jeroenweij/kat/Inspiratie.png

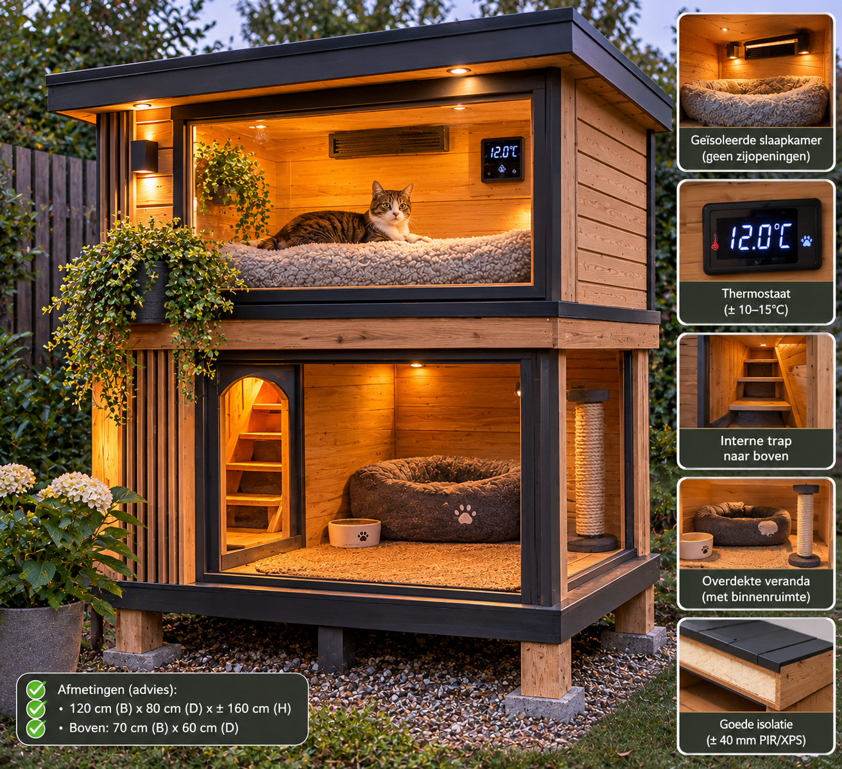
Inspiratie.png
