jeroenweij/kat/bouwplan/Kattenchalet_mal_trapboom.pdf

## Mal trapboom, ware grootte (1:1) - blad 1 van 4

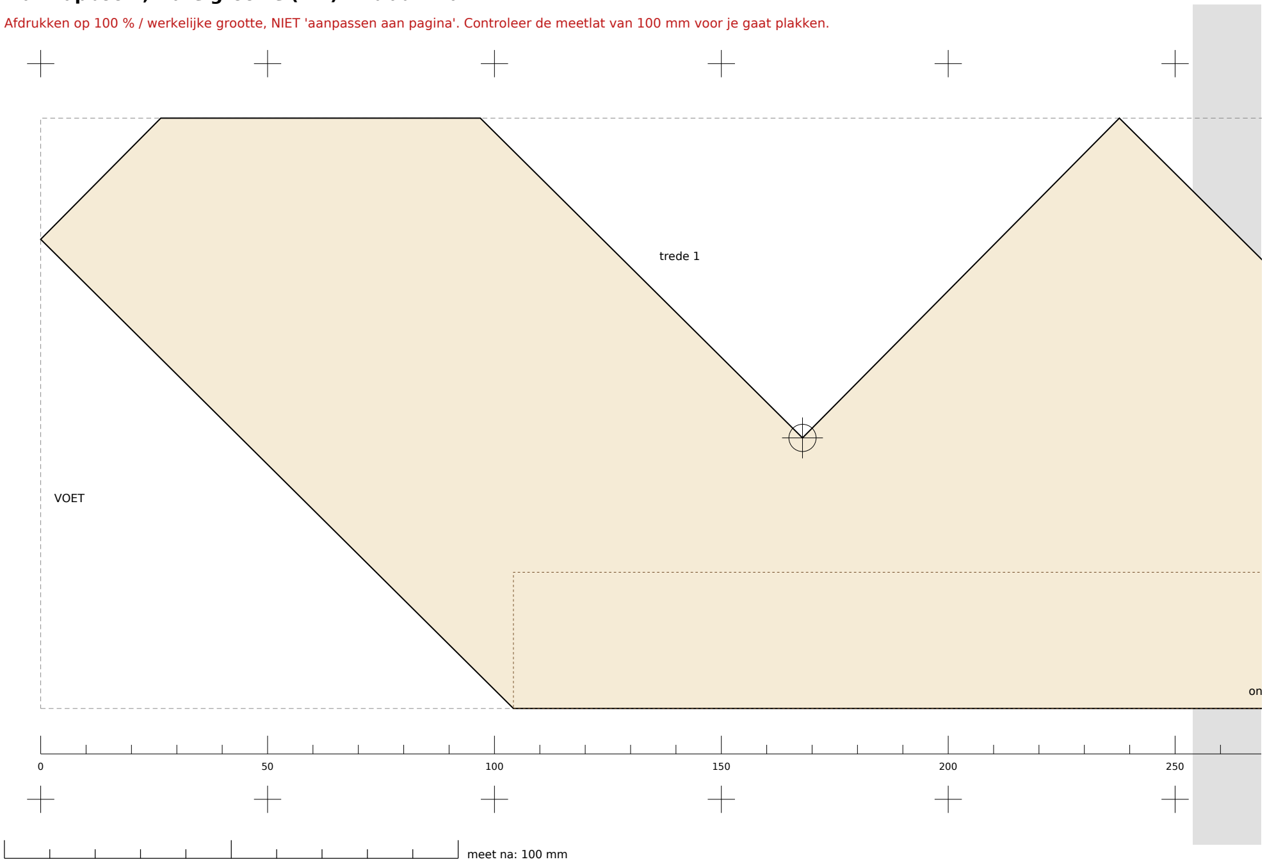
[picture p2: figure]
VOET; trede 1; trede 2; trede 3; trede 4; meet na: 100 mm

Afdrukken op 100 % / werkelijke grootte, NIET 'aanpassen aan pagina'. Controleer de meetlat van 100 mm voor je gaat plakken.

PLAKRAND: leg de knipkant van blad 2 op de lijn

onderkant = rechte kant van het plaatstuk: niet zagen

## Mal trapboom, ware grootte (1:1) - blad 2 van 4

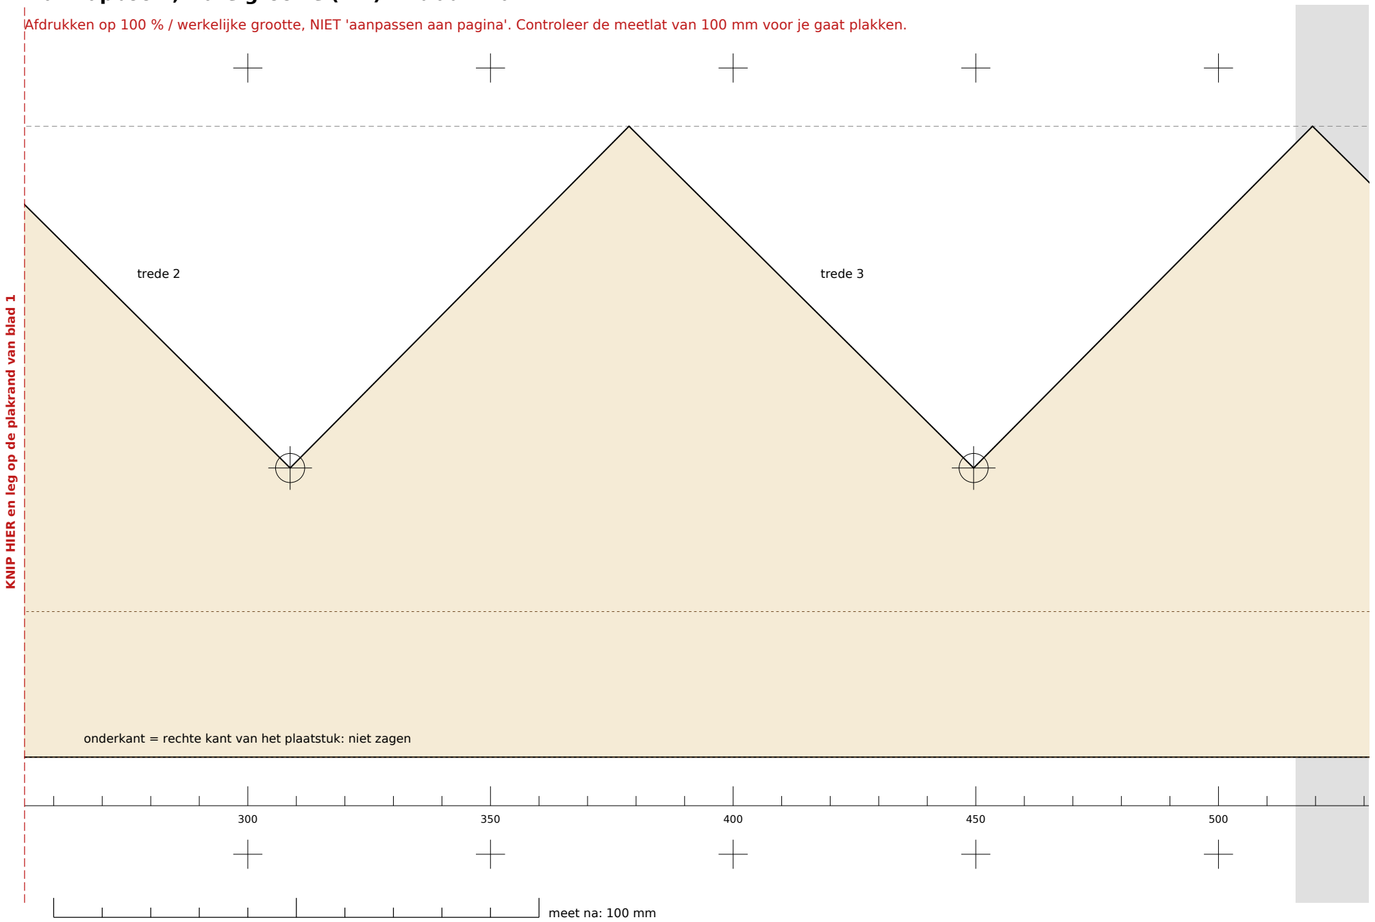
[picture p3: figure]
trede 1; trede 2; trede 3; trede 4

PLAKRAND: leg de knipkant van blad 3 op de lijn

onderkant = rechte kant van het plaatstuk: niet zagen

KNIP HIER en leg op de plakrand van blad 1

## Mal trapboom, ware grootte (1:1) - blad 3 van 4

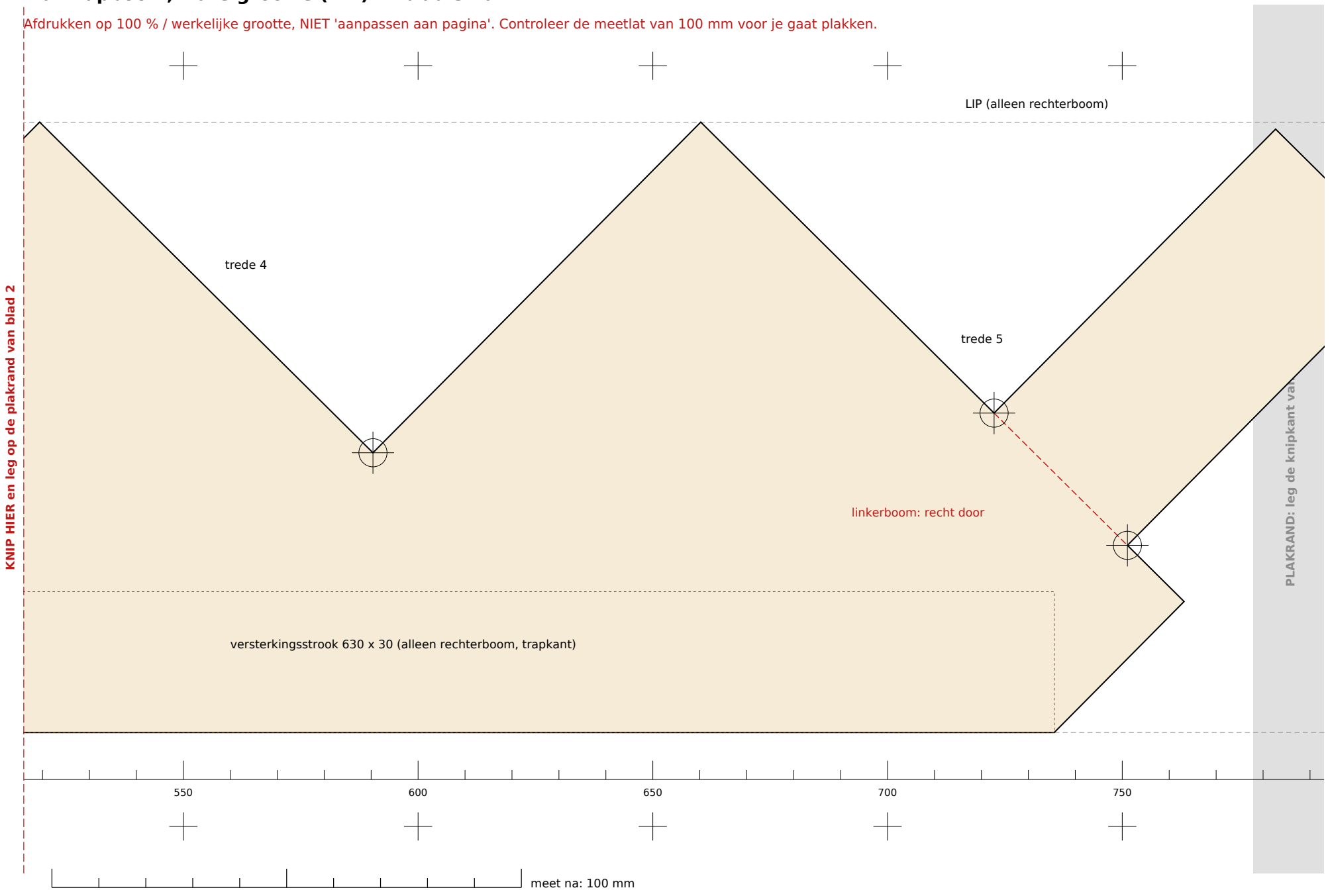
[picture p4: figure]
LIP (alleen rechterboom); linkerboom: recht door; trede 1; trede 2; trede 3; trede 4; trede 5

PLAKRAND: leg de knipkant van blad 4 op de lijn

versterkingsstrook 630 x 30 (alleen rechterboom, trapkant)

KNIP HIER en leg op de plakrand van blad 2

## Mal trapboom, ware grootte (1:1) - blad 4 van 4

800

KNIP HIER en leg op de plakrand van blad 3

Werkwijze
1. Print op 100 % en meet de meetlat na.
2. Knip blad 2, 3 en 4 links af op de rode stippellijn.
3. Leg elk blad op de grijze plakrand van het vorige: paskruisjes, meetlat en lijnen moeten gelijk lopen. Plakband.
4. Leg de grijze stippelrechthoek (plaatstuk 815 x 130)
op het plaatstuk: onderkant op de rechte lange kant, linkerkant op de kopse kant (voet).
5. Plak vast met spuitlijm of dubbelzijdige tape.
6. Boor eerst de 6 gaten Ø6 (kruisjes = hart).
7. Zaag op de dikke lijn, aan de afvalkant, naar de gaten toe, nooit erlangs (ca. 60 mm hout over).
8. Rechterboom met lip eerst; daarna als mal voor de linkerboom, die recht doorloopt (rode stippellijn). Treden: optrede 99, zitvlakken 150/100/100/100/145; trede 1 steekt 50 mm voorbij zijn tand.
Bron: model.py; papier kan iets krimpen of rekken, dus controleer de totale lengte 815 op het hout.
