jeroenweij/kat/bouwplan/Kattenchalet_zaagplannen_bouwmarkt.pdf

Zaagopdracht | Plaat 1 van 4

Betonplex 12 mm, 2500 x 1250 mm, Hornbach art. 12628592

9 zaagsneden, in de volgorde 1, 2, 3 ... Elke snede gaat door het hele stuk. Maten in mm.

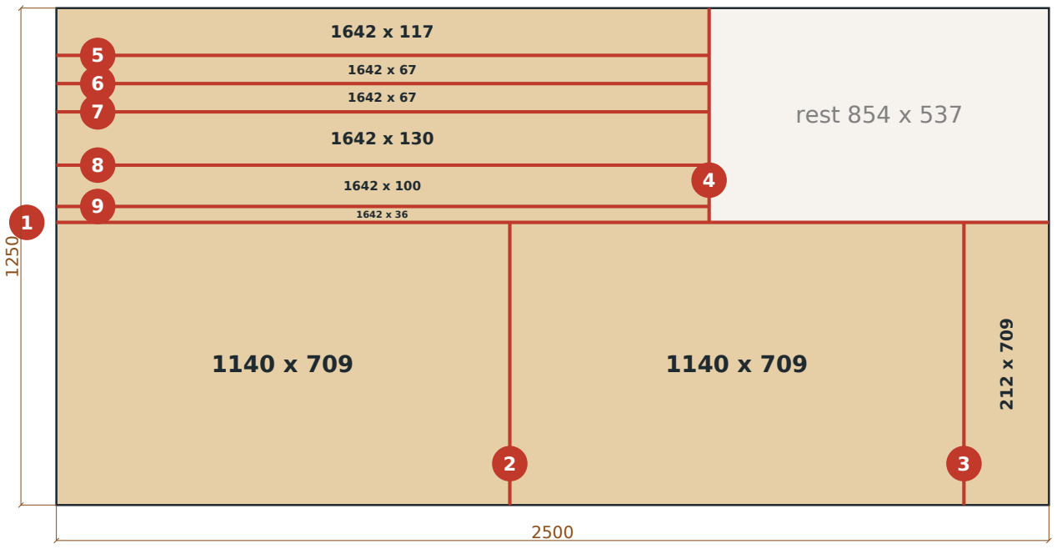
[picture p5: figure]
rest 854 x 537

Nr | Zaag uit stuk | Richting | Op maat | Geeft
1 | 2500 x 1250 | in de lengte | 709 | 2500 x 709 en 2500 x 537
2 | 2500 x 709 | dwars | 1140 | 1140 x 709 en 1356 x 709
3 | 1356 x 709 | dwars | 1140 | 1140 x 709 en 212 x 709
4 | 2500 x 537 | dwars | 1642 | 1642 x 537 en 854 x 537
5 | 1642 x 537 | in de lengte | 117 | 1642 x 117 en 1642 x 416
6 | 1642 x 416 | in de lengte | 67 | 1642 x 67 en 1642 x 345
7 | 1642 x 345 | in de lengte | 67 | 1642 x 67 en 1642 x 274
8 | 1642 x 274 | in de lengte | 130 | 1642 x 130 en 1642 x 140
9 | 1642 x 140 | in de lengte | 100 | 1642 x 100 en 1642 x 36

Zaagsnede circa 4 mm; die valt steeds in het tweede stuk. Een snede met 'smal strookje' zaagt het laatste stuk op maat. Graag alle stukken en resten meegeven.

Zaagopdracht | Plaat 2 van 4

LIGHTPLY multiplex ongegrond 9 mm, 2440 x 1220 mm, Hornbach art. 12575686 (plaat 1 van 2)

5 zaagsneden, in de volgorde 1, 2, 3 ... Elke snede gaat door het hele stuk. Maten in mm.

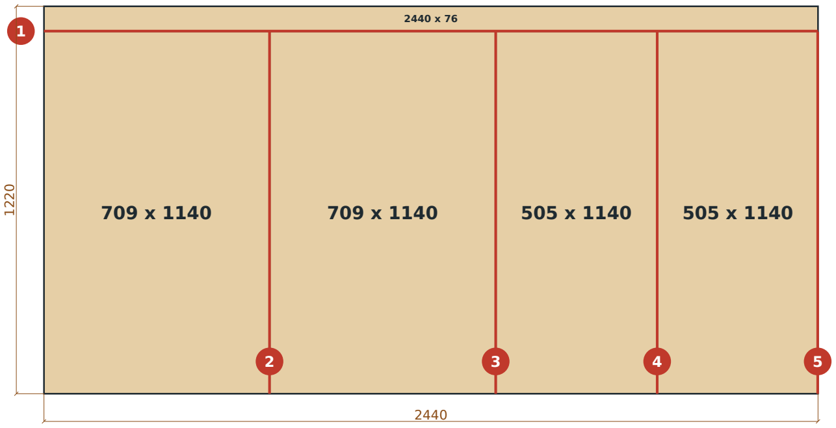
[picture p6: figure]

Nr | Zaag uit stuk | Richting | Op maat | Geeft
1 | 2440 x 1220 | in de lengte | 1140 | 2440 x 1140 en 2440 x 76
2 | 2440 x 1140 | dwars | 709 | 709 x 1140 en 1727 x 1140
3 | 1727 x 1140 | dwars | 709 | 709 x 1140 en 1014 x 1140
4 | 1014 x 1140 | in de lengte | 505 | 505 x 1140 en 505 x 1140
5 | ca. 505 x 1140 | in de lengte | 505 | 505 x 1140 en smal strookje (afval)

Zaagopdracht | Plaat 3 van 4

LIGHTPLY multiplex ongegrond 9 mm, 2440 x 1220 mm, Hornbach art. 12575686 (plaat 2 van 2)

5 zaagsneden, in de volgorde 1, 2, 3 ... Elke snede gaat door het hele stuk. Maten in mm.

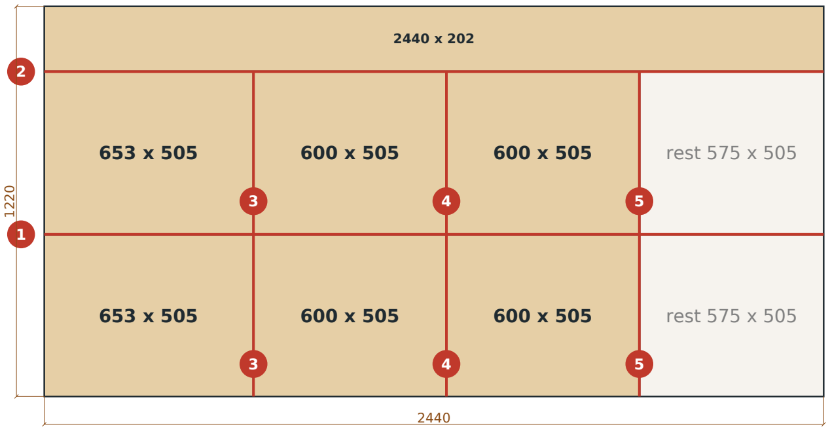
[picture p7: figure]
rest 575 x 505

Nr | Zaag uit stuk | Richting | Op maat | Geeft
1 | 2440 x 1220 | in de lengte | 505 | 2440 x 505 en 2440 x 711
2 | 2440 x 711 | in de lengte | 505 | 2440 x 505 en 2440 x 202
3 | 2 stroken 2440 x 505 op elkaar | dwars | 653 | 2 x 653 x 505 en 2 x 1783 x 505
4 | 2 stroken 1783 x 505 op elkaar | dwars | 600 | 2 x 600 x 505 en 2 x 1179 x 505
5 | 2 stroken 1179 x 505 op elkaar | dwars | 600 | 2 x 600 x 505 en 2 x 575 x 505

Gelijke stroken: leg ze op elkaar en zaag ze in één keer; hetzelfde nummer staat dan op beide stroken.

Zaagopdracht | Plaat 4 van 4

OSB-3 11 mm, 2440 x 1220 mm, Hornbach art. 10222931

4 zaagsneden, in de volgorde 1, 2, 3 ... Elke snede gaat door het hele stuk. Maten in mm.

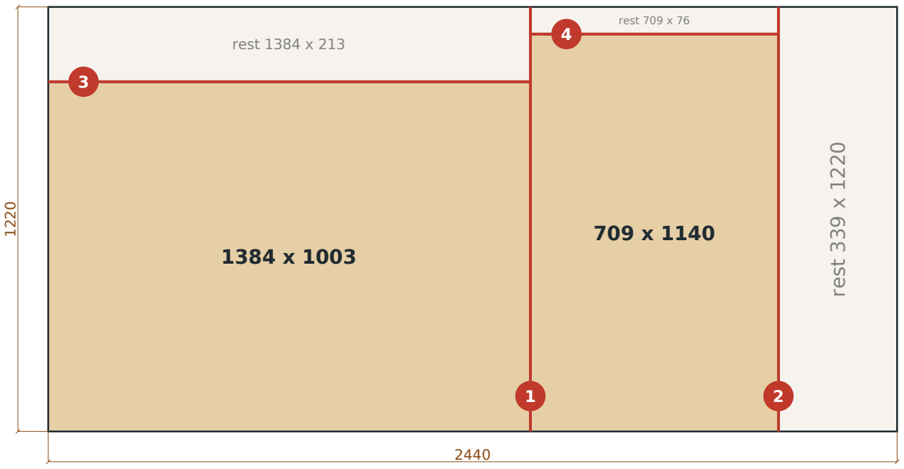
[picture p8: figure]
rest 1384 x 213; rest 709 x 76; rest 339 x 1220

Nr | Zaag uit stuk | Richting | Op maat | Geeft
1 | 2440 x 1220 | dwars | 1384 | 1384 x 1220 en 1052 x 1220
2 | 1052 x 1220 | in de lengte | 709 | 709 x 1220 en 339 x 1220
3 | 1384 x 1220 | in de lengte | 1003 | 1384 x 1003 en 1384 x 213
4 | 709 x 1220 | dwars | 1140 | 709 x 1140 en 709 x 76
