jeroenweij/kat/bouwplan/Kattenchalet_boodschappenlijst_winkel.pdf

# Kattenchalet: zelf pakken bij Hornbach Den Haag

Alleen wat je in de bestellijst op Zelf pakken / uitzoeken hebt gezet. Wat je bij Hornbach en Drive In hebt besteld, staat hier niet op. Vul de gang en het vak in vanuit de Hornbach-app of -site; die geeft de plek per vestiging.
Meenemen: de 4 zaagopdrachten (geprint), rolmaat, deze lijst, pen. In de winkel: een plaatwagen en een lattenwagen. Vervoer: latten van 3,6 m en platen tot 2,5 m (de betonplex en OSB komen gezaagd mee, de rest heel). Controleer of dat in je auto past, of huur een bus of aanhanger.

## 1. Plaatmateriaal en zaagservice: als eerste, want zagen duurt even

Geef de 4 zaagopdrachten af (Kattenchalet_zaagplannen_bouwmarkt.pdf, 1 A4 per plaat). Wijs bij elke plaat de mooiste kant aan. Haal de rest terwijl ze zagen.
Artikel | Aantal | Gang | Let op / controleren
Betonplex Acacia 2500 x 1250 x 12 mm art. 12628592 | 1 plaat | | Hoeken en randen heel, film aan beide kanten, niet krom. Zaagopdracht 1: 9 snedes. Neem alle stroken mee, ook de smalle van 36 en de rest van 854 x 537 (bewaren).
LIGHTPLY multiplex ongegrond 9 mm, 2440 x 1220 art. 12575686 | 2 platen | | Wordt blank gelakt, dus het fineer is zichtbaar: geen deuken, scheuren of open naden, plaat vlak. Zaagopdrachten 2 en 3, 5 snedes per plaat. Vraag om zo splintervrij mogelijk te zagen. Plaat 2: de twee stroken van 505 gestapeld op lengte laten zagen.
OSB-III 4-zijdig recht 2440 x 1220 x 11 mm art. 10222931 | 1 plaat | | Echt 11 mm (geen 12 of 18), OSB-3 op het etiket, randen heel. Zaagopdracht 4: 4 snedes. Neem de rest van 709 x 76 en 339 x 1220 ook mee.

## 2. Hout: latten en balken

Zoek elk stuk zelf uit: kijk vanaf het kopse eind langs de lat. Ze moeten recht zijn, niet getordeerd (scheluw), zonder losse of grote kwasten aan de rand en zonder scheuren aan de kop. De zaaglijst is krap: meet een paar latten na.
Artikel | Aantal | Gang | Let op / controleren

KONSTA vuren geschaafd 44 x 69 x ca.

3600 art. 5185891 | 4 st | | Minstens 3590 mm lang: de indeling houdt per lat maar 13-129 mm over. Ook 44 x 69 nameten.

KONSTA vuren geschaafd 44 x 69 x ca.

2400 art. 5185888 | 12 st | | Minstens 2390 mm lang. Recht is het belangrijkst: hier worden de wandframes van gemaakt.
Regel geschaafd geïmpregneerd grenen 4,5 x 6,8 x 360 cm art. 4178220 | 2 st | | Voor het vloerframe. Niet kletsnat (een zware lat is nat), recht. Op 45 x 68 rekenen (plan: 44 x 69, dat geeft niet).
Paal vierkant grenen geïmpregneerd 6,8 x 6,8 x 180 cm art. 4168915 | 1 st | | Recht en zonder scheur in de lengte. Je zaagt er 6 poten van 95 mm uit.
Lat/regel geïmpregneerd grenen 2,1 x 4,5 x 250 cm art. 2094248 | 10 st | | Spouwlatten. Recht. Vraag of lees de gebruiksklasse (3 is gewenst) en noteer die.
Douglas dakbeschot/blokhutprofiel 1,8 x 14,5 x 300 cm art. 10537457 | 16 st | | Gevel, dus zichthout: mooiste planken, tong en groef heel, weinig kwasten, niet krom of hol. Meet een plank: de breedte zonder tong en groef moet meer dan 130 mm zijn, anders klopt de stroken-indeling niet (zeg het dan tegen mij).

## 3. IJzerwaren en profielen

Artikel | Aantal | Gang | Let op / controleren
HETTICH Stelvoet M10 x 75 mm Ø 75 mm RVS art. 4297033 | 6 st | | Voor onder de poten. Controleer: aan de voet zit een draadstift M10 (geen gat met binnendraad), en de draad is lang genoeg om minstens 60 mm te verstellen. Meet de draadlengte en de dikte van de voet en noteer die. Op 12-11 had Breda er 9; kijk in de app of Den Haag er 6 heeft.
DRESSELHAUS Inslagmoer 10 x 13 mm galv. verzinkt, 4 st art. 3857241 | 2 pak | | Draai hem op de stelvoet: de draad moet passen. Vraag of er een RVS-versie is (Marinetech M10 x 12); die roest niet. Neem dan die.
RVS zeskantmoer M10 | 6 st | | Contramoer onder de poot. Los uit de bak, RVS (A2 of A4). Past op de stelvoet.

TOX kozijnschroef Window Pro SK 7,5 x

112 art. 5721305 | 1 pak | | Op de verpakking: geschikt voor hout (niet alleen beton of steen) en voor kunststof kozijnen; verzonken kop, lengte 112. Niet geschikt? Neem dan DRESSELHAUS 6541412.
Kunststof wig zwart 6 mm, zak 50 st art. 3067127 | 1 zak | | Echt 6 mm dik (zwart). Voor de kopvoeg van 5 mm boven de ramen.
GAH.ALBERTS lekdorpelprofiel 34 x 17 mm alu blank 200 cm art. 10295993 | 1 st | | Vorm controleren: een T-profiel, met een staande zijde om tegen de band te schroeven en een uitstekende druiprand. Geen deuken of buigingen. Je zaagt er 1070 + 600 uit.
KAISERTHAL ronde buis Ø 7 x 1 mm kunststof wit 100 cm art. 4249568 | 1 st | | Afstandsbusjes voor de matverwarming. Controleer dat jouw schroef of bout door de binnenmaat (ca. 5 mm) past.

## Nog niet ingedeeld: meteen meenemen?

Deze regels staan in de bestellijst nog zonder keuze. Er is nog geen artikel gekozen, dus zoek ter plekke uit wat past.

Alu-tape voor de PIR-naden, ca. 50 mm | Nodig zodra de PIR erin gaat. Geen gewone folietape.
Hoekankers met schroeven (ca. 14 st) | Die bij de poten (poot aan het frame) thermisch verzinkt of RVS.
Buitenkit, geschikt voor kunststof | Voor de zijvoegen tussen kozijn en stijl. Ook voor de rand van de inslagmoeren.
RVS consoles voor de regenluifel (5 st) | Liggend been korter dan 91 mm, staand been 40-75 mm.
Kiepbeveiliging (2 st) en afsluitbare raamgreep (2 st) | Kiepbeveiliging is een veiligheidseis voor de kat. Neem het raamtype mee om de passing te controleren.
Spanband met ratel, ca. 6 m | Pas nodig als het chalet buiten staat: tijdelijk vastzetten aan de schutting bij code oranje voor wind.

Niet nu: de bevestiging aan de schutting (afstandhouders en RVS hoekankers). Die volgt pas als het chalet af is en de palen zijn gemeten.

Bij de kassa: klopt het aantal? 4 + 12 vuren 44 x 69, 2 geïmpregneerde regels, 10 spouwlatten, 16 Douglas, 1 paal, 6 stelvoeten, alle gezaagde stukken van 4 platen.
