jeroenweij/kat/bouwplan/Kattenchalet_bouwplan.pdf

Kattenchalet bouwplan | Rev K, 6-11-2026 | Titel en inhoud, pagina 1

# Kattenchalet

Bouwplan

Een modern houten buitenverblijf voor een kat die ook 's nachts buiten blijft. Twee verdiepingen: boven een geïsoleerde bovenkamer, beneden een trapkamer en een veranda met open voorkant. Toegang voor het onderhoud via de ramen, die vanaf buiten opengaan. Het chalet staat op 6 stelvoeten los op het terras, met de rug naar de schutting, en wordt later aan de schutting vastgezet.

Hoofdmaten

Onderdeel | Maat (mm)
Buitenmaat | 1220 x 789, hoogte 1458; dak 1420 x 1039
Bovenkamer | 984 x 600 x 505, raam 1000 x 500
Trapkamer | 484 x 600 x 505, raam 500 x 500, trap langs de linkerwand
Veranda | 413 x 671 x 505, kattenluik naar de trapkamer
Gewicht | ongeveer 209 kg

Inhoud

Blad | Onderwerp
T1 | Overzicht 3D
T2 | Aanzichten voor en achter
T3 | Aanzichten zijkanten
T4, T5 | Doorsneden
T6 | Plattegronden, vloerframe en tussenvloer
T7 | Plafond, dak en spoor
T8, T9 | Wandframes beneden en boven
T10 | Details
T11, T12 | Zaagplannen platen, balken en latten
T13 | Montagevolgorde
T14 | Kattenluik in de scheidingswand
T15 | Trap en betonplex thuis zagen
Daarna | Zaaglijst, stappenplan en onderhoud

Zo lees je dit plan
- Maten in mm. Hoogtes gemeten vanaf de hoogste terrastegel. Links en rechts zijn altijd gezien vanaf de voorkant, ook als je achter het chalet staat.
- Meet niet van de tekening, maar gebruik de maatgetallen. Zaag sparingen pas als de ramen binnen zijn en ingemeten.
- Bladen met een letter (T2a, T2b) horen bij elkaar; een verwijzing naar blad T2 bedoelt ze allebei.
- Apart: het Excel-bestand Kattenchalet_zaag_en_inkooplijst.xlsx (zaaglijst, inkoop, latten op lengte, platen op maat) en Kattenchalet_zaagplannen_bouwmarkt.pdf (de zaagopdracht per plaat voor de bouwmarkt).

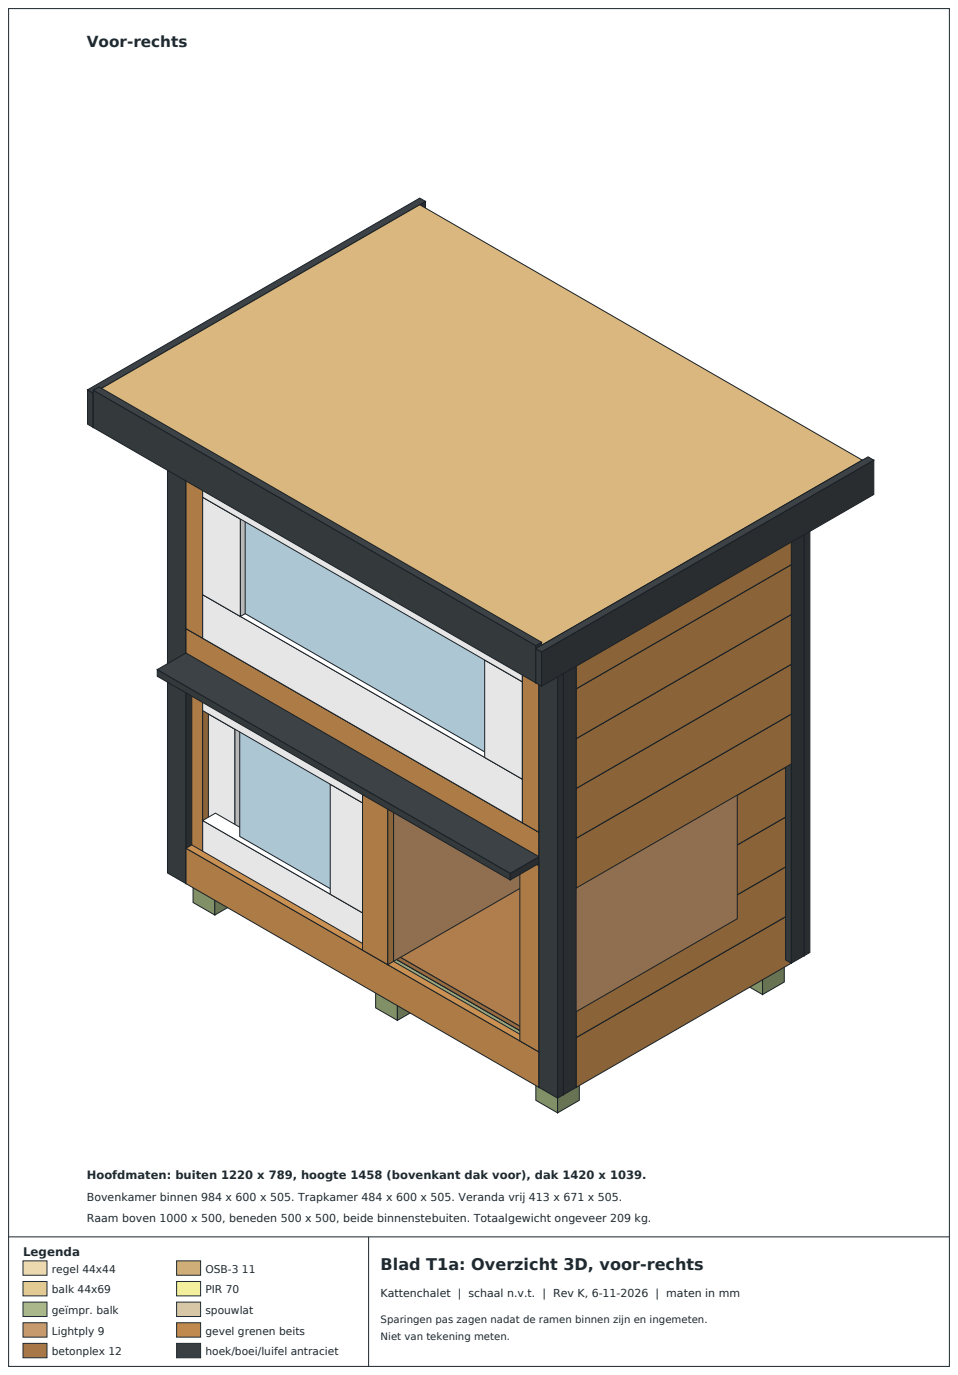
[picture p9: page 2]
Voor-rechts; regel 44x44; balk 44x69; geïmpr. balk; Lightply 9; betonplex 12

Hoofdmaten: buiten 1220 x 789, hoogte 1458 (bovenkant dak voor), dak 1420 x 1039.

Bovenkamer binnen 984 x 600 x 505. Trapkamer 484 x 600 x 505. Veranda vrij 413 x 671 x 505.

Raam boven 1000 x 500, beneden 500 x 500, beide binnenstebuiten. Totaalgewicht ongeveer 209 kg. Legenda

OSB-3 11
PIR 70
spouwlat
gevel grenen beits
hoek/boei/luifel antraciet

Blad T1a: Overzicht 3D, voor-rechts

Kattenchalet | schaal n.v.t. | Rev K, 6-11-2026 | maten in mm

Sparingen pas zagen nadat de ramen binnen zijn en ingemeten.
Niet van tekening meten.

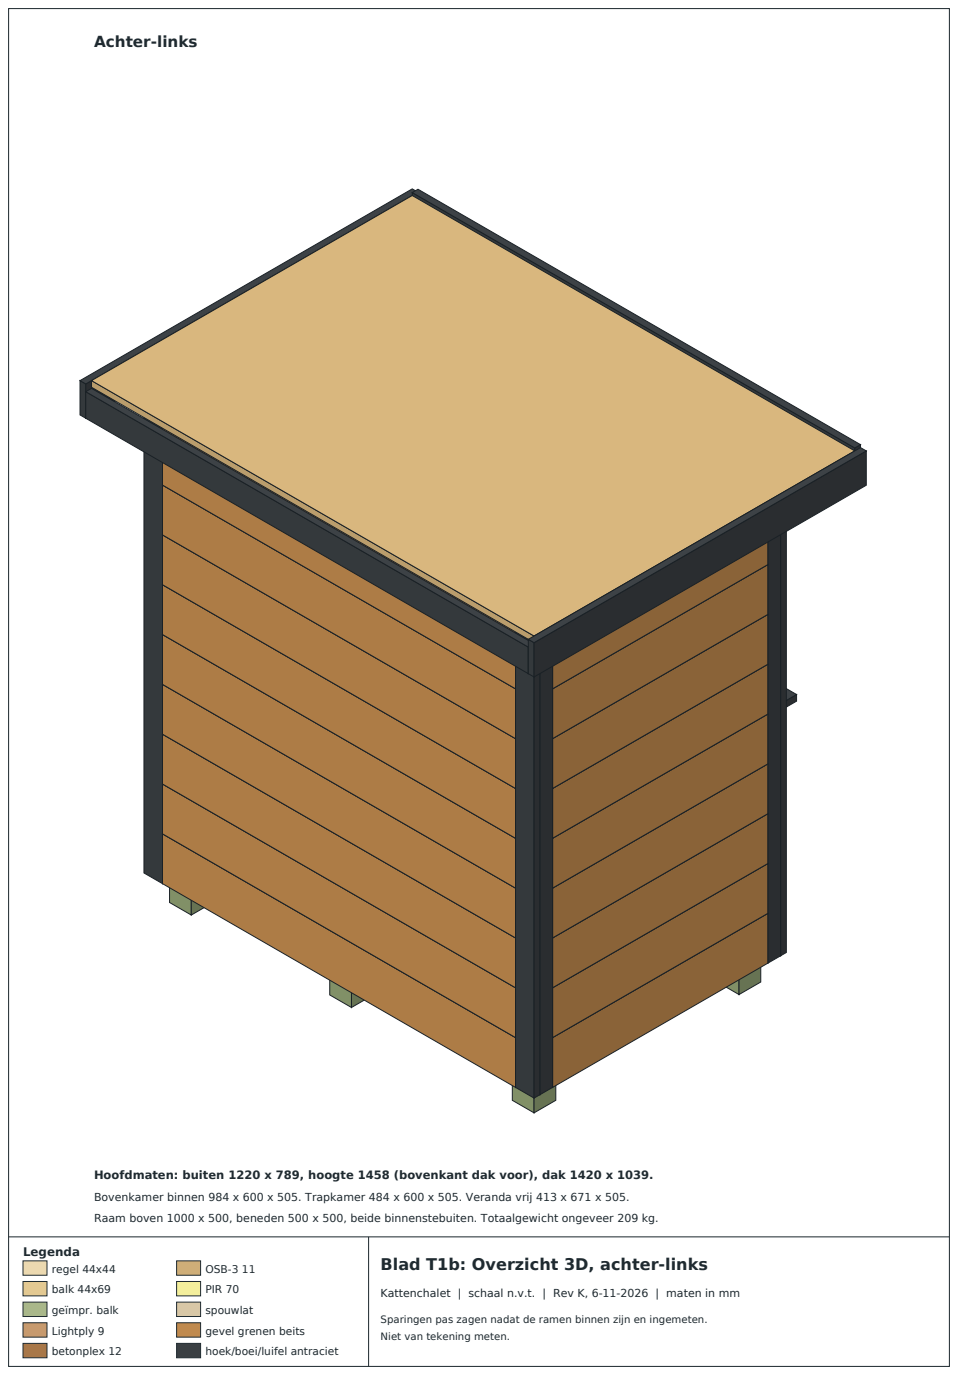
[picture p10: page 3]
Achter-links; regel 44x44; balk 44x69; geïmpr. balk; Lightply 9; betonplex 12

Hoofdmaten: buiten 1220 x 789, hoogte 1458 (bovenkant dak voor), dak 1420 x 1039.

Bovenkamer binnen 984 x 600 x 505. Trapkamer 484 x 600 x 505. Veranda vrij 413 x 671 x 505.

Raam boven 1000 x 500, beneden 500 x 500, beide binnenstebuiten. Totaalgewicht ongeveer 209 kg. Legenda

OSB-3 11
PIR 70
spouwlat
gevel grenen beits
hoek/boei/luifel antraciet

Blad T1b: Overzicht 3D, achter-links

Kattenchalet | schaal n.v.t. | Rev K, 6-11-2026 | maten in mm

Vooraanzicht

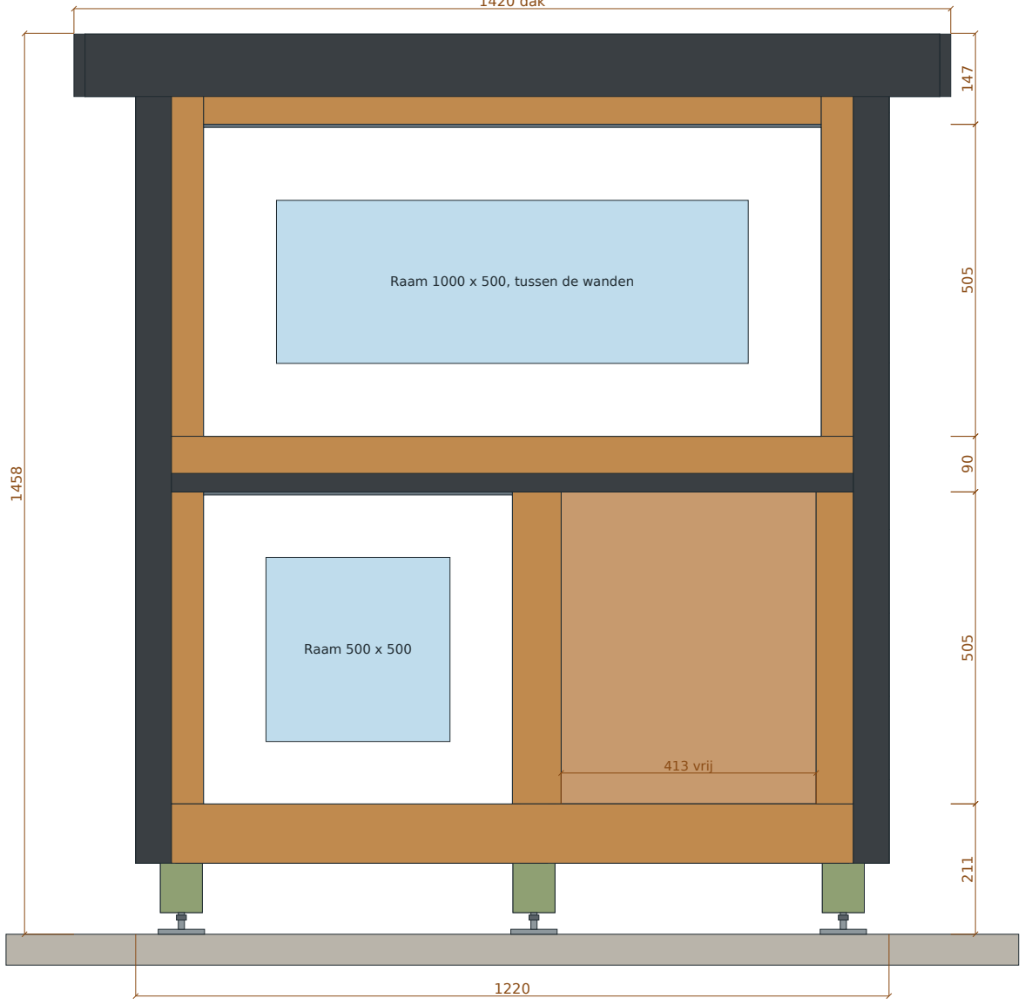
[picture p11: figure]
Raam 1000 x 500, tussen de wanden; Raam 500 x 500; 413 vrij

1420 dak

Hoeklatten, boeiboorden en regenluifel in antraciet beits, de rest van de gevel met kader en band in grenen beits. Tekenkleur indicatief; nerf blijft zichtbaar. Plankmaten: zie zaaglijst. Luifel tussen de hoeklatten.

Legenda
regel 44x44

balk 44x69

geïmpr. balk

Lightply 9

betonplex 12

OSB-3 11

PIR 70

spouwlat

gevel grenen beits

hoek/boei/luifel antraciet

Blad T2a: Vooraanzicht

Kattenchalet | schaal 1:10 | Rev K, 6-11-2026 | maten in mm

Achteraanzicht (van achteren gezien)

1220

1436

Hoeklatten, boeiboorden en regenluifel in antraciet beits, de rest van de gevel met kader en band in grenen beits. Tekenkleur indicatief; nerf blijft zichtbaar. Plankmaten: zie zaaglijst. Luifel tussen de hoeklatten.

Legenda
regel 44x44

balk 44x69

geïmpr. balk

Lightply 9

betonplex 12

OSB-3 11

PIR 70

spouwlat

gevel grenen beits

hoek/boei/luifel antraciet

Blad T2b: Achteraanzicht

Kattenchalet | schaal 1:10 | Rev K, 6-11-2026 | maten in mm

Linkeraanzicht (voorzijde rechts), geen openingen

Legenda
regel 44x44

balk 44x69

geïmpr. balk

Lightply 9

betonplex 12

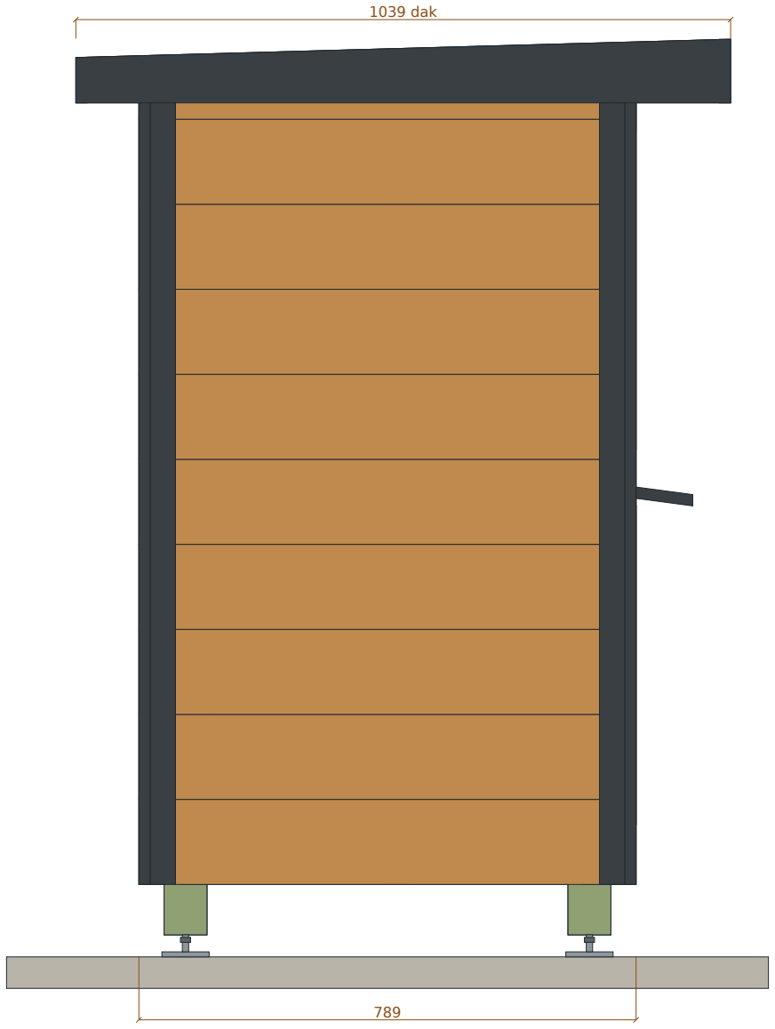
[picture p12: figure]
1039 dak

OSB-3 11

PIR 70

spouwlat

gevel grenen beits

hoek/boei/luifel antraciet

Blad T3a: Linkeraanzicht

Kattenchalet | schaal 1:10 | Rev K, 6-11-2026 | maten in mm

Rechteraanzicht (voorzijde links), geheel dicht

Legenda
regel 44x44

balk 44x69

geïmpr. balk

Lightply 9

betonplex 12

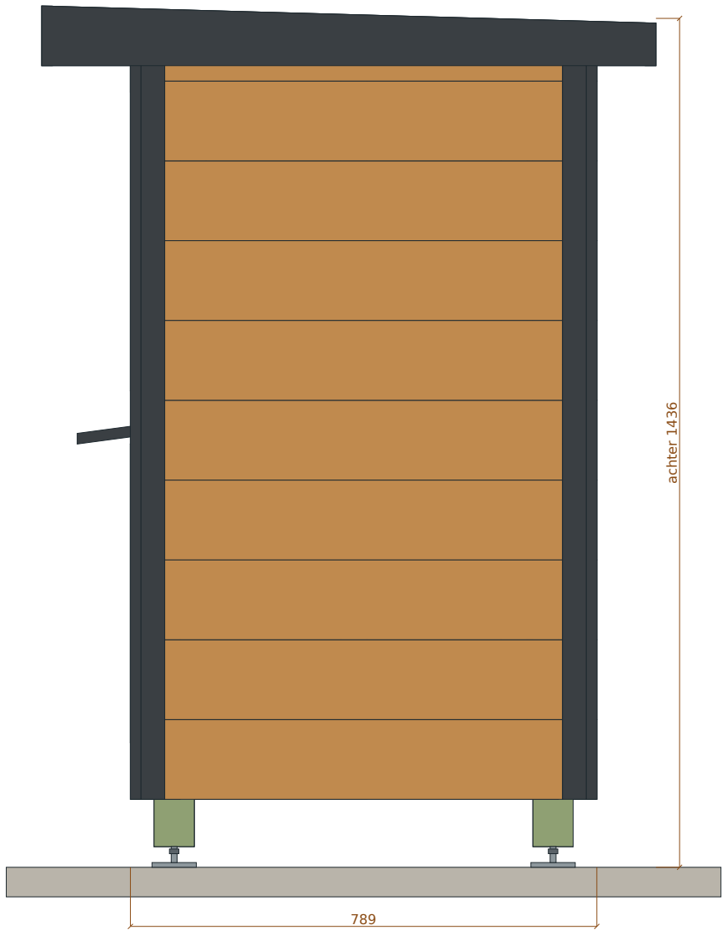
[picture p13: figure]
achter 1436

OSB-3 11

PIR 70

spouwlat

gevel grenen beits

hoek/boei/luifel antraciet

Blad T3b: Rechteraanzicht

Kattenchalet | schaal 1:10 | Rev K, 6-11-2026 | maten in mm

A-A: door trap, trapgat en bovenkamer (x = 215)

Legenda
regel 44x44

balk 44x69

geïmpr. balk

Lightply 9

betonplex 12

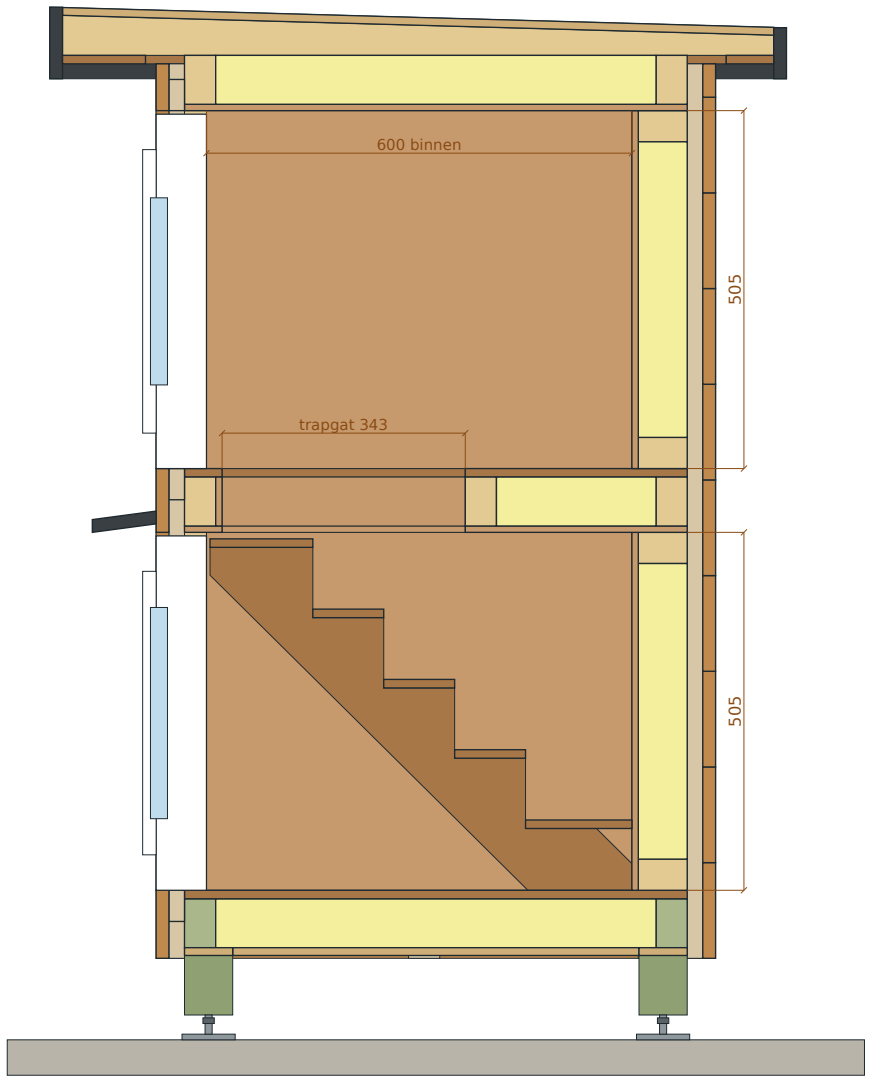
[picture p14: figure]
600 binnen; trapgat 343

OSB-3 11

PIR 70

spouwlat

gevel grenen beits

hoek/boei/luifel antraciet

Blad T4a: Doorsnede A-A

Kattenchalet | schaal 1:10 | Rev K, 6-11-2026 | maten in mm

B-B: door veranda en bovenkamer (x = 908)

Legenda
regel 44x44

balk 44x69

geïmpr. balk

Lightply 9

betonplex 12

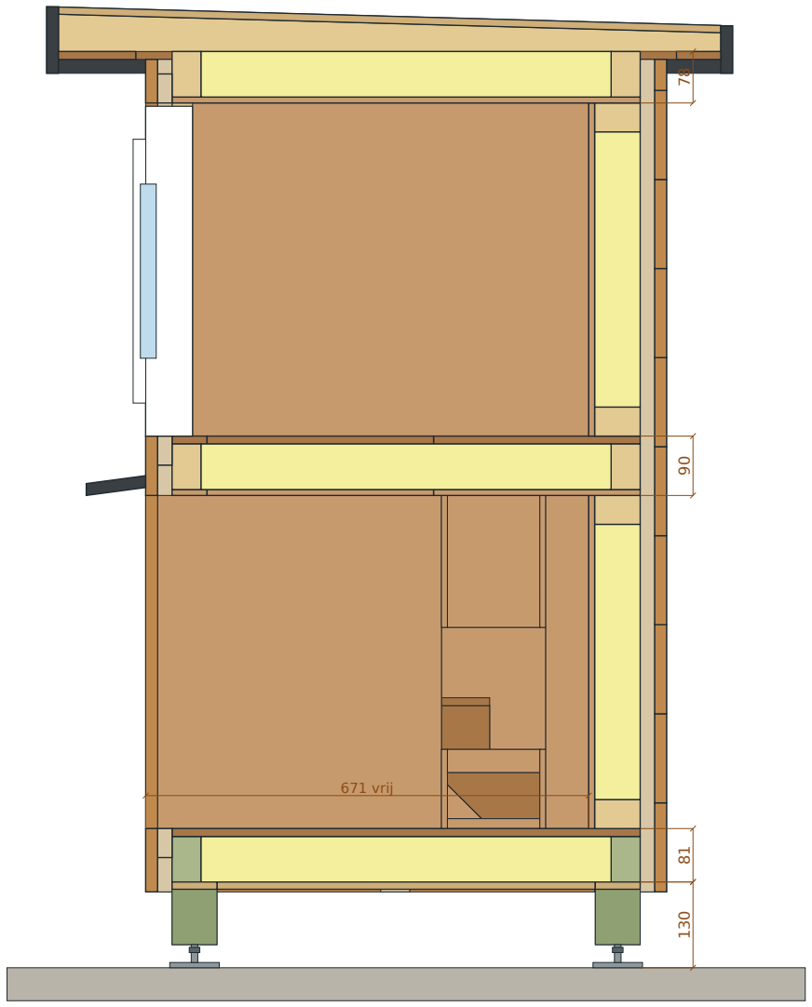
[picture p15: figure]
671 vrij

OSB-3 11

PIR 70

spouwlat

gevel grenen beits

hoek/boei/luifel antraciet

Blad T4b: Doorsnede B-B

Kattenchalet | schaal 1:10 | Rev K, 6-11-2026 | maten in mm

C-C: door de ramen, kijkrichting achter (y = 30)

raam | 1000
raam | 500

Legenda
regel 44x44

balk 44x69

geïmpr. balk

Lightply 9

betonplex 12

OSB-3 11

PIR 70

spouwlat

gevel grenen beits

hoek/boei/luifel antraciet

Blad T5a: Doorsnede C-C

Kattenchalet | schaal 1:10 | Rev K, 6-11-2026 | maten in mm

D-D: door doorgang en trap, kijkrichting achter (y = 527)

984 binnen

484 binnen | 413

Legenda
regel 44x44

balk 44x69

geïmpr. balk

Lightply 9

betonplex 12

OSB-3 11

PIR 70

spouwlat

gevel grenen beits

hoek/boei/luifel antraciet

Blad T5b: Doorsnede D-D

Kattenchalet | schaal 1:10 | Rev K, 6-11-2026 | maten in mm

Beneden, snede z = 500

1220

789

484 | 413 200

Trap langs de linkerwand, kattenluik achterin (doorgang 200 x 310 aan de trapzijde), voorkant veranda open, rechterwand dicht.

Vloerframe, gezien van boven (vloerplaat weg)

Stippellijn: poten 68 x 68 onder het frame.

Legenda
regel 44x44

balk 44x69

geïmpr. balk

Lightply 9

betonplex 12

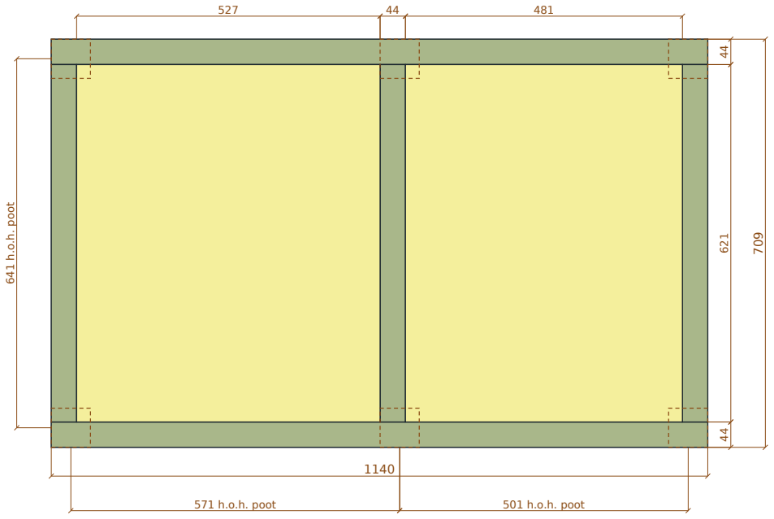
[picture p16: figure]
571 h.o.h. poot; 501 h.o.h. poot; 641 h.o.h. poot

OSB-3 11

PIR 70

spouwlat

gevel grenen beits

hoek/boei/luifel antraciet

Blad T6a: Plattegrond beneden en vloerframe

Kattenchalet | schaal 1:10 | Rev K, 6-11-2026 | maten in mm

Boven, snede z = 1200

1220

984

600

789

gat 247

Raam voor, trapgat linksvoor, afvoer rechtsachter, mand bij het raam rechts van het trapgat.

Tussenvloer: balken en PIR (bovenplaat weg)

Trapgat 247 x 343 in onderplaat en vloerplaat: 78 uit de linkerrand, 53 uit de voorrand.

Legenda
regel 44x44

balk 44x69

geïmpr. balk

Lightply 9

betonplex 12

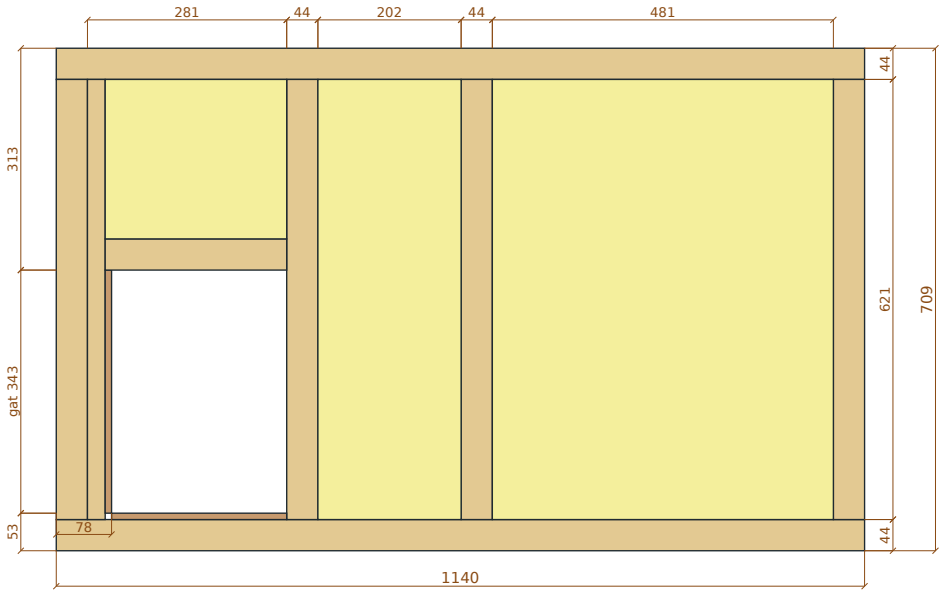
[picture p17: figure]
53 gat 343 313

OSB-3 11

PIR 70

spouwlat

gevel grenen beits

hoek/boei/luifel antraciet

Blad T6b: Plattegrond boven en tussenvloer

Kattenchalet | schaal 1:10 | Rev K, 6-11-2026 | maten in mm

Plafond: balken en PIR (van boven)

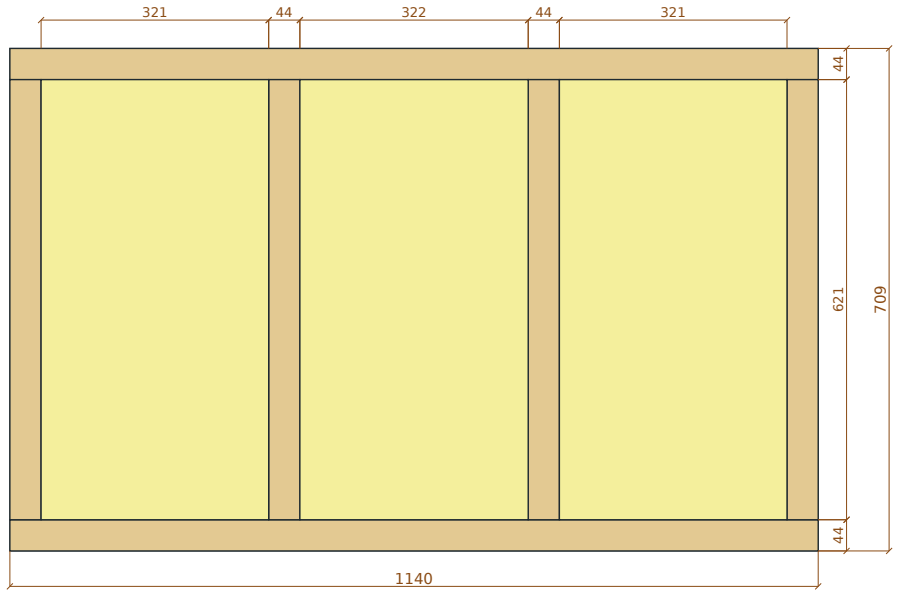
[picture p18: figure]

Spoor, zijaanzicht (4 sporen + 2 zijsporen)

1003

56
29

Uit balk 44x69: schuine zaagsnede. Afschot 1:36 naar de achterkant. Dakgoot achter, afvoer weg van de schutting. Legenda

regel 44x44

balk 44x69

geïmpr. balk

Lightply 9

betonplex 12

OSB-3 11

PIR 70

spouwlat

gevel grenen beits

hoek/boei/luifel antraciet

Blad T7a: Plafond en spoor

Kattenchalet | schaal 1:10 | Rev K, 6-11-2026 | maten in mm

Dak: sporen en overstek (dakplaat weg)

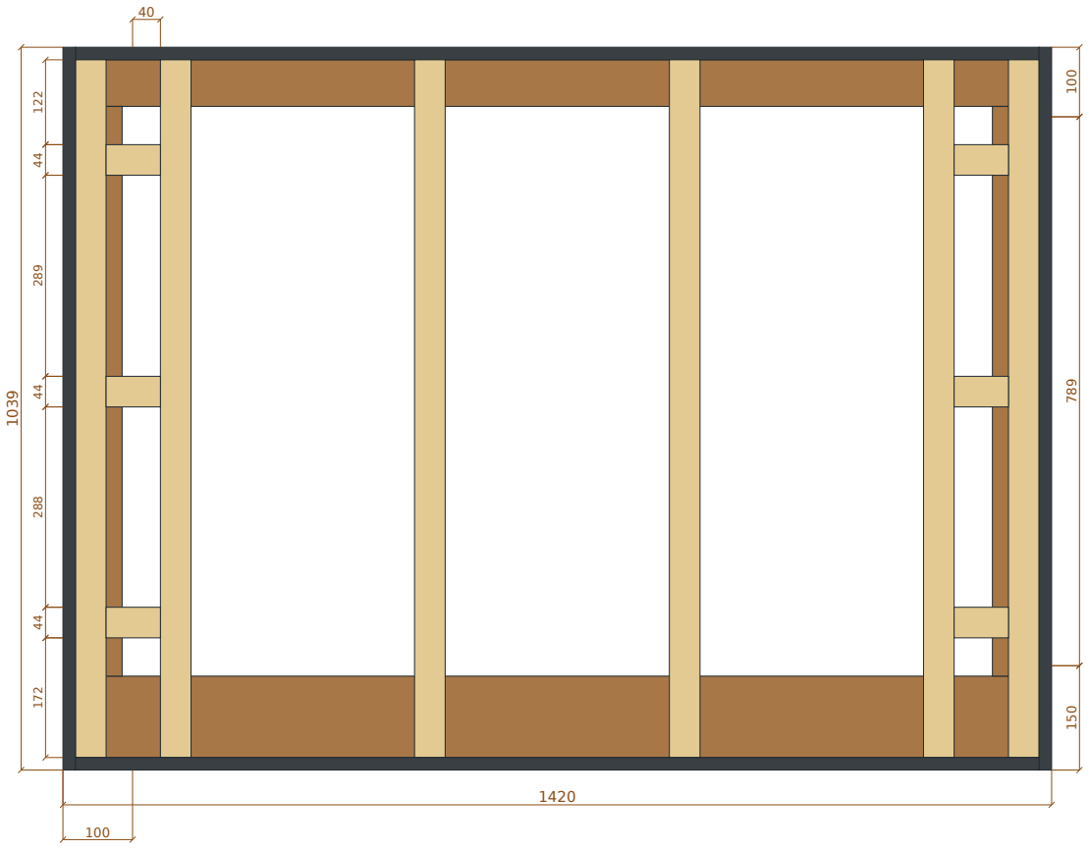
[picture p19: figure]

Links: maten van de rijklossen (78 lang) langs het zijspoor, vanaf de voorkant van de sporen. Rechts: overstek, gevel en dak.

Legenda
regel 44x44

balk 44x69

geïmpr. balk

Lightply 9

betonplex 12

OSB-3 11

PIR 70

spouwlat

gevel grenen beits

hoek/boei/luifel antraciet

Blad T7b: Dak: sporen en overstek

Kattenchalet | schaal 1:10 | Rev K, 6-11-2026 | maten in mm

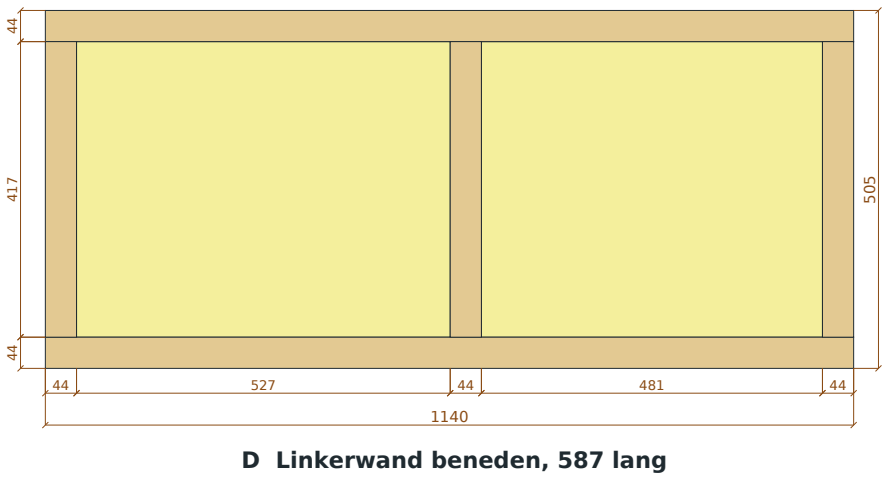
[picture p20: figure]
D Linkerwand beneden, 587 lang

Regelwerk gezien vanaf de BUITENZIJDE. Plaat en spouwlatten zijn weggelaten. Geel = PIR. Maten van wandbegin tot stijl-randen.

B Voorwand beneden, 640 breed

Opening 502 = raam 500 + 2 x 1 speling. Stijlen pas definitief vast als het raam staat.

69 | 502 | 69
| 640

505

C Achterwand beneden, 1140 lang

44 | 499 | 44
| 587

505

44 417 44

Blad T8a: Wandframes beneden B, C en D

Kattenchalet | schaal 1:10 | Rev K, 6-11-2026 | maten in mm

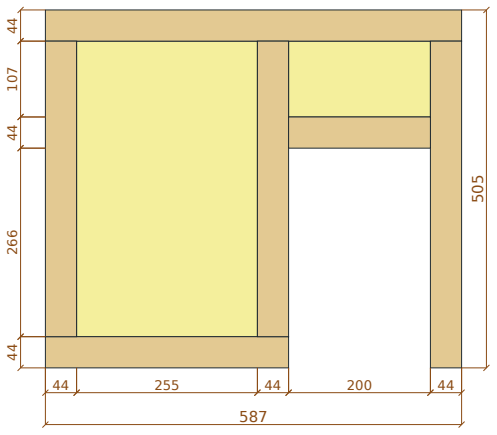
[picture p21: figure]

Regelwerk gezien vanaf de BUITENZIJDE. Plaat en spouwlatten zijn weggelaten. Geel = PIR. Maten van wandbegin tot stijl-randen.

E Scheidingswand, 587 lang

Doorgang 200 x 310; kattenluik 158 x 185 in de verandaplaat, op 120 boven de vloer. Luchtinlaat laag onder het luik.

F Rechterwand beneden, 631 lang, geheel dicht

44 | 543 | 44
| 631

505

44 417 44

Blad T8b: Wandframes beneden E en F

Kattenchalet | schaal 1:10 | Rev K, 6-11-2026 | maten in mm

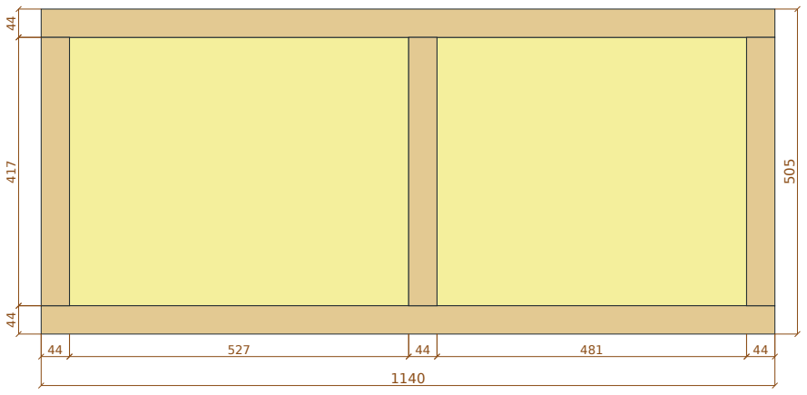
[picture p22: figure]

Regelwerk gezien vanaf de BUITENZIJDE. Plaat en spouwlatten zijn weggelaten. Geel = PIR. Maten van wandbegin tot stijl-randen.

H Voorwand boven, 1140 breed

Opening 1002 = raam 1000 + 2 x 1 speling. Stijlen pas definitief vast als het raam staat.

69 | 1002 | 69
| 1140

505

I Achterwand boven, 1140 lang

Blad T9a: Wandframes boven H en I

Kattenchalet | schaal 1:10 | Rev K, 6-11-2026 | maten in mm

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

J Linkerwand boven, 587 lang

44 | 499 | 44
| 587

505

44 417 44

K Rechterwand boven, 587 lang

44 | 499 | 44
| 587

505

44 417 44

Blad T9b: Wandframes boven J en K

Kattenchalet | schaal 1:10 | Rev K, 6-11-2026 | maten in mm

### 2 Raam binnenstebuiten, onderkant op de vloer, verticaal (1:3)

Vleugel 19 naar buiten; draait en kiept naar buiten

Kozijn 71 diep, gelijk met gevel. Greep zit nu buiten

EPDM 30 omhoog achter kozijn, verlijmd: enige waterkering

EPDM onder het kozijn, over de band, tot op de dorpel

Alu lekdorpelprofiel 34x17 tegen de band, loopt af naar buiten

Lat band: bovenkant gelijk met vloer, kozijn steunt erop

Tussen stijlen 1002 x 505, beneden 502 x 505: 1 mm speling per kant.

Geen dorpellat, geen houten opstand: kozijn direct op vloer.

Schroef 7,5x112 zijkant en boven: max. 150 uit hoek,

max. 600 h.o.h.; onder niet schroeven. Stijlen strak ertegen;

kozijn raakt stijl over 31 mm: voorboren, stijl recht, niet krom.

Controleer de afwateringssleuven op het kozijn: na

omkeren wateren die naar de binnenzijde af, in de goot.

### 5 Raam binnenstebuiten, bovenkant beneden, verticaal (1:3)

Regenluifel 18x90 antraciet, loopt 12 af; EPDM met druiprand

Band tussenvloer; spouwlat bovenin steunt het raam erboven

Kop 5 mm: afkitten, folie omzetten; plafond rust niet op kozijn

Kozijn: naad en glaslatten aan buitenzijde afkitten

Boven beschermt het dakoverstek van 150 het raam. Beneden

staat het raam verder van het dak: daarom de luifel.

Zorg voor ruimte: de vleugel moet onder luifel en

overstek volledig vrij kunnen kiepen en draaien.

Controleer de eerste maanden na regen de goot en de

binnenzijde van het kozijn. Blijft het nat, kit de

buitennaden bij of maak een extra kap boven het raam.

### 7 Ventilatie (natuurlijke trek)

Afvoer: PVC Ø100 door de achterwand, hart z = 1207 (104 onder het plafond), x = 1021.
Binnen: afsluitbaar rooster Ø100. Buiten: rooster Ø100, buis licht aflopend naar buiten; RVS-gaas ca. 1 mm erachter, jaarlijks nakijken. Aanvoer: open voorkant -> veranda -> lage inlaat 140 x 70 onder het kattenluik -> trapkamer -> trapgat 247 x 343.
Trapgat linksvoor, afvoer rechtsachter: boven loopt de lucht schuin door de kamer, dus de mand rechts van het trapgat, uit die lijn.

Stand rooster: vorst bijna dicht (circa 2 m³/h volstaat), 0-5 °C half open, boven 5 °C helemaal open.
Hygrometer in de bovenkamer. Blijft de luchtvochtigheid langdurig boven 75-80 %: rooster verder open.

Blad T10a: Details 2, 5 en 7: ramen en ventilatie

Kattenchalet | schaal 1:2 t/m 1:10 | Rev K, 6-11-2026 | maten in mm

### 1 Wandopbouw bovenkamer, horizontaal (1:2)

Gevelplank 18 (Douglas, werkende breedte 135)

Spouwlat 22x44; spouw onder en boven open met RVS gaas

Dampopen waterkerende folie op de regels, overlap 100

PIR 70 alu; naden met alu-tape, luchtdicht aan regels

Regel 44x69; PIR vult het vak, geen extra dampfolie

Lightply 9: gelijmd, geschroefd, blank gelakt

18 | 22 | 69 | 9

118

Dampdicht binnen, dampopen buiten: droogt naar buiten.

Plaat draagt niets, maar schoort wel: schroef om de 100.

### 3 Dakrand voor, verticaal (1:5)

EPDM 1,14 op OSB-3 11; afschot 1:36 naar achter

Ventilatieruimte 28-57 tussen sporen, voor en achter open

Spleet 15 mm met RVS gaas: spouw en dak ventileren hier

PIR 70 op plafondplaat; plafond Lightply 9

Boeiboord en alu daktrim met druiprand

150

Blad T10b: Details 1 en 3: wand en dakrand

Kattenchalet | schaal 1:2 t/m 1:10 | Rev K, 6-11-2026 | maten in mm

### 4 Stelvoet onder de poot (1:4)

terras | EPDM-rest onder de voet: grip, spaart de tegel Hettich stelvoet M10x75, Ø75, RVS (art. 4297033)

RVS contramoer M10

Inslagmoer M10 (art. 3857241), vet + kit

Gat Ø11, 60 diep: ruimte voor de draad

Poot 68x68, 95; kopse kant verzegeld

Vloerframe 44x69 geïmpr.

35

130

Los op de tegels; later vast aan de schutting (stap 15).

### 6 Trap langs linkerwand, zijaanzicht (1:10)

Lip rechterboom: 2 x RVS 4 x 40 in de balk

150

100

100

100

145

595

595

6 optreden van 99, treden 150, 3 x 100 en 145 diep, 247 breed, helling 45°. Sisal
of rubbermat. Donker: versterking rechterboom, licht: lip. Trap vóór de tussenvloer plaatsen.

Blad T10c: Details 4 en 6: fundering en trap

Kattenchalet | schaal 1:2 t/m 1:10 | Rev K, 6-11-2026 | maten in mm

Betonplex 12 mm, 2500x1250 plaat 1/1 (zaagvolgorde: zaagplannen bouwmarkt)

A 1140x709
Vloerplaat beneden

G 1140x709
Vloerplaat bovenkamer

N 150x247 N 145x247

M 1384x117

M 1384x67

M 819x67 | M 819x67
N 815x130 Trapboom | N 815x130 Trapboom
N 247x100 | N 247x100 | N 247x100

N 630x30

OSB-3 11 mm, 2440x1220 plaat 1/1

M 1384x1003
Dakplaat

A 709x1140
Onderplaat vloer

Lightply multiplex 9 mm, 2440x1220 plaat 1/2

G 343x69 | G 247x69
G 709x1140 Onderplaat tussenvloer | L 709x1140 Plafondplaat | C 505x1140 Binnenplaat | I 505x1140 Binnenplaat

Zaagsnede 4 mm meegerekend. Letter = bouwdeel (zie zaaglijst).
Positie van elk stuk: Excel, tabblad Platen op maat. Zaagopdracht voor de bouwmarkt: Kattenchalet_zaagplannen_bouwmarkt.pdf. PIR snijd je zelf.

Kattenchalet_zaagplannen_bouwmarkt.pdf. PIR snijd je zelf. Blad T11a: Zaagplan platen: Betonplex, OSB-3, Lightply

Kattenchalet | schaal 1:20 | Rev K, 6-11-2026 | maten in mm

Lightply multiplex 9 mm, 2440x1220 plaat 2/2

E 310x200

F 653x505 Binnenplaat | K 600x505 Binnenplaat | J 600x505 Binnenplaat
E 653x505 Plaat verandazijde | D 600x505 Binnenplaat | E 600x505 Plaat trapzijde

Versterking kattenluik

PIR 70 mm, 1200x600 plaat 1/7

L 621x322
PIR plafond
E 200x107 | F 543x417 PIR wand

E 417x255
PIR wand

PIR 70 mm, 1200x600 plaat 2/7

A 621x527
PIR vloer | I 527x417
| PIR wand

PIR 70 mm, 1200x600 plaat 3/7

G 621x481
PIR tussenvloer | C 481x417
| PIR wand

PIR 70 mm, 1200x600 plaat 4/7

L 621x321
PIR plafond

D 499x417
PIR wand

G 621x202
PIR tussenvloer

PIR 70 mm, 1200x600 plaat 5/7

L 621x321
PIR plafond

K 499x417
PIR wand

G 225x256

PIR 70 mm, 1200x600 plaat 6/7

I 417x481
PIR wand

A 621x481
PIR vloer

PIR 70 mm, 1200x600 plaat 7/7

C 417x527
PIR wand

J 417x499
PIR wand

Zaagsnede 4 mm meegerekend. Letter = bouwdeel (zie zaaglijst).
Positie van elk stuk: Excel, tabblad Platen op maat. Zaagopdracht voor de bouwmarkt:
Kattenchalet_zaagplannen_bouwmarkt.pdf. PIR snijd je zelf. | Blad T11b: Zaagplan platen: Lightply, PIR
Kattenchalet | schaal 1:20 | Rev K, 6-11-2026 | maten in mm

Vuren geschaafd 44x69: 14 stuks (3 x 3600 + 11 x 2400)

1 | 3600 | 1140 C Bovenregel

1140

C Onderregel

1140

G Rand achter

M 78

86

2 | 3600 | 1140 G Rand voor

1140

I Bovenregel

1140

I Onderregel

M 78

86

3 | 3600 | 1140 L Rand achter

1140

L Rand voor

1003

M Spoor afschot

256

G Raveelba.

4 | 2400 | 1003 M Spoor afschot

1003

M Spoor afschot

343

E Onderregel vo.

5 | 2400 | 1003 M Spoor afschot

587

D Bovenregel

587

D Onderregel

200

E Latei k.

6 | 2400 | 1003 M Zijspoor

505

B Raamstijl

417

C Stijl

417

C Stijl

7 | 2400 | 1003 M Zijspoor

505

B Raamstijl

417

C Stijl

417

D Stijl

8 | 2400 | 631 F Bovenregel

621

G Balk

621

G Balk

505

H Hoekstijl

9 | 2400 | 631 F Onderregel

621

G Balk

621

G Balk

505

H Hoekstijl

10 2400 | 621
| | G Opvulstrook trapgat

621

L Balk

587

E Bovenregel

461

E Stijl achter doorgang

M 78

11 2400 | 621 L Balk

417

D Stijl

417

E Stijl

417

E Stijl

417

F Stijl

M 78

12 2400 | 621 L Balk

417

F Stijl

417

I Stijl

417

I Stijl

417

I Stijl

M 78

13 2400 | 621 L Balk

417

J Stijl

417

J Stijl

417

K Stijl

417

K Stijl

M 78

14 2400 | 587 J Bovenregel

587

J Onderregel

587

K Bovenregel

587

K Onderregel

Geimpregneerd 44x69: 2 stuks (2 x 3600)

1 | 3600 | 1140 A Langsbalk achter

1140

A Langsbalk voor

621

A Dwarsbalk

621

A Dwarsbalk

2 | 3600 | 621 A Dwarsbalk
rest 2975

Geimpregneerde paal 68x68: 1 stuk (1 x 1800)

1 | 1800 | 95 A P.

95

A P.

95

A P.

95

A P.

95

A P.

95

A P.

rest 1206

Blad T12a: Zaagplan balken en palen

Kattenchalet | schaal 1:25 | Rev K, 6-11-2026 | maten in mm

M 78

86

M 78

86

G Raveelba.

Spouwlat 22x44: 11 stuks (11 x 2500)

1 | 2500 | 1262 P Lat achter

1002

P Lat band tussenvloer

rest 228

2 | 2500 | 1262 P Lat achter

1002

P Lat kop raam boven

rest 228

3 | 2500 | 1262 P Lat achter

647

P Lat voor beneden

502

P Lat voorrand vloer

77

4 | 2500 | 1262 P Lat links

431

P Lat voorrand vloer

rest 799

5 | 2500 | 1262 P Lat links
rest 1234
6 | 2500 | 1262 P Lat links
rest 1234
7 | 2500 | 1262 P Lat rechts
rest 1234
8 | 2500 | 1262 P Lat rechts
rest 1234
9 | 2500 | 1262 P Lat rechts
rest 1234
10 2500 | 1262 P Lat voor hoek
rest 1234
11 2500 | 1262 P Lat voor hoek
rest 1234

Toelichting

Zo lezen: elke balk is één handelslengte, links begonnen.

Zaag de stukken in deze volgorde af; na elke snede gaat 4 mm verloren.

Hornbach mag tot 1 cm korter leveren: meet de lat eerst en houd

die marge aan het eind (de rest) over.

Letter = bouwdeel, zoals in de zaaglijst en op de wandframes T8 en T9.

Vink het hokje af als de balk gezaagd is.

Schrijf bouwdeel en naam met potlood op elk stuk.

Gelijke stukken (stijlen 417, balken 596) mogen onderling wisselen.

Sporen en zijsporen M: eerst op lengte 1003 zagen, daarna de schuine snede volgens T7.

Poten A: alle 6 op 95 mm; de stelvoeten vangen het afschot

van het terras op.

Spouwlatten: hier als hele stukken getekend. Met een las op een regel of rand

volstaan 9 latten (Excel, Inkoop); zaag dan de korte stukken uit de resten

van de latten links, rechts en achter.

Gevelplanken, hoeklatten, boeiboorden en kader uit Douglas 18 x 145:

Excel, tabblad Latten op lengte.

Blad T12b: Zaagplan spouwlatten en toelichting

Kattenchalet | schaal 1:25 | Rev K, 6-11-2026 | maten in mm

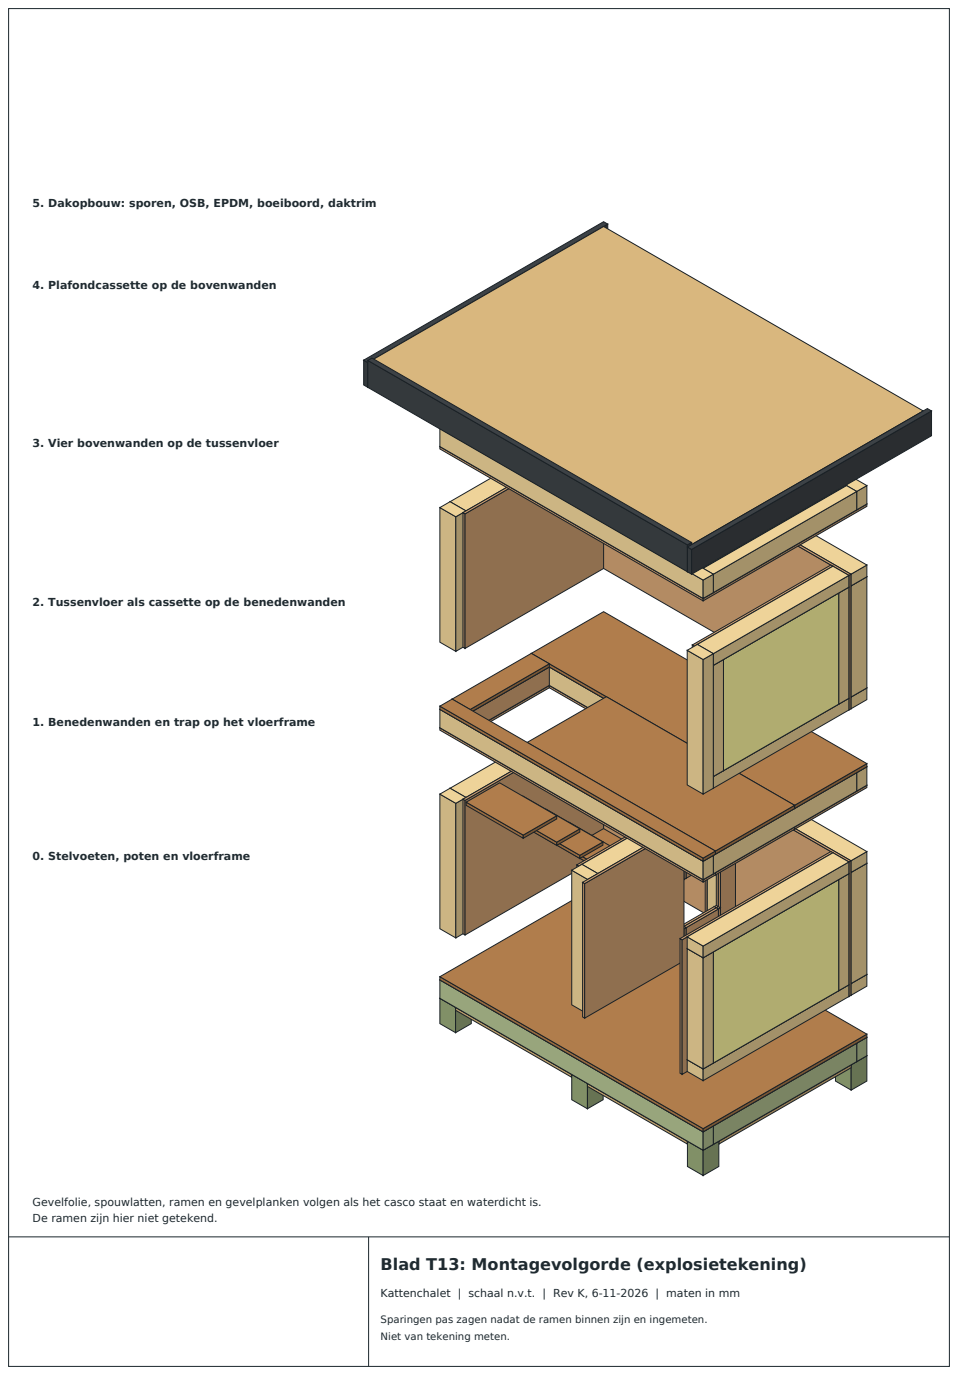
[picture p23: page 27]
De ramen zijn hier niet getekend.; Blad T13: Montagevolgorde (explosietekening)

5. Dakopbouw: sporen, OSB, EPDM, boeiboord, daktrim

4. Plafondcassette op de bovenwanden

3. Vier bovenwanden op de tussenvloer

2. Tussenvloer als cassette op de benedenwanden

1. Benedenwanden en trap op het vloerframe

0. Stelvoeten, poten en vloerframe

Gevelfolie, spouwlatten, ramen en gevelplanken volgen als het casco staat en waterdicht is.

Kattenchalet | schaal n.v.t. | Rev K, 6-11-2026 | maten in mm

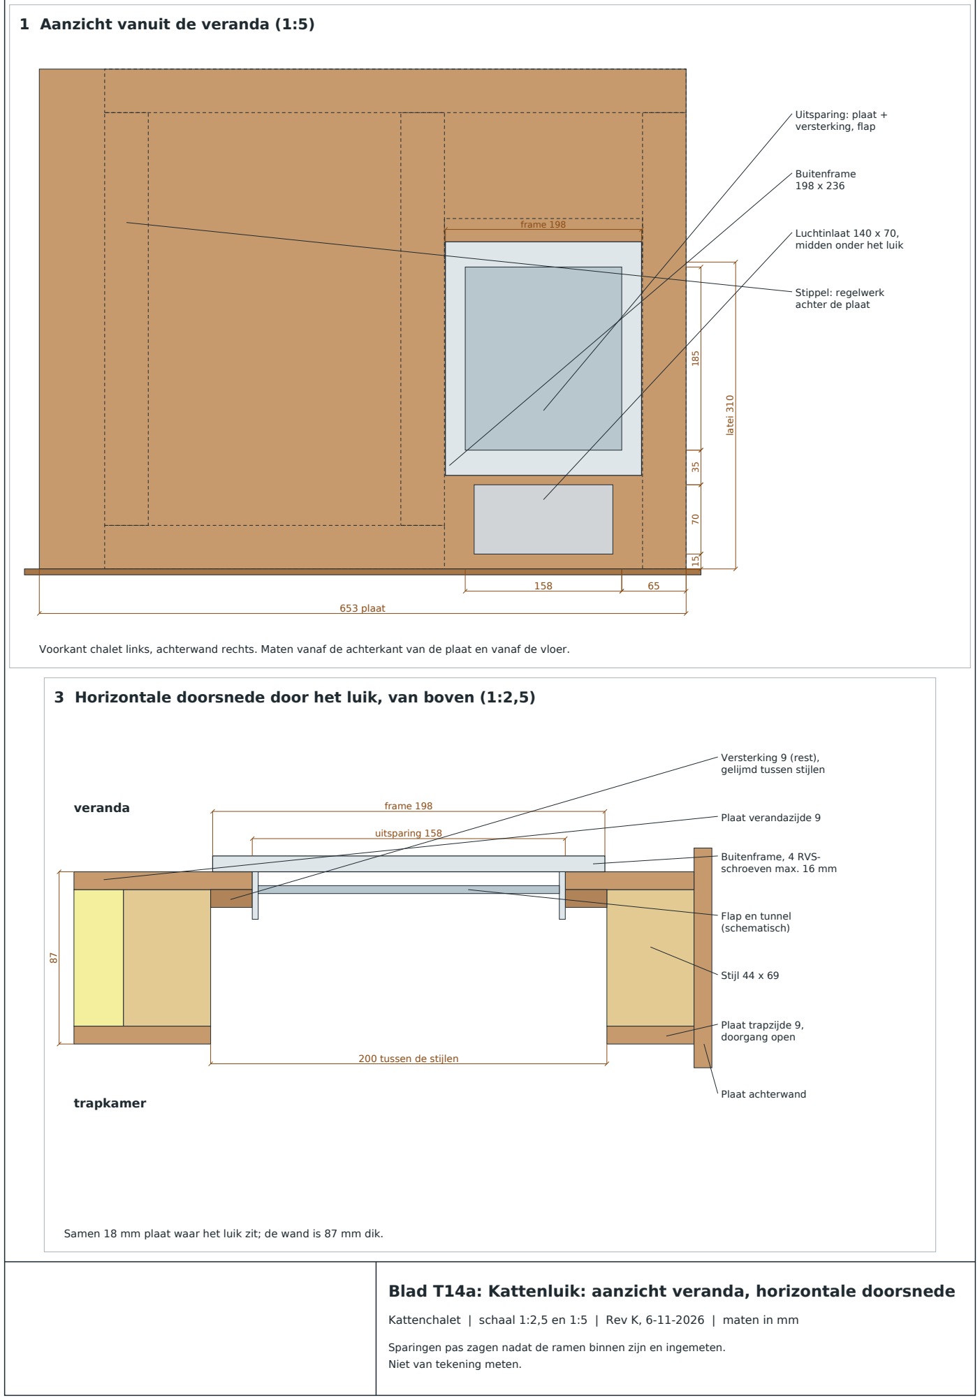
[picture p24: figure]
1 Aanzicht vanuit de veranda (1:5); 653 plaat; frame 198; latei 310; Uitsparing: plaat + versterking, flap; Buitenframe 198 x 236; Luchtinlaat 140 x 70, midden onder het luik; Stippel: regelwerk achter de plaat; 200 tussen de stijlen; uitsparing 158; veranda; trapkamer; Versterking 9 (rest), gelijmd tussen stijlen; Plaat verandazijde 9; Buitenframe, 4 RVS- schroeven max. 16 mm; Flap en tunnel (schematisch); Stijl 44 x 69; Plaat trapzijde 9, doorgang open; Plaat achterwand

Voorkant chalet links, achterwand rechts. Maten vanaf de achterkant van de plaat en vanaf de vloer.

### 3 Horizontale doorsnede door het luik, van boven (1:2,5)

Samen 18 mm plaat waar het luik zit; de wand is 87 mm dik.

Blad T14a: Kattenluik: aanzicht veranda, horizontale doorsnede

Kattenchalet | schaal 1:2,5 en 1:5 | Rev K, 6-11-2026 | maten in mm

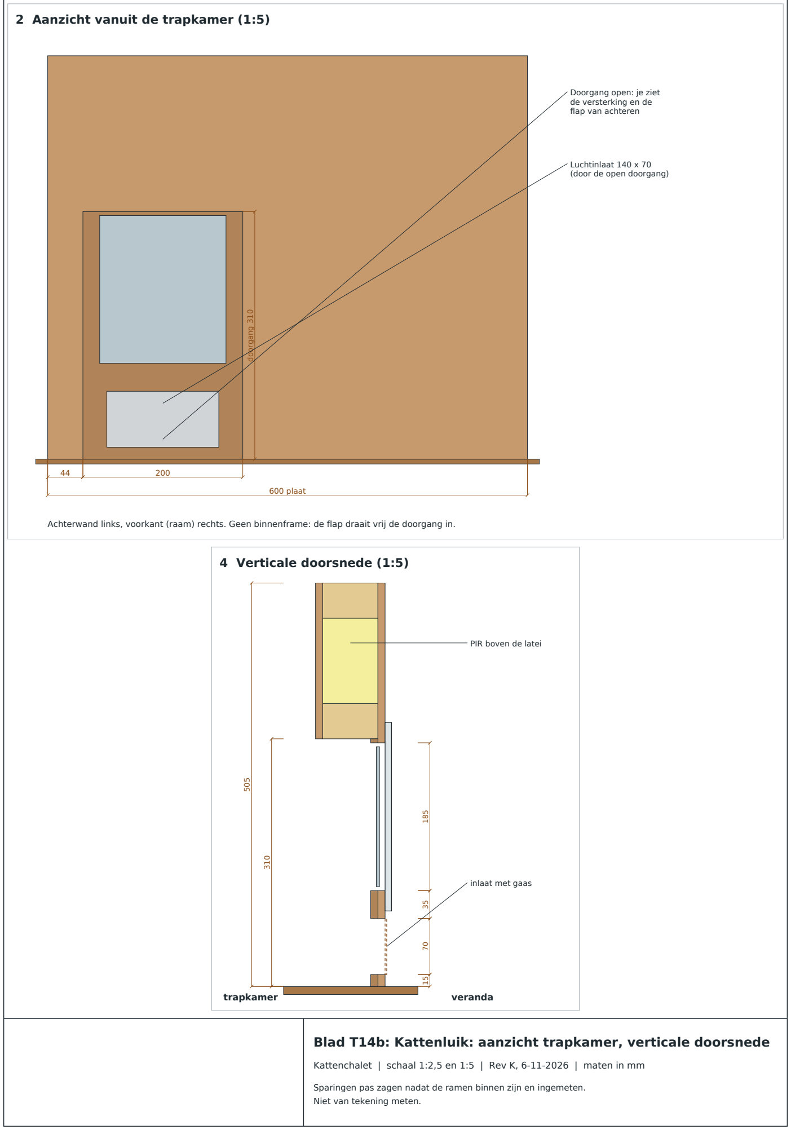
[picture p25: figure]
2 Aanzicht vanuit de trapkamer (1:5); 600 plaat; doorgang 310; Doorgang open: je ziet de versterking en de flap van achteren; Luchtinlaat 140 x 70 (door de open doorgang); 4 Verticale doorsnede (1:5); trapkamer; veranda; inlaat met gaas; PIR boven de latei

Achterwand links, voorkant (raam) rechts. Geen binnenframe: de flap draait vrij de doorgang in.

Blad T14b: Kattenluik: aanzicht trapkamer, verticale doorsnede

Kattenchalet | schaal 1:2,5 en 1:5 | Rev K, 6-11-2026 | maten in mm

15 70 35 185

veranda

inlaat met gaas

PIR boven de latei

Plaatsen

Luik: PetSafe 700 S. Uitsparing 158 breed x 185 hoog, frame

198 x 236 (volgens bol; eerst nameten op het luik).

Hoogte: onderkant uitsparing 120 boven de vloer, onderrand frame

ca. 94: ongeveer buikhoogte van een volwassen kat. Meet je

eigen kat en pas zo nodig aan; de latei zit 5 mm boven de uitsparing

(nu op 310) en gaat mee. De luchtinlaat eronder moet blijven passen.

Dubbele plaat: ja. 9 mm Lightply (zachte falcata) houdt kleine schroeven slecht,

en de kat duwt bij elke doorgang tegen het luik. Lijm de versterking

(200 x 310, rest Lightply 9) achter de verandaplaat, tussen

de stijlen en onder de latei, en schroef hem in de stijlen. Samen 18 mm.

Zaag de uitsparing pas als de lijm hard is, door beide platen

tegelijk: dan liggen de randen gelijk. Randen afronden en lakken.

Geen binnenframe: schroef het buitenframe met 4 RVS-houtschroeven

van max. 16 mm in plaat en versterking; de punt mag er niet uit.

Of het afsluitpaneel zonder binnenframe werkt: controleren.

Plaats het luik als wand E nog plat ligt (stap 6). Aan de

trapzijde blijft de doorgang open, zodat de flap vrij draait.

Luchtinlaat 140 x 70, 15 boven de vloer, onder het luik: koude

lucht komt laag binnen en de warme lucht blijft bovenin de trapkamer.

Alleen in verandaplaat en versterking, RVS-gaas aan de verandakant.

Geen opening boven de latei: daar komt PIR.

Blad T14c: Kattenluik: plaatsen

Kattenchalet | schaal 1:2,5 en 1:5 | Rev K, 6-11-2026 | maten in mm

Rechterboom op het plaatstuk 815 x 130 (1:5)

815

130

Onderkant langs de lange zaagkant van het stuk. Tanden: optrede 99, treden 150, 3 x 100 en 145 diep. Bij de binnenhoeken blijft ca. 60 mm hout over. Donker: versterkingsstrook 630 x 30 op de rechterboom. Getekend is de rechterboom, met de lip van 40 breed aan de bovenkant; bij de linkerboom zaag je de lip weg. Teken de tanden af volgens detail 6 (blad T10c). Boor in elke binnenhoek een gat Ø6 tegen scheuren en zaag daarnaartoe.

Betonplex-stroken op maat: afkorten (afkortzaag) en smal rippen (tafelzaag)

- Strook 709 x 212: op de tafelzaag op 150 breed, dan afkorten op 247 + 247 (trede), de trede van 145 nog 5 smaller; rest 207 lang.
- Strook 1642 x 117: afkorten op 1384 (onderplaat overstek voor); rest 254 lang.
- Strook 1642 x 67: afkorten op 1384 (onderplaat overstek achter); rest 254 lang.
- Strook 1642 x 67: afkorten op 819 + 819 (onderplaat overstek links, onderplaat overstek rechts); geen rest: zaag de stukken op maat, het laatste is wat overblijft.
- Strook 1642 x 130: afkorten op 815 + 815 (trapboom); rest 4 lang.
- Strook 1642 x 100: afkorten op 247 + 247 + 247 (trede); rest 889 lang.
- Strook 1642 x 36: op de tafelzaag op 30 breed, dan afkorten op 630 (versterkingsstrook trapboom); rest 1008 lang.

De bouwmarkt zaagt de plaat in stroken volgens Kattenchalet_zaagplannen_bouwmarkt.pdf; de rest gebeurt thuis, zoals hierboven. Schrijf op elk stuk de naam. Bewaar de restplaat en de grotere reststroken droog en vlak; de kleine stukjes zijn bruikbaar als klos of vulstuk.

Blad T15: Trap en betonplex thuis zagen

Kattenchalet | schaal 1:5 | Rev K, 6-11-2026 | maten in mm

Kattenchalet bouwplan | Rev K, 6-11-2026 | Zaaglijst, stappenplan en onderhoud, pagina 1

## Zaaglijst

Maten in mm, L x B x D. Bouwdelen komen overeen met de tekeningen. Bij gevelplanken is B de werkende breedte 135 (plank zelf 145); die planken hoeven dus niet gerift, behalve de bovenste rij van 47 mm. Deze lijst staat ook, sorteerbaar, in het Excel-bestand.

Onderdeel | Materiaal | st | L | B | D | Opmerking

A Vloerframe

Dwarsbalk | Geimpregneerd 44x69 | 3 | 621 | 69 | 44
Langsbalk achter | Geimpregneerd 44x69 | 1 | 1140 | 69 | 44
Langsbalk voor | Geimpregneerd 44x69 | 1 | 1140 | 69 | 44
Onderplaat vloer | OSB-3 11 | 1 | 1140 | 709 | 11 | uit de dakplaat-rest, 90 graden gedraaid; 6 sparingen 68x68 rond de poten
PIR vloer | PIR 70 alu | 1 | 621 | 481 | 70
PIR vloer | PIR 70 alu | 1 | 621 | 527 | 70
Poot | Geimpregneerde paal 68x68 | 6 | 95 | 68 | 68
Vloerplaat beneden | Betonplex 12 | 1 | 1140 | 709 | 12

B Voorwand beneden

Raamstijl | Vuren geschaafd 44x69 | 2 | 505 | 69 | 44 | geen regels: kozijn direct op de vloer

C Achterwand beneden

Binnenplaat | Lightply multiplex 9 (falcata, binnen) | 1 | 1140 | 505 | 9 | volle breedte, uit een stuk: geeft houvast in de hoeken
Bovenregel | Vuren geschaafd 44x69 | 1 | 1140 | 69 | 44
Onderregel | Vuren geschaafd 44x69 | 1 | 1140 | 69 | 44
PIR wand | PIR 70 alu | 1 | 481 | 417 | 70
PIR wand | PIR 70 alu | 1 | 527 | 417 | 70
Stijl | Vuren geschaafd 44x69 | 3 | 417 | 69 | 44

D Linkerwand beneden

Binnenplaat | Lightply multiplex 9 (falcata, binnen) | 1 | 600 | 505 | 9
Bovenregel | Vuren geschaafd 44x69 | 1 | 587 | 69 | 44
Onderregel | Vuren geschaafd 44x69 | 1 | 587 | 69 | 44
PIR wand | PIR 70 alu | 1 | 499 | 417 | 70
Stijl | Vuren geschaafd 44x69 | 2 | 417 | 69 | 44

E Scheidingswand

Bovenregel | Vuren geschaafd 44x69 | 1 | 587 | 69 | 44
Latei kattenopening | Vuren geschaafd 44x69 | 1 | 200 | 69 | 44
Onderregel voorste deel | Vuren geschaafd 44x69 | 1 | 343 | 69 | 44
PIR boven doorgang | PIR 70 alu | 1 | 200 | 107 | 70
PIR wand | PIR 70 alu | 1 | 417 | 255 | 70
Plaat trapzijde | Lightply multiplex 9 (falcata, binnen) | 1 | 600 | 505 | 9 | uit een stuk; doorgang 200x310 uitzagen, randen afronden
Plaat verandazijde | Lightply multiplex 9 (falcata, binnen) | 1 | 653 | 505 | 9 | uit een stuk; kattenluik 158x185 op 120 boven de vloer en luchtinlaat 140x70 op 15 uitzagen
Stijl | Vuren geschaafd 44x69 | 2 | 417 | 69 | 44
Stijl achter doorgang | Vuren geschaafd 44x69 | 1 | 461 | 69 | 44 | tot op de vloer: geen los stukje onderregel
Versterking kattenluik | Lightply multiplex 9 (falcata, binnen) | 1 | 200 | 310 | 9 | restplaat, achter de verandaplaat gelijmd tussen de stijlen; uitsparing na het lijmen, door beide platen

F Rechterwand beneden

Binnenplaat | Lightply multiplex 9 (falcata, binnen) | 1 | 653 | 505 | 9 | loopt door tot achter de afdekking wandkop

Kattenchalet bouwplan | Rev K, 6-11-2026 | Zaaglijst, stappenplan en onderhoud, pagina 2
Onderdeel | Materiaal | st | L | B | D | Opmerking
Bovenregel | Vuren geschaafd 44x69 | 1 | 631 | 69 | 44
Onderregel | Vuren geschaafd 44x69 | 1 | 631 | 69 | 44
PIR wand | PIR 70 alu | 1 | 543 | 417 | 70
Stijl | Vuren geschaafd 44x69 | 2 | 417 | 69 | 44

G Tussenvloer

Balk | Vuren geschaafd 44x69 | 4 | 621 | 69 | 44
Dagkant trapgat links | Lightply multiplex 9 (falcata, binnen) | 1 | 343 | 69 | 9
Dagkant trapgat voor | Lightply multiplex 9 (falcata, binnen) | 1 | 247 | 69 | 9
Onderplaat tussenvloer | Lightply multiplex 9 (falcata, binnen) | 1 | 1140 | 709 | 9 | met uitsparing trapgat 247x343
Opvulstrook trapgat | Vuren geschaafd 44x69 | 1 | 621 | 69 | 25 | 44x69 rifen: steunt de plaat tot aan het trapgat
PIR tussenvloer | PIR 70 alu | 1 | 256 | 225 | 70
PIR tussenvloer | PIR 70 alu | 1 | 621 | 202 | 70
PIR tussenvloer | PIR 70 alu | 1 | 621 | 481 | 70
Rand achter | Vuren geschaafd 44x69 | 1 | 1140 | 69 | 44
Rand voor | Vuren geschaafd 44x69 | 1 | 1140 | 69 | 44
Raveelbalk trapgat | Vuren geschaafd 44x69 | 1 | 256 | 69 | 44
Vloerplaat bovenkamer | Betonplex 12 | 1 | 1140 | 709 | 12 | met uitsparing trapgat 247x343

H Voorwand boven

Hoekstijl | Vuren geschaafd 44x69 | 2 | 505 | 69 | 44 | strak tegen het kozijn, 1 mm speling per kant

I Achterwand boven

Binnenplaat | Lightply multiplex 9 (falcata, binnen) | 1 | 1140 | 505 | 9 | volle breedte: houvast in de hoeken; gat d102 voor ventilatiebuis, op buismaat aanpassen
Bovenregel | Vuren geschaafd 44x69 | 1 | 1140 | 69 | 44
Onderregel | Vuren geschaafd 44x69 | 1 | 1140 | 69 | 44
PIR wand | PIR 70 alu | 1 | 481 | 417 | 70
PIR wand | PIR 70 alu | 1 | 527 | 417 | 70
Stijl | Vuren geschaafd 44x69 | 3 | 417 | 69 | 44

J Linkerwand boven

Binnenplaat | Lightply multiplex 9 (falcata, binnen) | 1 | 600 | 505 | 9
Bovenregel | Vuren geschaafd 44x69 | 1 | 587 | 69 | 44
Onderregel | Vuren geschaafd 44x69 | 1 | 587 | 69 | 44
PIR wand | PIR 70 alu | 1 | 499 | 417 | 70
Stijl | Vuren geschaafd 44x69 | 2 | 417 | 69 | 44

K Rechterwand boven

Binnenplaat | Lightply multiplex 9 (falcata, binnen) | 1 | 600 | 505 | 9
Bovenregel | Vuren geschaafd 44x69 | 1 | 587 | 69 | 44
Onderregel | Vuren geschaafd 44x69 | 1 | 587 | 69 | 44
PIR wand | PIR 70 alu | 1 | 499 | 417 | 70
Stijl | Vuren geschaafd 44x69 | 2 | 417 | 69 | 44

L Plafond

Balk | Vuren geschaafd 44x69 | 4 | 621 | 69 | 44
PIR plafond | PIR 70 alu | 2 | 621 | 321 | 70
PIR plafond | PIR 70 alu | 1 | 621 | 322 | 70
Plafondplaat | Lightply multiplex 9 (falcata, binnen) | 1 | 1140 | 709 | 9

Kattenchalet bouwplan | Rev K, 6-11-2026 | Zaaglijst, stappenplan en onderhoud, pagina 3
Onderdeel | Materiaal | st | L | B | D | Opmerking
Rand achter | Vuren geschaafd 44x69 | 1 | 1140 | 69 | 44
Rand voor | Vuren geschaafd 44x69 | 1 | 1140 | 69 | 44

M Dak

Boeiboord achter | Douglas 18x145 (hoek/boei antraciet) | 1 | 1384 | 72 | 18
Boeiboord links | Douglas 18x145 (hoek/boei antraciet) | 1 | 1039 | 101 | 18 | bovenrand schuin volgens dak
Boeiboord rechts | Douglas 18x145 (hoek/boei antraciet) | 1 | 1039 | 101 | 18 | bovenrand schuin volgens dak
Boeiboord voor | Douglas 18x145 (hoek/boei antraciet) | 1 | 1384 | 101 | 18
Dakplaat | OSB-3 11 | 1 | 1384 | 1003 | 11 | tussen de boeiboorden
Onderplaat overstek achter | Betonplex 12 | 1 | 1384 | 67 | 12
Onderplaat overstek links | Betonplex 12 | 1 | 819 | 67 | 12
Onderplaat overstek rechts | Betonplex 12 | 1 | 819 | 67 | 12
Onderplaat overstek voor | Betonplex 12 | 1 | 1384 | 117 | 12
Rijklos | Vuren geschaafd 44x69 | 6 | 78 | 69 | 44 | bovenkant schuin, gelijk met de sporen: aftekenen; gat d16 voor ventilatie
Spoor afschot | Vuren geschaafd 44x69 | 4 | 1003 | 69 | 44 | schuin zagen: voor 56, achter 29 hoog
Zijspoor | Vuren geschaafd 44x69 | 2 | 1003 | 69 | 44 | schuin zagen: voor 56, achter 29 hoog; draagt plaatrand, trim en zij-onderplaat

N Trap

Trapboom | Betonplex 12 | 1 | 815 | 130 | 12 | zaagtanden en lip 40 breed bovenaan, zie detail 6
Trapboom | Betonplex 12 | 1 | 815 | 130 | 12 | zaagtanden, zie detail 6
Trede | Betonplex 12 | 3 | 247 | 100 | 12 | op de tanden; anti-slip bekleden
Trede | Betonplex 12 | 1 | 247 | 145 | 12 | op de tanden; rechts inkeping 12 x 40 voor de lip, 17 uit de voorkant; anti-slip bekleden
Trede | Betonplex 12 | 1 | 247 | 150 | 12 | op de tanden; anti-slip bekleden
Versterkingsstrook trapboom | Betonplex 12 | 1 | 630 | 30 | 12 | binnenkant rechterboom, langs de onderkant; uit de reststrook

P Spouwlatten

Lat achter | Spouwlat 22x44 | 3 | 1262 | 44 | 22
Lat band tussenvloer | Spouwlat 22x44 | 1 | 1002 | 44 | 22 | bovenkant gelijk met vloer: kozijn steunt erop
Lat kop raam boven | Spouwlat 22x44 | 1 | 1002 | 44 | 22 | 10 mm onderbreken voor ventilatie
Lat links | Spouwlat 22x44 | 3 | 1262 | 44 | 22
Lat rechts | Spouwlat 22x44 | 3 | 1262 | 44 | 22
Lat voor beneden | Spouwlat 22x44 | 1 | 647 | 44 | 22
Lat voor hoek | Spouwlat 22x44 | 2 | 1262 | 44 | 22
Lat voorrand vloer | Spouwlat 22x44 | 1 | 431 | 44 | 22 | bovenkant gelijk met vloer
Lat voorrand vloer | Spouwlat 22x44 | 1 | 502 | 44 | 22 | bovenkant gelijk met vloer

Q Gevelbekleding

Afdekking wandkop veranda | Douglas 18x145 (kader grenen beits) | 1 | 505 | 60 | 18 | dekt de open wandkop af
Band tussenvloer | Douglas 18x145 (kader grenen beits) | 1 | 1104 | 90 | 18
Hoeklat frontbreed | Douglas 18x145 (hoek/boei antraciet) | 4 | 1262 | 58 | 18
Hoeklat zijkant | Douglas 18x145 (hoek/boei antraciet) | 4 | 1262 | 40 | 18

Kattenchalet bouwplan | Rev K, 6-11-2026 | Zaaglijst, stappenplan en onderhoud, pagina 4
Onderdeel | Materiaal | st | L | B | D | Opmerking
Kader boven raam | Douglas 18x145 (kader grenen beits) | 1 | 1000 | 66 | 18
Kaderstijl beneden links | Douglas 18x145 (kader grenen beits) | 1 | 505 | 52 | 18
Kaderstijl beneden rechts | Douglas 18x145 (kader grenen beits) | 1 | 505 | 79 | 18
Kaderstijl boven links | Douglas 18x145 (kader grenen beits) | 1 | 571 | 52 | 18
Kaderstijl boven rechts | Douglas 18x145 (kader grenen beits) | 1 | 571 | 52 | 18
Plank achter | Douglas 18x145 (hout zichtbaar) | 1 | 1104 | 47 | 18 | bovenste rij: plank rifen, tong eraf
Plank achter | Douglas 18x145 (hout zichtbaar) | 9 | 1104 | 135 | 18
Plank links | Douglas 18x145 (hout zichtbaar) | 1 | 673 | 47 | 18 | bovenste rij: plank rifen, tong eraf
Plank links | Douglas 18x145 (hout zichtbaar) | 9 | 673 | 135 | 18
Plank rechts | Douglas 18x145 (hout zichtbaar) | 1 | 673 | 47 | 18 | bovenste rij: plank rifen, tong eraf
Plank rechts | Douglas 18x145 (hout zichtbaar) | 9 | 673 | 135 | 18
Regenluifel | Douglas 18x145 (hoek/boei antraciet) | 1 | 1104 | 91 | 18 | tussen de hoeklatten, 12 mm aflopend naar voren; op 5 RVS consoles, EPDM met druiprand
Voorrand vloer | Douglas 18x145 (kader grenen beits) | 1 | 1104 | 96 | 18

Kattenchalet bouwplan | Rev K, 6-11-2026 | Zaaglijst, stappenplan en onderhoud, pagina 5

## Stappenplan

### 1. Voorbereiding

- Lees eerst de tekeningen T1-T15. Links en rechts zijn in dit hele plan gezien vanaf de voorkant, ook als je achter het chalet staat. Hoogtes zijn gemeten vanaf de bovenkant van de hoogste terrastegel onder het chalet.
- Bestel eerst de ramen en meet ze (stap 2). Bestel de rest pas daarna en controleer de gemarkeerde artikelen bij Hornbach.
- Tot het dak in stap 9 dicht is, gaat er elke avond en bij elke bui een afdekzeil over het werk. PIR, gelakte platen en OSB mogen niet nat worden.

### 2. Ramen inmeten

- Meet beide kozijnen na ontvangst op drie plekken in breedte en hoogte, en meet ook de diepte (het plan rekent met 71). Is een maat anders dan 1000 x 500 of 500 x 500, pas dan eerst het model aan: breedte, kamerhoogte en diepte van het hele chalet hangen hiervan af.
- Bekijk de scharnierzijde, de glaslatten en de afwateringssleuven. Monteer de afsluitbare greep en de kiepbeveiliging. Test de kiep- en draaistand met het raam omgekeerd op de werkbank.

### 3. Zagen en voorbehandelen

- Zaag de balken en regels volgens blad T12 en schrijf op elk stuk het bouwdeel en de naam. Zaag de platen volgens blad T11; de betonplex volgt jouw indeling, met maten uit het model. Wat je thuis zaagt (trapbomen en stroken op maat) staat op blad T15. Geef de bouwmarkt per plaat de zaagopdracht uit Kattenchalet_zaagplannen_bouwmarkt.pdf: daar staan alleen hun sneden, genummerd en met maat; PIR snijd je zelf. Laat grote platen in de vestiging voorzagen. Zaag alle wandplaten 501 hoog in plaats van 505: ze komen 4 mm boven de vloer, met een kitvoeg, zodat ze geen water optrekken.
- Sparingen in wand E, gemeten vanaf de achterkant van de plaat (de verandaplaat is aan de voorkant langer). Plaat trapzijde: doorgang 200 breed en 310 hoog vanaf de vloer, 44 mm uit de achterkant. Verandaplaat: geen doorgang, maar de uitsparing voor het kattenluik, 158 breed en 185 hoog, 65 mm uit de achterkant, met de onderkant 120 mm boven de vloer. Meet de zaagmaat eerst na op het luik zelf. In de verandaplaat onder het luik ook een luchtinlaat van 140 x 70, 74 mm uit de achterkant, 15-85 mm boven de vloer. Ook die zaag je pas na het lijmen, door beide platen. Zaag uit de rest ook de versterkingsplaat van 200 x 310. Zaag de uitsparing voor het luik daarin pas na het lijmen (blad T14). Trapgat in de onderplaat en de vloerplaat van de tussenvloer: 247 x 343 mm, 78 mm uit de linkerrand en 53 mm uit de voorrand. Teken elke sparing af met de plaat in de stand waarin hij straks zit. De onderplaat ligt met de gelakte kant naar beneden: teken je hem af met de lakzijde boven, dan wisselen links en rechts.
- Hoeklatten: zaag op de tafelzaag eerst tong en groef van de Douglas-plank, dan 4 stroken 58 x 18 en 4 stroken 40 x 18, lang 1262. Zet per hoek de smalle kant van de 40-strook tegen de achterkant van de 58-strook, zodat een L van 58 x 58 ontstaat. Lijm met PU-lijm, schroef RVS 4 x 40 om de 250 mm, voorgeboord, en klem tot de lijm hard is. Rif de overige stroken (boeiboorden, kader, band, voorrand, regenluifel en de bovenste gevelrij van 47) volgens het Excel-tabblad 'Latten op lengte'. Meet eerst een plank: is die zonder tong en groef smaller dan 145, dan klopt die indeling niet meer.
- Beits alles vóór de montage, binnen en niet onder +8 °C. Gevelplanken, kader, band en voorrand krijgen eerst grondverf en dan grenen beits. Hoeklatten, boeiboorden en regenluifel krijgen antraciet, 3 lagen rondom. Beits 2 lagen, op plekken die veel weer vangen 3, met 8 uur tussen de lagen. Kopse kanten en gerifte randen krijgen kopshoutverzegeling. Maak eerst een proefstuk voor de kleur. Behandel later elke zaagsnede op de bouw na.
- Laat de Lightply 48 uur acclimatiseren, binnenshuis en vrij van de grond. Schuur de zichtzijde en lak die met TENCO Bootlak blank mat, minstens 3 lagen en 24 uur per laag. De achterkant wordt gelijmd en blijft kaal. Bij de onderplaat van de tussenvloer en de plafondplaat is de onderkant de zichtzijde. Rond de randen af en seal ze. Sla hout droog en plat op.

Kattenchalet bouwplan | Rev K, 6-11-2026 | Zaaglijst, stappenplan en onderhoud, pagina 6

### 4. Plek en stelvoeten

- Kies de plek: achterwand minstens 250 mm van de schutting (dakoverstek 100 mm plus goot). De poten staan 571 en 501 mm hart op hart in de breedte en 641 mm in de diepte (blad T6). Elke voet (Ø75) moet helemaal op één tegel staan, niet op een voeg: schuif het chalet zo nodig iets op. Bepaal met waterpas en rechte lat welke van de 6 voetplekken het hoogst ligt: dat is hoogte 0. Meet ook hoeveel de laagste plek lager ligt.
- Controleer de stelvoeten in de winkel: draad M10 aan de voet, minstens 60 mm vrij te stellen. Het plan rekent met de onderkant van de poot 35 mm boven hoogte 0. Ligt de laagste plek meer dan ca. 25 mm lager, dan is de draad te kort: maak de poten aan die kant langer.
- Poten: zaag alle 6 op 95 mm. Boor in het hart van elke kopse kant eerst een gat voor het busje van de inslagmoer, daarna Ø11 door tot 60 mm diep: daar verdwijnt de draad van de voet in. Verzegel de kopse kant en het gat. Vet de draad van de inslagmoer in, sla de moer erin en kit de rand rondom, zodat er geen water tussen hout en moer komt. Draai de contramoer en dan de voet in.
- De voeten staan los op de tegels, met een stukje rest-EPDM onder elke voet. Het chalet wordt na de bouw aan de schutting vastgezet (stap 15). Tot die tijd: let op weerwaarschuwingen voor wind en zet het chalet bij code oranje tijdelijk vast (stap 15).

### 5. Vloerframe

- Bouw frame A plat: de langsbalken voor en achter (1140) over de koppen van de 3 dwarsbalken (621), met 2 constructieschroeven 5 x 80 per verbinding, voorgeboord. Controleer de diagonalen (1342 mm). Schroef de OSB-onderplaat met RVS 4 x 40 onder het frame, zonder kieren. De plaat komt uit één stuk uit de rest van de dakplaat, met uitsparingen van 68 x 68 rond de 6 poten. Seal alle randen en lak of beits de onderkant. Keer het frame om, leg PIR 70 in de vakken en tape de naden.
- Zet het frame op de poten met stelvoeten, op de plek uit stap 4. Stel de voeten af: in de breedte waterpas, in de diepte 5 mm aflopend naar voren. Elke voet moet dragen: druk op elke hoek en stel bij tot er geen voet meer los staat. Zet de contramoeren vast. Het hele chalet helt daardoor iets naar voren, dus zet wanden en ramen haaks op de vloer en niet op de waterpas in de diepte. Zet elke poot trekvast aan het frame met een hoekanker en constructieschroeven. Dicht de uitsparingen rond de poten af, zodat er geen kier voor muizen overblijft. Lijm en schroef de vloerplaat met RVS 4 x 40 en verzegel alle randen.

Kattenchalet bouwplan | Rev K, 6-11-2026 | Zaaglijst, stappenplan en onderhoud, pagina 7

### 6. Benedenwanden en trap

- Bouw de frames C, D, E en F volgens blad T8: de regels over de koppen van de stijlen, 2 schroeven 5 x 80 per verbinding, voorgeboord. Lijm en schroef de binnenplaat erop, met de gelakte kant naar de kamer en de onderrand 4 mm boven de onderkant van het frame. Gebruik RVS 3,5 x 25, voorgeboord, om de 100 mm en minstens 15 mm uit de rand. De plaat maakt het frame haaks, dus controleer de diagonalen voordat de lijm uithardt. Bij D en aan de trapzijde van E steekt de plaat 13 mm voor het frame uit, tot tegen het kozijn. In de open veranda lopen de platen door tot 18 mm achter de voorkant, tegen de kaderstijl en de afdekking van de wandkop: bij F 22 mm voorbij het frame, aan de verandazijde van E 66 mm. Zet die laatste plaat pas vast als raamstijl B staat, en schroef de voorrand in de raamstijl. Kattenluik volgens blad T14: lijm de versterkingsplaat achter de verandaplaat, tussen de stijlen van de doorgang. Zaag daarna de uitsparing door beide platen tegelijk. Schroef het buitenframe zonder binnenframe vast met korte RVS-schroeven, zolang de wand nog plat ligt. Plak RVS-gaas aan de verandakant over de luchtinlaat onder het luik. Leg nog geen PIR in de wanden.
- Zet C op de vloer, gelijk met de achterrand, en schroef de onderregel om de 300 mm met 5 x 80 door de vloerplaat in het frame. Zet D en F gelijk met de zijkanten en E met het regelwerk op 571 mm uit de linkerrand van de vloer. F loopt door tot de voorrand; D en E beginnen 44 mm erachter, want daar komen de raamstijlen. Tussen de raamstijlen links en rechts komt straks het onderraam, met 1 mm speling per kant; meet dat na aan het echte raam. Schroef ze op de vloer en schroef vanuit het open vak 3 schroeven 5 x 80 door de achterste stijl en de achterplaat in de achterwand.
- Raamstijlen B: de 44 x 69 links voor, tegen de voorste stijl van D, en de 44 x 69 voor wand E. Zet ze nu alleen voorlopig vast, met één schroef schuin in de vloer. Ze dragen straks de cassette, maar de definitieve bevestiging volgt pas in stap 11, strak tegen het kozijn.
- Trap. Zaag de trapbomen: teken de tanden af volgens detail 6 (optrede 99, treden 150, 3 x 100 en 145 diep, van onder naar boven; de onderste trede steekt 50 mm voorbij zijn tand, tot tegen de achterwand). Zaag aan de bovenkant van de rechterboom de lip mee uit (40 breed, tot 569 boven de vloer); bij de linkerboom zaag je dat stuk weg. Zaag in de bovenste trede rechts een inkeping van 12 x 40, 17 mm uit de voorkant, waar de lip doorheen gaat. Boor in elke binnenhoek een gat Ø6 tegen scheuren en zaag daarnaartoe, niet erlangs. Er blijft ca. 60 mm hout over, dus zaag niet dieper dan de lijn. Schuur alles glad. Lijm de versterkingsstrook (630 x 30) met PU-lijm op de binnenkant van de rechterboom, langs de rechte onderkant, van de voet tot de bovenkant. Klem hem en schroef om de 10-15 cm met RVS 3,5 x 20; er mag geen punt uitsteken. Bekleed de treden nu met sisal of rubber, want later kom je er slecht bij. Lijm de treden met PU-lijm op de tanden en zet ze vast met RVS 3,5 x 25, voorgeboord, midden in de boomrand.
- Zet de trap tegen de linkerwand, met de voet tegen de achterwand C en de bovenkant 5 mm achter het kozijn: de trap mag het raam niet raken. De linkerboom wordt over zijn hele vlak tegen de wandplaat gelijmd. Zet de trap eerst droog op zijn plek en trek de omtrek van de linkerboom op de plaat af. Boor binnen die lijn, ca. 20 mm van de rand, om de ca. 150 mm een gaatje Ø3 door de plaat, zodat je de plek aan de buitenkant terugvindt. Schuur binnen de lijn de lak weg tot op kaal hout en schuur ook de gladde filmlaag op de buitenkant van de boom op: op lak en film hecht de lijm niet. Zet de boom met PU-lijm tegen de plaat. Wand D heeft maar twee stijlen, voor en achter. Schroef de boom met RVS 4 x 40 door de plaat in het hout erachter: bovenaan in de voorste stijl en de bovenregel, aan de voet in de achterste stijl en de onderregel. Druk de rest van de lijmnaad aan met RVS 3,5 x 16 van buitenaf: vanuit de open vakken van D door de gaatjes en de plaat in de boom. Niet langer dan 16 mm, anders komt de punt aan de katkant door de boom. Die schroeven mogen blijven zitten. Veeg uitgelopen lijm aan de katkant weg. Zet de voet van beide bomen schuin vast in de vloer. De lip van de rechterboom steekt boven de wanden uit; zet de rechterkant van die boom precies 325 mm uit de linkerrand van de vloer, want de lip komt straks strak naast de balk rechts van het trapgat. Maak schroefpunten aan de katkant nu onschadelijk. Na de tussenvloer is de trap niet meer uit te nemen.

Kattenchalet bouwplan | Rev K, 6-11-2026 | Zaaglijst, stappenplan en onderhoud, pagina 8

### 7. Tussenvloer

- Bouw cassette G volgens blad T6: de randen voor en achter over de koppen van de balken (621), 2 schroeven 5 x 80 per verbinding. Schroef de opvulstrook (44 x 69, op 25 mm gerift) tegen de linkerbalk en zet de raveelbalk tussen de opvulstrook en de balk rechts van het trapgat. Leg het frame ondersteboven. Lijm en schroef de onderplaat erop, met de gelakte kant naar beneden en het trapgat op zijn plek. Lijm de dagkanten (Lightply, 69 hoog) langs de linker- en voorkant van het trapgat.
- Zet de cassette, nog zonder vloerplaat, met twee personen op de benedenwanden, rondom gelijk met de buitenkant. Laat hem voorzichtig over de lip van de rechterboom zakken: die moet in het trapgat komen, tegen de balk rechts ervan. Schroef vanuit de open wandvakken om de 300 mm met 5 x 80 omhoog, door de bovenregels en de onderplaat in de randen en balken. Schroef daarna door het trapgat de lip met 2 RVS 4 x 40, voorgeboord, in die balk.
- Leg PIR 70 tussen de balken, ook achter de raveelbalk van het trapgat. Schuur de PIR zo nodig 1 mm vlak en tape de naden met alu-tape. Lijm en schroef de vloerplaat (betonplex, trapgat uitgezaagd) met RVS 4 x 40. Zet daarna de PIR in de benedenwanden C, D, E en F en tape de naden. In E komt ook PIR boven de latei. De lucht komt laag binnen, via de inlaat onder het luik.

### 8. Bovenwanden

- Bouw de frames I, J en K volgens blad T9, met de platen zoals beneden. Zaag in de achterplaat van I het gat voor de ventilatiebuis (Ø102, op de buismaat): hart 159 mm uit de rechterrand, gezien vanuit de kamer, en 401 mm boven de vloer.
- Zet I, J en K op de cassette zoals de benedenwanden: I eerst, J en K ertegen, en verbind ze vanuit de vakken. Schroef de onderregels met 5 x 80 door de vloerplaat in de cassette. Zet de twee hoekstijlen van wand H voor J en K, net als de raamstijlen B voorlopig met één schroef. Meer zit er niet in de voorwand: het raam komt ertussen.

### 9. Plafond en dak

- Bouw de plafondcassette L zoals de tussenvloer, met de plafondplaat met de gelakte kant naar beneden. Zet hem op de bovenwanden en schroef vanuit de wandvakken omhoog. Boven het raam rust de rand voor alleen op de hoekstijlen; tussen rand en kozijn blijft 5 mm. Leg PIR in de wanden I, J en K en tussen de plafondbalken, en tape alle naden. Snijd in wand I de PIR uit rond het gat voor de ventilatiebuis.
- Zaag 4 sporen en 2 zijsporen op 1003 mm en schuin, van 56 voor naar 29 achter (blad T7). Schroef de sporen recht boven de plafondbalken, 172 mm voor en 122 mm achter het regelwerk uit. Zet de zijsporen 122 mm buiten de zijkant van het regelwerk, met per kant 3 rijklossen van 78 mm naar de buitenste spoor: boven de voorwand, in het midden en boven de achterwand. De bovenkant van elke klos loopt schuin mee met de sporen. Boor in elke klos een gat Ø16 zodat er lucht langs kan.
- Boeiboorden: voor en achter (1384) tegen de koppen van sporen en zijsporen, 2 schroeven 5 x 80 per spoor. Daarna links en rechts (1039) over de zijsporen en de koppen van voor en achter. De bovenkant komt 11 mm boven de sporen, gelijk met de dakplaat, en de onderkant 33 mm onder de sporen.
- Leg de dakplaat (1384 x 1003) tussen de boeiboorden, met de lange kant dwars op de sporen. Schroef hem met RVS 4 x 40 om de 150 mm in sporen en zijsporen en rond de hoeken af. Houd de plaat droog tot de EPDM erop zit.
- Snij de EPDM (1520 x 1300) eerst op maat: 1520 over de breedte en in de diepte 1039 plus 30 mm voor en achter. Links en rechts snij je de overmaat af tot 30 mm. Zo valt er rondom 30 mm over de boeiboorden, net onder de trim van 28 mm. De rest, een strook van ca. 1520 x 201, bewaar je voor het bovenraam. Lijm de EPDM met Coverbond contactlijm volgens het blik, bij droog weer boven 5 °C: smeer plaat en EPDM allebei in, laat afdampen en leg het in één keer goed. Test eerst op zuigende OSB of primer nodig is. Werk naden en randen af met EPDM-kit. Daktrim (Brute 35 x 28): zaag de 2 lengtes op 1420 en 1039 met de hoeken in verstek; meet eerst, want het is krap. Schroef met RVS 4,5 x 35 om de ca. 200 mm: bij de sporen en zijsporen door de plaat in het spoor, daartussen in de bovenkant van het boeiboord. Alleen in 11 mm OSB houdt de schroef niet. Hang het gootje met afschot aan het achterste boeiboord, met de afvoer weg van de schutting.
- Het casco is nu regendicht. Laat het droog nakijken voordat je verdergaat.

Kattenchalet bouwplan | Rev K, 6-11-2026 | Zaaglijst, stappenplan en onderhoud, pagina 9

### 10. Folie en spouw

- Breng de folie aan op alle gevels rond het casco, met minstens 100 mm overlap en boven over onder. Vouw de folie in de raamopeningen om tot op de stijlen en plak hem vast met folietape.
- Ventilatiebuis: steek de PVC-buis door de achterplaat en de PIR naar buiten, met licht afschot naar buiten, zo lang dat hij straks gelijk komt met de buitenkant van de gevelplanken. Plak de folie rond de buis af met folietape.
- Spouwlatten volgens bladen T2 en T3, met RVS 4 x 40 om de 300 mm. Een lat mag uit meerdere stukken bestaan: 9 latten van 2500 zijn genoeg (samen 17,9 m nodig). Leg elke naad op hout, met minstens 2 schroeven per stuk, geen stukken korter dan 300 mm, en verdeel de naden over de hoogte. Behandel de zaagvlakken. De achterlatten staan recht voor de stijlen van beide verdiepingen. De middelste lat van elke zijwand heeft geen stijl achter zich: schroef hem in elke regel en zijbalk die hij kruist (tussen de regels ca. 420 mm vrij), niet in de PIR.
- Voorkant: de latten onder beide ramen (band tussenvloer en voorrand vloer) komen met de bovenkant precies gelijk met de vloer, want het kozijn steunt erop. Onderbreek de lat boven het bovenraam in het midden over 10 mm voor de ventilatie. Laat de spouw onder en boven open en dek af met stroken RVS-gaas van ca. 40 mm breed, in een L gevouwen. Draag handschoenen; er mogen geen draadjes uitsteken.

### 11. Ramen

- Schroef eerst de band tussenvloer (90 hoog) en de voorrand vloer (96 hoog) met RVS 4 x 40 op de latten, met de bovenkant gelijk met de vloer erachter. Laat links en rechts 58 mm vrij voor de hoeklatten.
- Zaag het lekdorpelprofiel op 1070 en 600 mm, zodat het 35 mm (boven) en 50 mm (beneden) voorbij elke kant van het kozijn steekt, en maak de randen glad. Zet de staande zijde tegen de voorkant van de band of voorrand, met de bovenkant gelijk met de vloer en de schuine zijde naar buiten. Niet hoger, anders staat het kozijn scheef. Voorboor en schroef met RVS 3,5 x 25 om de 200 mm en kit de gaten. Kit ook de open kopjes dicht.
- Lijm de EPDM op de vloerplaat, over de bovenrand van de band en langs de staande zijde omlaag, tot minstens 10 mm op de schuine zijde. Laat achter een rand van 30 mm vrij, die straks achter het kozijn omhoog komt. Geen stelblokjes en geen dorpellat: het kozijn staat direct op de EPDM.
- Plaats het raam binnenstebuiten, kozijn gelijk met de gevel, waterpas en haaks op de vloer. Schuif de stijlen links en rechts er strak tegenaan, met 1 mm speling per kant: gebruik een plaatje van 1 mm als maat en haal het daarna weg. Zet de stijlen nu definitief vast: onder en boven een hoekanker, en 2 schroeven 5 x 80 in de wandstijl erachter. Kies rechte stijlen, want een kromme stijl trekt het kozijn mee. In de kopvoeg van 5 mm komt bij elk bevestigingspunt boven een wig van 6 mm. Meet of het kozijn recht blijft.
- Bevestig met kozijnschroeven 7,5 x 112, Torx T30, voorgeboord, op ongeveer 55 mm van de gevel: maximaal 150 mm uit de binnenhoeken en maximaal 600 mm onderling, bij voorkeur bij de sluitpunten. Bovenraam: 2 per zijkant in de hoekstijlen en 3 boven. Onderraam: 2 per zijkant in de raamstijlen en 2 boven. Niet door de onderkant: dat doorboort de EPDM. Controleer de bediening en stel het beslag zo nodig af. Verlijm de EPDM-rand tegen de achterkant van het kozijn.
- Kit de zijvoegen tussen kozijn en stijl aan de buitenkant af, en kit ook de kopvoeg, de glaslatten en de naden. Vul de kopvoeg achter de kit met weinig PU-vulschuim of minerale wol en laat het raam vast staan tot het schuim hard is. Kit niet dicht wat water moet afvoeren. Controleer of de vleugel vrij langs de dorpel draait, controleer de bediening en blokkeer of beveilig de kiepstand.
- Watertest, nu het nog open is: spoel beide ramen 15 minuten met een tuinslang van boven naar beneden, met de ramen dicht. Kijk aan de binnenzijde van het kozijn en onder de dorpel. Lekt het, los dat eerst op.

Kattenchalet bouwplan | Rev K, 6-11-2026 | Zaaglijst, stappenplan en onderhoud, pagina 10

### 12. Gevel

- Monteer de hoeklatten op de hoeken (blad T2), met RVS 4 x 40 in de spouwlatten.
- Gevelplanken van onder naar boven, tong omhoog, stomp tegen de hoeklatten. De onderste plank komt 15 mm onder de onderkant van het vloerframe en loopt evenwijdig aan het frame. Deze plank zit maar ca. 115 mm boven de tegels en vangt spatwater: zaag de onderrand schuin af als druiprand, verzegel hem met kopshoutverzegeling en schroef de plank zonder lijm, zodat je hem later los kunt vervangen. De bovenste rij is de gerifte strook van 47 mm. Schroef met RVS 4 x 40 in de spouwlatten en boor voor aan de plankeinden. Zaag de planken achter rond de ventilatiebuis uit.
- Voorkant: de kaderstijlen naast de ramen, het kader boven het bovenraam en de afdekking van de open wandkop van de veranda (blad T2). Plaats de regenluifel tussen de hoeklatten op 5 RVS-consoles, op ca. 30 cm afstand, 12 mm aflopend naar voren en met de achterkant tegen de band; kit die naad. Lijm een EPDM-rest over de bovenkant, met een druiprand aan de voorkant. Laat de lekdorpel van het bovenraam erboven vrij drupen. Controleer of de vleugels vrij blijven draaien.
- Schroef de onderplaten van het overstek (betonplex) onder de sporen, zijsporen en rijklossen. Houd 15 mm spleet tot de gevel en leg daar RVS-gaas in: hier ventileren spouw en dak.

### 13. Ventilatie

- Ventilatie: kit de buis rondom aan de gevel. Buitenrooster met een rondje RVS-gaas erachter, binnen het afsluitbare rooster.

### 14. Inwerken

- Kattenluik: zet het de eerste weken vast open, zodat de kat went. Zet het binnenpaneel er alleen in als je de doorgang wilt afsluiten, bijvoorbeeld voor de dierenarts. Laat het chalet luchten tot je de lak niet meer ruikt. Leg mat en mand, hang de hygrometer op en controleer alle schroefpunten aan de katkant.
- Test 3 dagen zonder kat: temperatuur, vocht, condens, de kap en de stand van het rooster.
- Laat de kat wennen met de voeding op de veranda. Controleer de eerste weken de hygrometer, de goot en de wanden, en na elke harde bui de binnenzijde van de kozijnen.

### 15. Vastzetten aan de schutting

- Zet het chalet pas vast als alles af is en het zeker op de goede plek staat. Los op zijn voeten kan het bij een harde windstoot op de voorkant (rond 75-85 km/h op chalethoogte, berekening met aannames) achterover tegen de schutting kantelen, en bij harde wind van achteren of opzij naar voren. Met de ramen op het zuidoosten is dat zeldzaam, maar niet uitgesloten, vooral bij onweersbuien.
- Tot het vast staat: kijk bij de weerberichten naar windwaarschuwingen. Bij code oranje voor wind zet je het chalet tijdelijk vast met een spanband: horizontaal om het chalet, ter hoogte van de tussenvloer, en om twee schuttingpalen. Leg hoekbeschermers of een doek onder de band op de hoeklatten, zodat de beits niet beschadigt. De schutting voorkomt kantelen naar achteren, de band kantelen naar voren.
- Definitief: twee afstandhouders van geïmpregneerd 44 x 69 tussen de achterwand en de schuttingpalen, ter hoogte van de plafondrand. Aan de chalet-kant elk met 2 RVS constructieschroeven door gevelplank en spouwlat in de achterrand van het plafond, recht achter een achterlat; aan de schutting met een RVS hoekanker of bout in de bankirai-paal. Bankirai is erg hard: altijd voorboren. Valt er geen paal recht achter het chalet, schroef dan eerst een regel horizontaal over twee palen. De precieze uitvoering volgt na het meten van de palen (aanname, nog uit te werken).
- Losmaken kan altijd: schroeven eruit, dan blijven er alleen gaatjes in de palen achter.

Kattenchalet bouwplan | Rev K, 6-11-2026 | Zaaglijst, stappenplan en onderhoud, pagina 11

## Onderhoud

- Elk jaar voor de winter: kit, EPDM, trim, gootje, gaas en roosters nakijken; hygrometer vergelijken.
- Onderste gevelplank en voet van de hoeklatten: elk jaar nakijken en zo nodig bijbeitsen; die krijgen spatwater van de tegels. De plank is los te vervangen.
- Stelvoeten: elk jaar kijken of alle voeten nog dragen, of de contramoeren vast zitten en of er roest bij de inslagmoeren zit. Zolang het chalet niet vast staat: let op windwaarschuwingen (stap 15).
- Dak: niet op de plaat staan of er een ladder tegen zetten. Maak het schoon vanaf een trap ernaast.
- Ramen: elk seizoen de goot en buitennaden controleren, want daar zit het grootste risico. Regelmatig reinigen en het beslag twee keer per jaar smeren.
- Gevel: Douglas vraagt om regelmatig bijhouden. Hornbach adviseert onbehandeld Douglas om de 2 jaar te beitsen; voor de Hybride houtbeits noemt Hornbach tot 7 jaar bescherming, afhankelijk van weer en constructie. Controleer jaarlijks en herstel beschadigingen direct.
- Binnen: met water en mild schoonmaakmiddel. Lak op tijd bijwerken bij krassen. Geen producten die voor de kat schadelijk zijn.

Bronnen
- Hornbach-pagina's bekeken op 6-11-2026: kelderraam 12074105, ARON Basic+ 12331530, betonplex 12628592, Elliotis Pine 10000081, TENCO Bootlak 10728553 (met productinformatieblad), Premiumfol Bonding Adhesive 12218370, betonmortel 7195709, PIR 10368509, EPDM 10469549, daktrim 5581276, Douglas 10537457, vuren 5185884 en 5185888, antraciet beits 10277060, folie 7049802. Op 10-11-2026: LIGHTPLY multiplex 12575686 met verwerkingsvoorschrift (as.170091148). Op 12-11-2026: Hettich stelvoet M10x75 Ø75 RVS 4297033 (belastbaarheid 50 kg, verstelbereik niet opgegeven) en Dresselhaus inslagmoer 10x13 3857241.
- KNMI: Windstotenklimatologie van Nederland (TR-306, 2009), figuren 5 en 7.
- ARON Basic+ 70 mm technisch blad en montageaanbeveling RC 1/RC 2 (Hornbach, as.187466783, as.187466663), door mij toegepast op een houten wand en op het kelderraam; maattekening kelderraam (as.91729658).
- IKO enertherm: Hornbach-productinformatie. Premiumfol: verwerkingsvoorschrift en handleiding via Hornbach.
- Zonneopbrengst: 2 % van jaaropbrengst in december (18 kWh per kWp) tot circa 32 kWh per kWp volgens verschillende Belgische en Britse bronnen; indicatief.
- Kiepraam en katten: Dierenbescherming en KNMvD, via AVROTROS Radar en Hart van Nederland.
- Binnenstebuiten monteren: geen bron gevonden die dit bevestigt of beschrijft; eigen beoordeling.
