jeroenweij/kat/bouwplan/Kattenchalet_bestellijst.xlsx

Kattenchalet: waar haal ik wat?
Kies in kolom H per regel waar je het haalt. Vul bij Drive In de prijs in kolom G in; anders telt de Hornbachprijs. Gele cellen mag je aanpassen. Prijzen incl. btw, Hornbach 11-11-2026.
Artikel | Art.nr. Hornbach | Aantal | Eenheid | Volgens plan | Prijs Hornbach € | Prijs Drive In € | Waar vandaan | Regeltotaal € | Opmerking
Hout en plaat
Betonplex Acacia 2500x1250x12 mm | 12628592 | 1 | st | 1 | €57.49 |  | Zelf pakken / uitzoeken | €57.49 | Laten zagen: zaagplan bouwmarkt-PDF
LIGHTPLY Multiplex ongegrond 244x122 cm, 9 mm | 12575686 | 2 | st | 2 | €22.49 |  | Zelf pakken / uitzoeken | €44.98 | Laten zagen: zaagplan bouwmarkt-PDF
Constructieplaat OSB-III 4-zijdig recht 2440x1220x11 mm | 10222931 | 1 | st | 1 | €18.55 |  | Zelf pakken / uitzoeken | €18.55 | Laten zagen: zaagplan bouwmarkt-PDF
KONSTA Vuren balk geschaafd 44 x 69 x ca. 3600 mm | 5185891 | 4 | st | 4 | €6.49 |  | Zelf pakken / uitzoeken | €25.96 | Goedkoopste mix 4 + 12; 6 + 9 past ook
KONSTA Vuren balk geschaafd 44 x 69 x ca. 2400 mm | 5185888 | 12 | st | 12 | €4.30 |  | Zelf pakken / uitzoeken | €51.60
Regel geschaafd geïmpregneerd grenen 4,5 x 6,8 x 360 cm | 4178220 | 2 | st | 2 | €6.75 |  | Zelf pakken / uitzoeken | €13.50 | Vloerframe A
Paal vierkant grenen geïmpregneerd 6,8 x 6,8 x 180 cm | 4168915 | 1 | st | 1 | €6.69 |  | Zelf pakken / uitzoeken | €6.69 | 6 poten van 95
Lat/regel geïmpregneerd grenen 2,1x4,5x250 cm | 2094248 | 10 | st | 10 | €5.49 |  | Zelf pakken / uitzoeken | €54.90 | Spouwlatten; gebruiksklasse vragen
Dakbeschot/blokhutprofielplank douglas 1,8x14,5x300 cm | 10537457 | 16 | st | 16 | €11.59 |  | Zelf pakken / uitzoeken | €185.44 | Recht en zonder grote kwasten uitzoeken
Isolatie, folie en afdichting
IKO PIR enertherm T&G Rd 3,15 1200x600x70 mm, pak 7 st | 10368509 | 1 | pak | 1 | €93.30 |  | Drive In bouwmaterialen | €93.30 | Alu-cachering controleren
MIOFOL 125G waterkerende dampdoorlatende folie 1,5x25 m | 7049802 | 1 | rol | 1 | €60.95 |  | Drive In bouwmaterialen | €60.95
VASTR Folie tape basic 75 mm x 25 m | 7235130 | 1 | rol | 1 | €13.50 |  | Drive In bouwmaterialen | €13.50 | Voor de folie, niet voor PIR-naden
GAH.ALBERTS Lekdorpelprofiel 34x17 mm alu blank 200 cm | 10295993 | 1 | st | 1 | €8.75 |  | Zelf pakken / uitzoeken | €8.75 | Vorm in de winkel controleren
SOUDAL Soudaband BG 1 10/1-3 | 12731236 | 1 | st | 0 | €4.95 |  | Hornbach (bestellen) | €4.95 | Kozijnen
PRECIT PUR Montageschuim 750 ml | 10397249 | 2 | st | 1 | €5.95 |  | Drive In bouwmaterialen | €11.90 | Plan: weinig nodig, 1 bus is genoeg
SOUDAL PU-Schuim buisjes, pak 5 st | 7107046 | 1 | pak | 1 | €1.45 |  | Hornbach (bestellen) | €1.45
NOMA kurkplaat 50 cm x 1 m | 5980078 | 1 | plaat | 0 | €10.45 |  | Hornbach (bestellen) | €10.45 | JA voor de matverwarming
Fundering
HETTICH Stelvoet M10x75 mm Ø 75 mm RVS | 4297033 | 6 | st | 6 | €4.95 |  | Zelf pakken / uitzoeken | €29.70 | Prijs 12-11-2026. Los op de tegel; draadstift M10 en draadlengte controleren
DRESSELHAUS Inslagmoer 10x13 mm galv. verzinkt, 4 st | 3857241 | 2 | pak | 2 |  |  | Zelf pakken / uitzoeken |  | In de kopse kant van de poot. Prijs nog niet gecontroleerd; RVS-versie vragen
Bevestiging
SCHÄFER + PETERS Universele schroef 5,0x80 RVS A2, 100 st | 12085884 | 1 | pak | 1 | €24.95 |  | Hornbach (bestellen) | €24.95 | Boeiboorden en frame A (buiten, Douglas, geïmpregneerd)
DRESSELHAUS JD+ Universele schroef 4,5x80 blank verzinkt, 200 st | 6531094 | 1 | pak | 1 | €15.35 |  | Hornbach (bestellen) | €15.35 | Alleen binnen, vuren regelwerk
Spaanplaatschroef 4x40 Torx RVS A2, 100 st | 10529673 | 4 | pak | 4 | €4.95 |  | Hornbach (bestellen) | €19.80
Spaanplaatschroef 3,5x25 Torx RVS A2, 100 st | 10529674 | 4 | pak | 4 | €3.50 |  | Hornbach (bestellen) | €14.00
TOX Kozijnschroef Window Pro SK 7,5x112, 100 st | 5721305 | 1 | pak | 1 | €15.95 |  | Zelf pakken / uitzoeken | €15.95 | Vervangt Dresselhaus 6541412; geschikt voor hout controleren
WOLFCRAFT Voorboor Ø 3,2 mm met verzinkboor | 979771 | 1 | st | 1 | €5.25 |  | Hornbach (bestellen) | €5.25
PATTEX Houtlijm PU construct 750 g | 8547683 | 1 | st | 1 | €27.89 |  | Hornbach (bestellen) | €27.89
Afwerking
HORNBACH Hybride houtbeits grenen 2,5 l | 5509568 | 1 | blik | 1 | €36.95 |  | Hornbach (bestellen) | €36.95 | Eerst proefstuk
HORNBACH Hybride houtbeits RAL 7016 antraciet 750 ml | 10277060 | 1 | blik | 1 | €14.29 |  | Hornbach (bestellen) | €14.29
TENCO Jachtlak blank mat 750 ml | 10728553 | 2 | blik | 2 | €17.95 |  | Hornbach (bestellen) | €35.90
HORNBACH Kopshoutverzegeling randsealer transparant 750 ml | 5509590 | 1 | st | 1 | €21.49 |  | Hornbach (bestellen) | €21.49
Ventilatie en overig
ROTHEIGNER Ventilatierooster afsluitbaar wit Ø 100-125-150 | 4152757 | 1 | st | 1 | €4.05 |  | Hornbach (bestellen) | €4.05 | Binnen
ROTHEIGNER Ventilatierooster rond wit Ø 100 | 8610839 | 1 | st | 1 | €2.45 |  | Hornbach (bestellen) | €2.45 | Buiten
KAISERTHAL Ronde buis Ø 7x1 mm kunststof wit 100 cm | 4249568 | 1 | st | 0 | €1.40 |  | Zelf pakken / uitzoeken | €1.40 | Niet in het plan: waarvoor?, afstandsbusjes verwarmingsmat
HORNBACH Afdekzeil oranje/groen 2x3 m | 6300275 | 1 | st | 1 | €4.95 |  | Hornbach (bestellen) | €4.95
Nog niet in het winkelwagentje (volgens plan)
Kunststof wig zwart 6 mm, zak 50 st | 3067127 | 1 | zak | 1 | €3.92 |  | Zelf pakken / uitzoeken | €3.92 | Kopvoeg boven de ramen
Alu-tape voor PIR-naden, 50 mm |  | 1 | rol | 1 |  |  |  |  | Nog kiezen
RVS zeskantmoer M10 (contramoer) |  | 6 | st | 6 |  |  |  |  | Los uit de bak
Spanband met ratel, ca. 6 m |  | 1 | st | 1 |  |  |  |  | Tijdelijk bij code oranje wind, tot het chalet vast staat
Bevestiging aan de schutting (afstandhouders + RVS hoekankers) |  | 1 | set | 1 |  |  |  |  | Later: eerst de palen meten
Hoekankers met schroeven |  | 14 | st | 14 |  |  |  |  | Bij de poten: aan het frame, thermisch verzinkt of RVS
Kit voor buitenaansluitingen, geschikt voor kunststof |  | 1 | st | 1 |  |  |  |  | Ook zijvoegen kozijn
RVS consoles voor regenluifel |  | 5 | st | 5
Afsluitbare raamgreep |  | 2 | st | 2 |  |  |  |  | Passing controleren
Kiepbeveiliging voor katten |  | 2 | st | 2 |  |  |  |  | Veiligheid: verplicht
Houtgrondverf buiten, onder de beits |  | 1 | blik | 1
Dakgoot 1,5 m met afvoer en hangers |  | 1 | set | 1
Hygrometer met geheugen |  | 1 | st | 1
Sisal- of rubbermat voor treden; mat voor veranda |  | 1 | set | 1
Totalen
Waar vandaan |  | Regels |  |  |  |  |  | Bedrag €
Hornbach (bestellen) |  | 16 |  |  |  |  |  | €244.17
Drive In bouwmaterialen |  | 4 |  |  |  |  |  | €179.65
Zelf pakken / uitzoeken |  | 15 |  |  |  |  |  | €518.83
Nog niet gekozen |  | 13
Totaal |  |  |  |  |  |  |  | €942.65
Regels zonder prijs worden niet meegeteld.
