jeroenweij/kat/bouwplan/Kattenchalet_zaag_en_inkooplijst.xlsx

Sheet: Zaaglijst
Bouwdeel | Onderdeel | Materiaal | Aantal | Lengte mm | Breedte mm | Dikte mm | Opmerking | Gezaagd
A Vloerframe | Dwarsbalk | Geimpregneerd 44x69 | 3 | 621 | 69 | 44
A Vloerframe | Langsbalk achter | Geimpregneerd 44x69 | 1 | 1140 | 69 | 44
A Vloerframe | Langsbalk voor | Geimpregneerd 44x69 | 1 | 1140 | 69 | 44
A Vloerframe | Onderplaat vloer | OSB-3 11 | 1 | 1140 | 709 | 11 | uit de dakplaat-rest, 90 graden gedraaid; 6 sparingen 68x68 rond de poten
A Vloerframe | PIR vloer | PIR 70 alu | 1 | 621 | 481 | 70
A Vloerframe | PIR vloer | PIR 70 alu | 1 | 621 | 527 | 70
A Vloerframe | Poot | Geimpregneerde paal 68x68 | 6 | 95 | 68 | 68
A Vloerframe | Vloerplaat beneden | Betonplex 12 | 1 | 1140 | 709 | 12
B Voorwand beneden | Raamstijl | Vuren geschaafd 44x69 | 2 | 505 | 69 | 44 | geen regels: kozijn direct op de vloer
C Achterwand beneden | Binnenplaat | Lightply multiplex 9 (falcata, binnen) | 1 | 1140 | 505 | 9 | volle breedte, uit een stuk: geeft houvast in de hoeken
C Achterwand beneden | Bovenregel | Vuren geschaafd 44x69 | 1 | 1140 | 69 | 44
C Achterwand beneden | Onderregel | Vuren geschaafd 44x69 | 1 | 1140 | 69 | 44
C Achterwand beneden | PIR wand | PIR 70 alu | 1 | 481 | 417 | 70
C Achterwand beneden | PIR wand | PIR 70 alu | 1 | 527 | 417 | 70
C Achterwand beneden | Stijl | Vuren geschaafd 44x69 | 3 | 417 | 69 | 44
D Linkerwand beneden | Binnenplaat | Lightply multiplex 9 (falcata, binnen) | 1 | 600 | 505 | 9
D Linkerwand beneden | Bovenregel | Vuren geschaafd 44x69 | 1 | 587 | 69 | 44
D Linkerwand beneden | Onderregel | Vuren geschaafd 44x69 | 1 | 587 | 69 | 44
D Linkerwand beneden | PIR wand | PIR 70 alu | 1 | 499 | 417 | 70
D Linkerwand beneden | Stijl | Vuren geschaafd 44x69 | 2 | 417 | 69 | 44
E Scheidingswand | Bovenregel | Vuren geschaafd 44x69 | 1 | 587 | 69 | 44
E Scheidingswand | Latei kattenopening | Vuren geschaafd 44x69 | 1 | 200 | 69 | 44
E Scheidingswand | Onderregel voorste deel | Vuren geschaafd 44x69 | 1 | 343 | 69 | 44
E Scheidingswand | PIR boven doorgang | PIR 70 alu | 1 | 200 | 107 | 70
E Scheidingswand | PIR wand | PIR 70 alu | 1 | 417 | 255 | 70
E Scheidingswand | Plaat trapzijde | Lightply multiplex 9 (falcata, binnen) | 1 | 600 | 505 | 9 | uit een stuk; doorgang 200x310 uitzagen, randen afronden
E Scheidingswand | Plaat verandazijde | Lightply multiplex 9 (falcata, binnen) | 1 | 653 | 505 | 9 | uit een stuk; kattenluik 158x185 op 120 boven de vloer en luchtinlaat 140x70 op 15 uitzagen
E Scheidingswand | Stijl | Vuren geschaafd 44x69 | 2 | 417 | 69 | 44
E Scheidingswand | Stijl achter doorgang | Vuren geschaafd 44x69 | 1 | 461 | 69 | 44 | tot op de vloer: geen los stukje onderregel
E Scheidingswand | Versterking kattenluik | Lightply multiplex 9 (falcata, binnen) | 1 | 200 | 310 | 9 | restplaat, achter de verandaplaat gelijmd tussen de stijlen; uitsparing na het lijmen, door beide platen
F Rechterwand beneden | Binnenplaat | Lightply multiplex 9 (falcata, binnen) | 1 | 653 | 505 | 9 | loopt door tot achter de afdekking wandkop
F Rechterwand beneden | Bovenregel | Vuren geschaafd 44x69 | 1 | 631 | 69 | 44
F Rechterwand beneden | Onderregel | Vuren geschaafd 44x69 | 1 | 631 | 69 | 44
F Rechterwand beneden | PIR wand | PIR 70 alu | 1 | 543 | 417 | 70
F Rechterwand beneden | Stijl | Vuren geschaafd 44x69 | 2 | 417 | 69 | 44
G Tussenvloer | Balk | Vuren geschaafd 44x69 | 4 | 621 | 69 | 44
G Tussenvloer | Dagkant trapgat links | Lightply multiplex 9 (falcata, binnen) | 1 | 343 | 69 | 9
G Tussenvloer | Dagkant trapgat voor | Lightply multiplex 9 (falcata, binnen) | 1 | 247 | 69 | 9
G Tussenvloer | Onderplaat tussenvloer | Lightply multiplex 9 (falcata, binnen) | 1 | 1140 | 709 | 9 | met uitsparing trapgat 247x343
G Tussenvloer | Opvulstrook trapgat | Vuren geschaafd 44x69 | 1 | 621 | 69 | 25 | 44x69 rifen: steunt de plaat tot aan het trapgat
G Tussenvloer | PIR tussenvloer | PIR 70 alu | 1 | 256 | 225 | 70
G Tussenvloer | PIR tussenvloer | PIR 70 alu | 1 | 621 | 202 | 70
G Tussenvloer | PIR tussenvloer | PIR 70 alu | 1 | 621 | 481 | 70
G Tussenvloer | Rand achter | Vuren geschaafd 44x69 | 1 | 1140 | 69 | 44
G Tussenvloer | Rand voor | Vuren geschaafd 44x69 | 1 | 1140 | 69 | 44
G Tussenvloer | Raveelbalk trapgat | Vuren geschaafd 44x69 | 1 | 256 | 69 | 44
G Tussenvloer | Vloerplaat bovenkamer | Betonplex 12 | 1 | 1140 | 709 | 12 | met uitsparing trapgat 247x343
H Voorwand boven | Hoekstijl | Vuren geschaafd 44x69 | 2 | 505 | 69 | 44 | strak tegen het kozijn, 1 mm speling per kant
I Achterwand boven | Binnenplaat | Lightply multiplex 9 (falcata, binnen) | 1 | 1140 | 505 | 9 | volle breedte: houvast in de hoeken; gat d102 voor ventilatiebuis, op buismaat aanpassen
I Achterwand boven | Bovenregel | Vuren geschaafd 44x69 | 1 | 1140 | 69 | 44
I Achterwand boven | Onderregel | Vuren geschaafd 44x69 | 1 | 1140 | 69 | 44
I Achterwand boven | PIR wand | PIR 70 alu | 1 | 481 | 417 | 70
I Achterwand boven | PIR wand | PIR 70 alu | 1 | 527 | 417 | 70
I Achterwand boven | Stijl | Vuren geschaafd 44x69 | 3 | 417 | 69 | 44
J Linkerwand boven | Binnenplaat | Lightply multiplex 9 (falcata, binnen) | 1 | 600 | 505 | 9
J Linkerwand boven | Bovenregel | Vuren geschaafd 44x69 | 1 | 587 | 69 | 44
J Linkerwand boven | Onderregel | Vuren geschaafd 44x69 | 1 | 587 | 69 | 44
J Linkerwand boven | PIR wand | PIR 70 alu | 1 | 499 | 417 | 70
J Linkerwand boven | Stijl | Vuren geschaafd 44x69 | 2 | 417 | 69 | 44
K Rechterwand boven | Binnenplaat | Lightply multiplex 9 (falcata, binnen) | 1 | 600 | 505 | 9
K Rechterwand boven | Bovenregel | Vuren geschaafd 44x69 | 1 | 587 | 69 | 44
K Rechterwand boven | Onderregel | Vuren geschaafd 44x69 | 1 | 587 | 69 | 44
K Rechterwand boven | PIR wand | PIR 70 alu | 1 | 499 | 417 | 70
K Rechterwand boven | Stijl | Vuren geschaafd 44x69 | 2 | 417 | 69 | 44
L Plafond | Balk | Vuren geschaafd 44x69 | 4 | 621 | 69 | 44
L Plafond | PIR plafond | PIR 70 alu | 2 | 621 | 321 | 70
L Plafond | PIR plafond | PIR 70 alu | 1 | 621 | 322 | 70
L Plafond | Plafondplaat | Lightply multiplex 9 (falcata, binnen) | 1 | 1140 | 709 | 9
L Plafond | Rand achter | Vuren geschaafd 44x69 | 1 | 1140 | 69 | 44
L Plafond | Rand voor | Vuren geschaafd 44x69 | 1 | 1140 | 69 | 44
M Dak | Boeiboord achter | Douglas 18x145 (hoek/boei antraciet) | 1 | 1384 | 72 | 18
M Dak | Boeiboord links | Douglas 18x145 (hoek/boei antraciet) | 1 | 1039 | 101 | 18 | bovenrand schuin volgens dak
M Dak | Boeiboord rechts | Douglas 18x145 (hoek/boei antraciet) | 1 | 1039 | 101 | 18 | bovenrand schuin volgens dak
M Dak | Boeiboord voor | Douglas 18x145 (hoek/boei antraciet) | 1 | 1384 | 101 | 18
M Dak | Dakplaat | OSB-3 11 | 1 | 1384 | 1003 | 11 | tussen de boeiboorden
M Dak | Onderplaat overstek achter | Betonplex 12 | 1 | 1384 | 67 | 12
M Dak | Onderplaat overstek links | Betonplex 12 | 1 | 819 | 67 | 12
M Dak | Onderplaat overstek rechts | Betonplex 12 | 1 | 819 | 67 | 12
M Dak | Onderplaat overstek voor | Betonplex 12 | 1 | 1384 | 117 | 12
M Dak | Rijklos | Vuren geschaafd 44x69 | 6 | 78 | 69 | 44 | bovenkant schuin, gelijk met de sporen: aftekenen; gat d16 voor ventilatie
M Dak | Spoor afschot | Vuren geschaafd 44x69 | 4 | 1003 | 69 | 44 | schuin zagen: voor 56, achter 29 hoog
M Dak | Zijspoor | Vuren geschaafd 44x69 | 2 | 1003 | 69 | 44 | schuin zagen: voor 56, achter 29 hoog; draagt plaatrand, trim en zij-onderplaat
N Trap | Trapboom | Betonplex 12 | 1 | 815 | 130 | 12 | zaagtanden en lip 40 breed bovenaan, zie detail 6
N Trap | Trapboom | Betonplex 12 | 1 | 815 | 130 | 12 | zaagtanden, zie detail 6
N Trap | Trede | Betonplex 12 | 3 | 247 | 100 | 12 | op de tanden; anti-slip bekleden
N Trap | Trede | Betonplex 12 | 1 | 247 | 145 | 12 | op de tanden; rechts inkeping 12 x 40 voor de lip, 17 uit de voorkant; anti-slip bekleden
N Trap | Trede | Betonplex 12 | 1 | 247 | 150 | 12 | op de tanden; anti-slip bekleden
N Trap | Versterkingsstrook trapboom | Betonplex 12 | 1 | 630 | 30 | 12 | binnenkant rechterboom, langs de onderkant; uit de reststrook
P Spouwlatten | Lat achter | Spouwlat 22x44 | 3 | 1262 | 44 | 22
P Spouwlatten | Lat band tussenvloer | Spouwlat 22x44 | 1 | 1002 | 44 | 22 | bovenkant gelijk met vloer: kozijn steunt erop
P Spouwlatten | Lat kop raam boven | Spouwlat 22x44 | 1 | 1002 | 44 | 22 | 10 mm onderbreken voor ventilatie
P Spouwlatten | Lat links | Spouwlat 22x44 | 3 | 1262 | 44 | 22
P Spouwlatten | Lat rechts | Spouwlat 22x44 | 3 | 1262 | 44 | 22
P Spouwlatten | Lat voor beneden | Spouwlat 22x44 | 1 | 647 | 44 | 22
P Spouwlatten | Lat voor hoek | Spouwlat 22x44 | 2 | 1262 | 44 | 22
P Spouwlatten | Lat voorrand vloer | Spouwlat 22x44 | 1 | 431 | 44 | 22 | bovenkant gelijk met vloer
P Spouwlatten | Lat voorrand vloer | Spouwlat 22x44 | 1 | 502 | 44 | 22 | bovenkant gelijk met vloer
Q Gevelbekleding | Afdekking wandkop veranda | Douglas 18x145 (kader grenen beits) | 1 | 505 | 60 | 18 | dekt de open wandkop af
Q Gevelbekleding | Band tussenvloer | Douglas 18x145 (kader grenen beits) | 1 | 1104 | 90 | 18
Q Gevelbekleding | Hoeklat frontbreed | Douglas 18x145 (hoek/boei antraciet) | 4 | 1262 | 58 | 18
Q Gevelbekleding | Hoeklat zijkant | Douglas 18x145 (hoek/boei antraciet) | 4 | 1262 | 40 | 18
Q Gevelbekleding | Kader boven raam | Douglas 18x145 (kader grenen beits) | 1 | 1000 | 66 | 18
Q Gevelbekleding | Kaderstijl beneden links | Douglas 18x145 (kader grenen beits) | 1 | 505 | 52 | 18
Q Gevelbekleding | Kaderstijl beneden rechts | Douglas 18x145 (kader grenen beits) | 1 | 505 | 79 | 18
Q Gevelbekleding | Kaderstijl boven links | Douglas 18x145 (kader grenen beits) | 1 | 571 | 52 | 18
Q Gevelbekleding | Kaderstijl boven rechts | Douglas 18x145 (kader grenen beits) | 1 | 571 | 52 | 18
Q Gevelbekleding | Plank achter | Douglas 18x145 (hout zichtbaar) | 1 | 1104 | 47 | 18 | bovenste rij: plank rifen, tong eraf
Q Gevelbekleding | Plank achter | Douglas 18x145 (hout zichtbaar) | 9 | 1104 | 135 | 18
Q Gevelbekleding | Plank links | Douglas 18x145 (hout zichtbaar) | 1 | 673 | 47 | 18 | bovenste rij: plank rifen, tong eraf
Q Gevelbekleding | Plank links | Douglas 18x145 (hout zichtbaar) | 9 | 673 | 135 | 18
Q Gevelbekleding | Plank rechts | Douglas 18x145 (hout zichtbaar) | 1 | 673 | 47 | 18 | bovenste rij: plank rifen, tong eraf
Q Gevelbekleding | Plank rechts | Douglas 18x145 (hout zichtbaar) | 9 | 673 | 135 | 18
Q Gevelbekleding | Regenluifel | Douglas 18x145 (hoek/boei antraciet) | 1 | 1104 | 91 | 18 | tussen de hoeklatten, 12 mm aflopend naar voren; op 5 RVS consoles, EPDM met druiprand
Q Gevelbekleding | Voorrand vloer | Douglas 18x145 (kader grenen beits) | 1 | 1104 | 96 | 18

Sheet: Inkoop
Vul de gele cellen in met de actuele prijs. Blauw = prijs gezien op Hornbach.nl op 6-11-2026, incl. btw. Leeg artikelnummer = nog geen Hornbach-artikel gekozen. Totalen rekenen automatisch.
Artikel | Artikelnummer Hornbach | Aantal | Eenheid | Prijs € incl. btw | Regeltotaal € | Herkomst prijs | Status
Hout en plaat
KONSTA vuren 44x44, ca. 3600 | 5185886 | 0 | st | 5.29 | 0.00 | Hornbach, 6-11-2026 | Vervalt: scheidingswand en raamstijl nu 44x69
KONSTA vuren 44x44, ca. 2400 | 5185884 | 0 | st | 3.55 | 0.00 | Hornbach, 6-11-2026 | Gecontroleerd; zaagpatroon op tabblad Latten op lengte
KONSTA vuren 44x69, ca. 3600 | 5185891 | 3 | st | 6.49 | 19.47 | Hornbach, 6-11-2026 | Gecontroleerd; zaagpatroon op tabblad Latten op lengte. Exacte indeling, goedkoopste mix 3 + 11 (11-11-2026, ruime vakken). Wanden nu ook in 44x69
KONSTA vuren 44x69, ca. 2400 | 5185888 | 11 | st | 4.30 | 47.30 | Hornbach, 6-11-2026 | Gecontroleerd; zaagpatroon op tabblad Latten op lengte. Incl. zijsporen, rijklossen, balken 621 en scheidingswand 44x69
Geïmpregneerde balk 44-45 x 69-70, ca. 3600 | 4178220 | 2 | st | 6.75 | 13.50 | Eigen invoer | Zaagpatroon op tabblad Latten op lengte
Paal vierkant grenen geïmpregneerd 6,8 x 6,8 x 180 cm | 4168915 | 1 | st | 6.69 | 6.69 | Hornbach, 6-11-2026 | Gecontroleerd; 6 poten van 95 mm, ca. 1200 mm blijft over. Kopse kanten verzegelen
Lat/regel geïmpregneerd grenenhout 2,1x4,5x250 cm (spouwlat) | 2094248 | 9 | st | 5.49 | 49.41 | Hornbach, 6-11-2026 | Gecontroleerd; 17,9 m nodig, met naden op hout. Tabblad Latten op lengte toont hele stukken (11). Tanalith E, geschaafd. Gebruiksklasse vragen. Zaagvlakken behandelen
LIGHTPLY Multiplex ongegrond 244x122 cm, 9 mm | 12575686 | 2 | pl | 22.49 | 44.98 | Hornbach, 10-11-2026 | Gecontroleerd; falcata, binnen en beschut buiten, FSC, 10,72 kg. Vervangt Elliotis Pine. Geen reserve. Lijmklasse en formaldehydeklasse niet gevonden
Betonplex Acacia 2500x1250x12 | 12628592 | 1 | pl | 57.49 | 57.49 | Hornbach, 6-11-2026 | Gecontroleerd; vloeren, trap en overstek, 1 plaat. Rest voor de strook op de trapboom
Constructieplaat OSB-III 4-zijdig recht 2440x1220x11 mm | 10222931 | 1 | pl | 18.55 | 18.55 | Hornbach, 6-11-2026 | Gecontroleerd; dak (1400 x 1003, tussen de boeiboorden) plus onderplaat vloer uit 1 plaat. Lange kant dwars op de sporen. Trimschroeven in sporen, zijsporen en boeiboord
Douglas 18x145x3000 tand-en-groef, gevel + kader | 10537457 | 16 | st | 11.59 | 185.44 | Hornbach, 6-11-2026 | Gecontroleerd; werkende breedte ca. 135
Isolatie en folie
IKO PIR 70 Rd 3,15, pak 7 st = 5,04 m² | 10368509 | 1 | pak | 93.30 | 93.30 | Hornbach, 6-11-2026 | 7 platen nodig (ook scheidingswand), ca. 70 % benut sinds de ruime vakken. € 88,64 geldt pas vanaf 10 pak. Alu-cachering in vestiging bevestigen
MIOFOL 125G waterkerende dampdoorlatende folie, 1,5 x 25 m | 7049802 | 1 | rol | 60.95 | 60.95 | Hornbach, 6-11-2026 | Gecontroleerd; Sd 0,28 m, ca. 10 van 37,5 m² nodig. W-klasse en UV-duur niet gevonden: snel afdekken met gevelplanken
Alu-tape PIR, 50 mm |  | 1 | rol |  |  | Prijs nog opvragen
RVS 304 gaas, 20 mazen, ca. 1 mm, 40 x 200 cm (Amazon) | B0DL5P11F2 | 1 | rol | 18.99 | 18.99 | Eigen invoer, Amazon | Spouw en ventilatiebuis: stroken 40 mm, ca. 8 m, plus rondje. Maaswijdte bij ontvangst nameten
SOUDAL Soudaband BG1 20/5-10, 5,6 m | 12731245 | 0 | rol | 8.45 | 0.00 | Hornbach, 6-11-2026 | Vervalt: stijlen strak tegen het kozijn (1 mm speling), zijvoeg met kit
Dak
EPDM dakfolie 1,14 mm, 1,52 x 1,30 m |  | 1.98 | m² | 10.95 | 21.68 | Dakvoordeelshop, besteld 9-11-2026 | Prijzen incl. btw. Dak 1420 x 1039 met 1520 over de breedte; rest ca. 1520 x 200 voor het bovenraam. Te kort voor onderraam, luifel en flap
Coverbond contactlijm EPDM, blik 1 liter |  | 1 | st | 14.09 | 14.09 | Dakvoordeelshop, besteld 9-11-2026 | Beide kanten insmeren; op zuigende OSB eerst testen of primer nodig is
EPDM kit 290 ml |  | 2 | st | 7.99 | 15.98 | Dakvoordeelshop, besteld 9-11-2026 | Naden en randen dak, kopjes lekdorpel
Aluminium daktrim Brute 35 x 28 x 2500 mm |  | 2 | st | 10.39 | 20.78 | Dakvoordeelshop, besteld 9-11-2026 | Per stuk 1420 + 1039 = 2459 van 2500, hoeken in verstek. Krap: eerst meten
Aluminium verbindingsplaatje daktrim 35 mm, Brute |  | 3 | st | 0.13 | 0.39 | Dakvoordeelshop, besteld 9-11-2026 | 2 gratis, 1 x 0,39
Daktrimschroef RVS A2 4,5 x 35 mm, 25 stuks |  | 1 | pak | 9.99 | 9.99 | Dakvoordeelshop, besteld 9-11-2026 | Om de ca. 200 mm: in spoor, zijspoor of boeiboord
Dakgoot 1,5 m met afvoer en hangers |  | 1 | set |  |  | Prijs nog opvragen | Afvoer weg van de schutting, naar een plek waar het water weg kan
Verzending Dakvoordeelshop minus factuurkorting |  | 1 | st | 5.80 | 5.80 | Dakvoordeelshop, besteld 9-11-2026 | 9,95 transport, -4,15 korting. Factuur totaal 88,71
Ramen
Kelderraam 100x50 draai/kiep links RAL9016 | 12074105 | 1 | st | 94.50 | 94.50 | Hornbach, 6-11-2026 | Gecontroleerd; geen greep meegeleverd
ARON Basic+ 50x50 DK links | 12331530 | 1 | st | 109.00 | 109.00 | Hornbach, 6-11-2026 | Gecontroleerd; geen greep meegeleverd
Afsluitbare raamgreep |  | 2 | st |  |  | Prijs nog opvragen | Zit buiten, dus afsluitbaar. Passing bij aankoop controleren
Kiepbeveiliging voor katten, of kiepstand blokkeren |  | 2 | st |  |  | Prijs nog opvragen | Zie veiligheid
GAH.ALBERTS Lekdorpelprofiel 34x17 mm alu blank 200 cm | 10295993 | 1 | st | 8.75 | 8.75 | Hornbach, 6-11-2026 | Gecontroleerd; 1070 + 600 uit 1 stuk. Tegen de band, EPDM eroverheen, niet onder het kozijn. Vorm in de winkel controleren
Kit voor buitenaansluitingen en glaslatten, buitenkwaliteit |  | 1 | set |  |  | Prijs nog opvragen | Geschikt voor kunststof; ook voor de zijvoegen tussen kozijn en stijl
RVS consoles voor regenluifel |  | 5 | st |  |  | Prijs nog opvragen | Luifel tussen de hoeklatten, 12 mm aflopend; bovenkant met EPDM-rest en druiprand
Fundering
HETTICH Stelvoet M10x75 mm Ø 75 mm RVS | 4297033 | 6 | st | 4.95 | 29.70 | Hornbach, 12-11-2026 | Los op de tegel, rest-EPDM eronder. Belastbaarheid 50 kg (meubel), verstelbereik niet opgegeven: draadlengte in de winkel meten. Breda had er 9 op 12-11
DRESSELHAUS Inslagmoer 10x13 mm galv. verzinkt, 4 stuks | 3857241 | 2 | pak |  |  | Prijs nog opvragen | In de kopse kant van de poot; draad invetten, rand kitten tegen roest. RVS-versie (Marinetech M10x12) online niet leverbaar: in de winkel vragen
RVS zeskantmoer M10 (contramoer) |  | 6 | st |  |  | Prijs nog opvragen | Los uit de bak; pak van 100 (art. 3836629) is te veel
Spanband met ratel, ca. 6 m |  | 1 | st |  |  | Prijs nog opvragen | Tijdelijk bij code oranje wind, tot het chalet aan de schutting vast staat (stap 15)
Bevestiging aan de schutting: 2 afstandhouders 44x69 + RVS hoekankers en schroeven |  | 1 | set |  |  | Prijs nog opvragen | Na de bouw. Uitwerken na het meten van de palen; bankirai voorboren
Betonmortel 25 kg (6 poeren 300x300x500 onder de tegels = 270 liter) | 7195709 | 0 | zak | 3.95 | 0.00 | Hornbach, 6-11-2026 | Vervalt (12-11-2026): poeren vervallen; chalet staat los op stelvoeten
KAISERTHAL U-paalhouder met betonanker 71x100x200, thermisch verzinkt | 3896646 | 0 | st | 2.95 | 0.00 | Hornbach, 6-11-2026 | Vervalt (12-11-2026): stelvoeten in plaats van paalhouders; chalet staat los op stelvoeten
RVS bout M10 x 100 met 2 ringen en moer |  | 0 | st |  |  | Prijs nog opvragen | Vervalt (12-11-2026): geen paalhouders meer; chalet staat los op stelvoeten
Cementmortel 25 kg voor het tegelbed |  | 0 | zak |  |  | Prijs nog opvragen | Vervalt (12-11-2026): geen tegels meer uit; chalet staat los op stelvoeten
Diamantboor Ø25 voor de tegels |  | 0 | st |  |  | Prijs nog opvragen | Vervalt (12-11-2026): geen gaten in de tegels; chalet staat los op stelvoeten
Reservetegels, zelfde als het terras |  | 0 | st |  |  | Prijs nog opvragen | Vervalt (12-11-2026): tegels blijven liggen; chalet staat los op stelvoeten
Ventilatie en meting
PVC-buis Ø100 (eigen restant) |  | 1 | st |  |  | Eigen voorraad | Ca. 150 mm nodig; buitenmaat meten
ROTHEIGNER Ventilatierooster afsluitbaar Ø100-125-150, binnen | 4152757 | 1 | st | 4.05 | 4.05 | Hornbach, 6-11-2026 | Traploos regelbaar niet vermeld: in de winkel bekijken
ROTHEIGNER Ventilatierooster rond wit Ø100, buiten | 8610839 | 1 | st | 2.45 | 2.45 | Hornbach, 6-11-2026 | Past op de buis? Meten. Insectenwering erachter
Hygrometer met geheugen |  | 1 | st |  |  | Prijs nog opvragen
Afwerking en bevestiging
HORNBACH Hybride houtbeits grenen, 2,5 l | 5509568 | 1 | blik | 36.95 | 36.95 | Hornbach, 6-11-2026 | Gecontroleerd; gevel en kader. Op Douglas warmer dan op het plaatje: eerst proefstuk. Grondverf: zie regel hieronder
Houtgrondverf voor buiten, onder de beits (tegen blauwkleuring) |  | 1 | blik |  |  | Prijs nog opvragen | Nog geen artikel: online geen passende transparante, watergedragen primer gevonden. Vragen in Breda, verf gang 23
HORNBACH Hybride houtbeits RAL 7016 antraciet, 750 ml | 10277060 | 1 | blik | 14.29 | 14.29 | Hornbach, zoekresultaat 6-11-2026 | Hoeklatten, boeiboorden en regenluifel, 3 lagen rondom: ca. 0,55 l. Transparant, nerf blijft zichtbaar: eerst proefstuk. Niet egaal zoals op tekening
TENCO Bootlak blank mat 750 ml | 10728553 | 2 | st | 17.95 | 35.90 | Hornbach, 6-11-2026 | Alle binnenwanden, minstens 3 lagen, ca. 1,1 l. Binnen en buiten, uv-bestendig. Oplosmiddel: goed laten luchten. Fabrikant noemt hardhout: eerst testen
PATTEX Houtlijm PU construct 750 g | 8547683 | 1 | st | 27.89 | 27.89 | Eigen invoer | Watervast, schuimt licht. Bevat isocyanaten: handschoenen en ventilatie
HORNBACH Kopshoutverzegeling randsealer transparant 750 ml | 5509590 | 1 | st | 21.49 | 21.49 | Hornbach, 6-11-2026 | Gecontroleerd; 2 lagen op plaatranden en kopse kanten, niet op de vlakken. Niet onder +10 °C
RVS schroeven 3,5x25, 100 stuks |  | 4 | pak |  |  | Prijs nog opvragen | Binnenplaten en lekdorpel; ruwe schatting, bijkopen kan. Voor de strook op de trapboom korter: 3,5x20, of inkorten
Hoekankers met passende schroeven, verzinkt of RVS |  | 14 | st |  |  | Prijs nog opvragen | 6 poten, 8 voorstijlen boven en onder; schatting
SCHÄFER + PETERS schroef 5,0x80 RVS A2, 100 stuks | 12085884 | 4 | pak | 24.95 | 99.80 | Hornbach, 6-11-2026 | Constructieschroeven; ca. 310 geteld uit het stappenplan (frames, wanden, cassettes, boeiboorden, rijklossen)
Spaanplaatschroef 4x40 Torx RVS A2, 100 stuks | 10529673 | 4 | pak | 4.95 | 19.80 | Hornbach, 6-11-2026 | Spouwlatten, gevelplanken, hoeklatten, OSB onder de vloer, vloer- en dakplaten. Ruwe schatting, bijkopen kan
VASTR Folie tape basic 75 mm x 25 m | 7235130 | 1 | rol | 13.50 | 13.50 | Hornbach, 6-11-2026 | Voor de folie; niet voor de PIR-naden, daarvoor alu-tape
HORNBACH Afdekzeil 2x3 m | 6300275 | 1 | st | 4.95 | 4.95 | Hornbach, 6-11-2026 | Hout droog houden tijdens de bouw
DRESSELHAUS Kozijnschroef kunststofprofiel 7,5x112 Torx T30, 100 stuks | 6541412 | 1 | pak | 20.95 | 20.95 | Hornbach, 6-11-2026 | 13 nodig. Alle stijlen naast de ramen zijn nu 69 breed; 112 houdt de punt binnen de stijl. Kozijnbreedte kelderraam meten
Kunststof wig zwart 6 mm, zak 50 stuks | 3067127 | 1 | zak | 3.92 | 3.92 | Hornbach, 6-11-2026 | Alleen in de kopvoeg van 5 mm, bij de bevestigingspunten boven
Kunststof wig rood 3 mm, zak 50 stuks | 3067092 | 0 | zak | 3.45 | 0.00 | Hornbach, 6-11-2026 | Vervalt: geen zijvoeg van 9 mm meer
SOUDAL Vulschuim Genius 300 ml | 7923748 | 1 | bus | 5.95 | 5.95 | Hornbach, 6-11-2026 | Kopvoeg achter de kit; weinig gebruiken. Mag ook minerale wol
Sisal of rubbermat voor treden; mat voor veranda |  | 1 | set |  |  | Prijs nog opvragen
PetSafe 700 kattenluik S, wit (bol.com) |  | 1 | st |  |  | Prijs nog opvragen | Uitsparing 158 breed x 185 hoog, frame 198 x 236, katten tot 7 kg (volgens bol, niet geverifieerd; ca. 14,99). Zonder binnenframe in de verandaplaat van wand E, met versterking 18 mm; zie blad T14
Subtotaal ingevulde prijzen |  |  |  |  | 1258.62
Aantal regels zonder prijs |  |  |  |  | 17

Sheet: Latten op lengte
Materiaal | Lat nr. | Handelslengte mm | Zagen (mm) | Rest mm
Vuren geschaafd 44x69 | 1 | 3600 | 1140 + 1140 + 1140 + 78 | 90
Vuren geschaafd 44x69 | 2 | 3600 | 1140 + 1140 + 1140 + 78 | 90
Vuren geschaafd 44x69 | 3 | 3600 | 1140 + 1140 + 1003 + 256 | 49
Vuren geschaafd 44x69 | 4 | 2400 | 1003 + 1003 + 343 | 43
Vuren geschaafd 44x69 | 5 | 2400 | 1003 + 587 + 587 + 200 | 11
Vuren geschaafd 44x69 | 6 | 2400 | 1003 + 505 + 417 + 417 | 46
Vuren geschaafd 44x69 | 7 | 2400 | 1003 + 505 + 417 + 417 | 46
Vuren geschaafd 44x69 | 8 | 2400 | 631 + 621 + 621 + 505 | 10
Vuren geschaafd 44x69 | 9 | 2400 | 631 + 621 + 621 + 505 | 10
Vuren geschaafd 44x69 | 10 | 2400 | 621 + 621 + 587 + 461 + 78 | 16
Vuren geschaafd 44x69 | 11 | 2400 | 621 + 417 + 417 + 417 + 417 + 78 | 13
Vuren geschaafd 44x69 | 12 | 2400 | 621 + 417 + 417 + 417 + 417 + 78 | 13
Vuren geschaafd 44x69 | 13 | 2400 | 621 + 417 + 417 + 417 + 417 + 78 | 13
Vuren geschaafd 44x69 | 14 | 2400 | 587 + 587 + 587 + 587 | 40
Geimpregneerd 44x69 | 1 | 3600 | 1140 + 1140 + 621 + 621 | 66
Geimpregneerd 44x69 | 2 | 3600 | 621 | 2979
Geimpregneerde paal 68x68 | 1 | 1800 | 95 + 95 + 95 + 95 + 95 + 95 | 1210
Spouwlat 22x44 | 1 | 2500 | 1262 + 1002 | 232
Spouwlat 22x44 | 2 | 2500 | 1262 + 1002 | 232
Spouwlat 22x44 | 3 | 2500 | 1262 + 647 + 502 | 81
Spouwlat 22x44 | 4 | 2500 | 1262 + 431 | 803
Spouwlat 22x44 | 5 | 2500 | 1262 | 1238
Spouwlat 22x44 | 6 | 2500 | 1262 | 1238
Spouwlat 22x44 | 7 | 2500 | 1262 | 1238
Spouwlat 22x44 | 8 | 2500 | 1262 | 1238
Spouwlat 22x44 | 9 | 2500 | 1262 | 1238
Spouwlat 22x44 | 10 | 2500 | 1262 | 1238
Spouwlat 22x44 | 11 | 2500 | 1262 | 1238
Douglas 18x145 (hout zichtbaar) | 1 | 3000 | 1104x145 + 1104x145 + 673x145
Douglas 18x145 (hout zichtbaar) | 2 | 3000 | 1104x145 + 1104x145 + 673x145
Douglas 18x145 (hout zichtbaar) | 3 | 3000 | 1104x145 + 1104x145 + 673x145
Douglas 18x145 (hout zichtbaar) | 4 | 3000 | 1104x145 + 1104x145 + 673x145
Douglas 18x145 (hout zichtbaar) | 5 | 3000 | 1104x145 + 673x145 + 673x145
Douglas 18x145 (hout zichtbaar) | 6 | 3000 | 673x145 + 673x145 + 673x145 + 673x145
Douglas 18x145 (hout zichtbaar) | 7 | 3000 | 673x145 + 673x145 + 673x145 + 673x145
Douglas 18x145 (hout zichtbaar) | 8 | 3000 | 673x145 + 673x145 + 673x145 + 673x145
Douglas 18x145 (hout zichtbaar) | 9 | 3000 | 1104x47 + 673x47 + 673x47
Douglas 18x145 (hoek/boei/luifel antraciet + kader grenen beits) | 1 | 3000 | 1384x101 + 1104x96 + 1262x40
Douglas 18x145 (hoek/boei/luifel antraciet + kader grenen beits) | 2 | 3000 | 1039x101 + 1039x101 + 505x79 + 505x60
Douglas 18x145 (hoek/boei/luifel antraciet + kader grenen beits) | 3 | 3000 | 1104x91 + 1384x72 + 1262x58 + 571x52
Douglas 18x145 (hoek/boei/luifel antraciet + kader grenen beits) | 4 | 3000 | 1104x90 + 1262x58 + 1262x58 + 571x52 + 505x52
Douglas 18x145 (hoek/boei/luifel antraciet + kader grenen beits) | 5 | 3000 | 1262x58 + 1000x66 + 1262x40 + 1262x40 + 1262x40

Sheet: Platen op maat
Plaat | Plaatnr. | Onderdeel | Lengte mm | Breedte mm | x vanaf hoek mm | y vanaf hoek mm
Lightply 9, 2440x1220 | 1 | G Onderplaat tussenvloer | 709 | 1140 | 0 | 0
Lightply 9, 2440x1220 | 1 | L Plafondplaat | 709 | 1140 | 713 | 0
Lightply 9, 2440x1220 | 1 | C Binnenplaat | 505 | 1140 | 1426 | 0
Lightply 9, 2440x1220 | 1 | I Binnenplaat | 505 | 1140 | 1935 | 0
Lightply 9, 2440x1220 | 1 | G Dagkant trapgat links | 343 | 69 | 0 | 1144
Lightply 9, 2440x1220 | 1 | G Dagkant trapgat voor | 247 | 69 | 347 | 1144
Lightply 9, 2440x1220 | 2 | E Plaat verandazijde | 653 | 505 | 0 | 0
Lightply 9, 2440x1220 | 2 | D Binnenplaat | 600 | 505 | 657 | 0
Lightply 9, 2440x1220 | 2 | E Plaat trapzijde | 600 | 505 | 1261 | 0
Lightply 9, 2440x1220 | 2 | F Binnenplaat | 653 | 505 | 0 | 509
Lightply 9, 2440x1220 | 2 | K Binnenplaat | 600 | 505 | 657 | 509
Lightply 9, 2440x1220 | 2 | J Binnenplaat | 600 | 505 | 1261 | 509
Lightply 9, 2440x1220 | 2 | E Versterking kattenluik | 310 | 200 | 0 | 1018
Betonplex 12, 2500x1250 | 1 | A Vloerplaat beneden | 1140 | 709 | 0 | 0
Betonplex 12, 2500x1250 | 1 | G Vloerplaat bovenkamer | 1140 | 709 | 1144 | 0
Betonplex 12, 2500x1250 | 1 | N Trede | 150 | 247 | 2288 | 0
Betonplex 12, 2500x1250 | 1 | N Trede | 145 | 247 | 2288 | 251
Betonplex 12, 2500x1250 | 1 | N Versterkingsstrook trapboom | 630 | 30 | 0 | 713
Betonplex 12, 2500x1250 | 1 | N Trede | 247 | 100 | 0 | 753
Betonplex 12, 2500x1250 | 1 | N Trede | 247 | 100 | 251 | 753
Betonplex 12, 2500x1250 | 1 | N Trede | 247 | 100 | 502 | 753
Betonplex 12, 2500x1250 | 1 | N Trapboom | 815 | 130 | 0 | 857
Betonplex 12, 2500x1250 | 1 | N Trapboom | 815 | 130 | 819 | 857
Betonplex 12, 2500x1250 | 1 | M Onderplaat overstek links | 819 | 67 | 0 | 991
Betonplex 12, 2500x1250 | 1 | M Onderplaat overstek rechts | 819 | 67 | 823 | 991
Betonplex 12, 2500x1250 | 1 | M Onderplaat overstek achter | 1384 | 67 | 0 | 1062
Betonplex 12, 2500x1250 | 1 | M Onderplaat overstek voor | 1384 | 117 | 0 | 1133
OSB-3 11, 2440x1220 | 1 | M Dakplaat | 1384 | 1003 | 0 | 0
OSB-3 11, 2440x1220 | 1 | A Onderplaat vloer | 709 | 1140 | 1388 | 0
PIR 70, 1200x600 | 1 | L PIR plafond | 621 | 322 | 0 | 0
PIR 70, 1200x600 | 1 | F PIR wand | 543 | 417 | 623 | 0
PIR 70, 1200x600 | 1 | E PIR wand | 417 | 255 | 0 | 324
PIR 70, 1200x600 | 1 | E PIR boven doorgang | 200 | 107 | 419 | 324
PIR 70, 1200x600 | 2 | A PIR vloer | 621 | 527 | 0 | 0
PIR 70, 1200x600 | 2 | I PIR wand | 527 | 417 | 623 | 0
PIR 70, 1200x600 | 3 | G PIR tussenvloer | 621 | 481 | 0 | 0
PIR 70, 1200x600 | 3 | C PIR wand | 481 | 417 | 623 | 0
PIR 70, 1200x600 | 4 | L PIR plafond | 621 | 321 | 0 | 0
PIR 70, 1200x600 | 4 | D PIR wand | 499 | 417 | 623 | 0
PIR 70, 1200x600 | 4 | G PIR tussenvloer | 621 | 202 | 0 | 323
PIR 70, 1200x600 | 5 | L PIR plafond | 621 | 321 | 0 | 0
PIR 70, 1200x600 | 5 | K PIR wand | 499 | 417 | 623 | 0
PIR 70, 1200x600 | 5 | G PIR tussenvloer | 225 | 256 | 0 | 323
PIR 70, 1200x600 | 6 | I PIR wand | 417 | 481 | 0 | 0
PIR 70, 1200x600 | 6 | A PIR vloer | 621 | 481 | 419 | 0
PIR 70, 1200x600 | 7 | C PIR wand | 417 | 527 | 0 | 0
PIR 70, 1200x600 | 7 | J PIR wand | 417 | 499 | 419 | 0
