jeroenweij/kat/bouwplan/Betonplex_zaagplan_trap.dxf

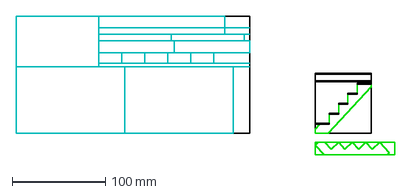
[picture p26: CAD file, 2026-11-10]
bouwplan/Betonplex_zaagplan_trap.dxf
405.0 x 148.0 mm
