jeroenweij/kat/matverwarming/Plaat.dxf

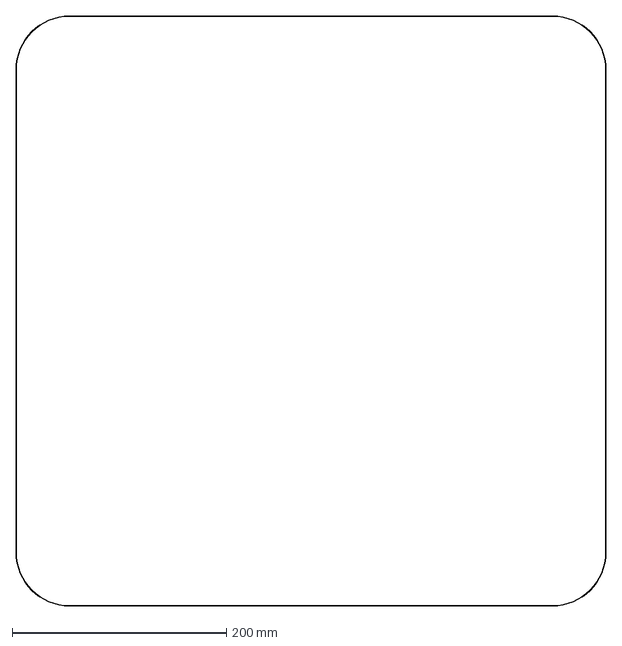
[picture p27: CAD file, 2026-11-11]
matverwarming/Plaat.dxf
550.0 x 550.0 mm
