jeroenweij/kat/matverwarming/Ontwerp.dxf

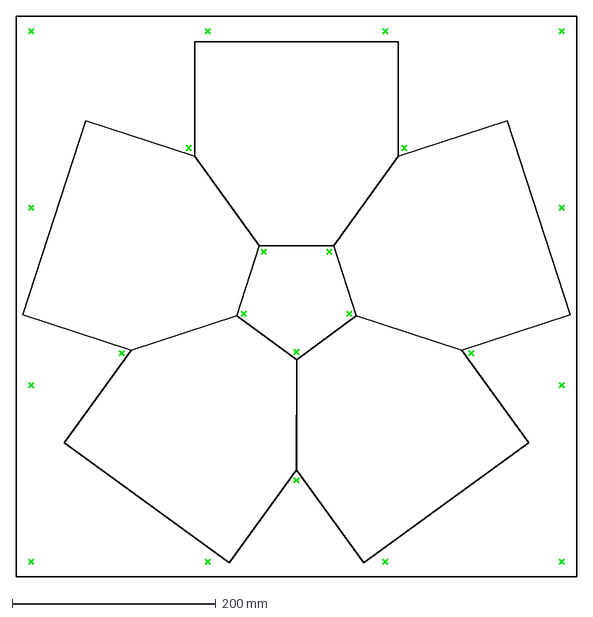
[picture p28: CAD file, 2026-11-11]
matverwarming/Ontwerp.dxf
550.0 x 550.0 mm
