jeroenweij/kat/matverwarming/heater_segment_vorm.dxf

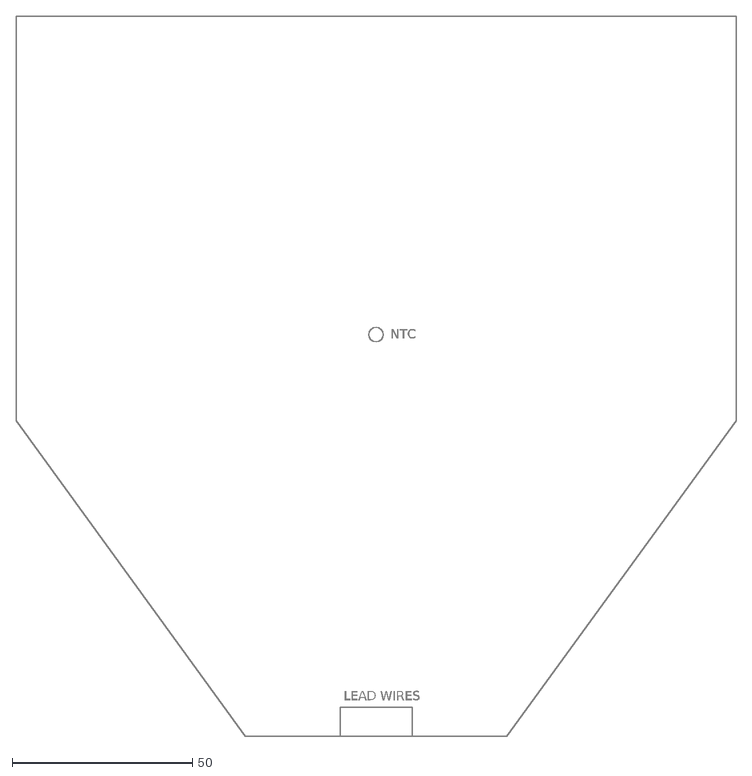
[picture p29: CAD file, 2026-11-08]
matverwarming/heater_segment_vorm.dxf
LEAD WIRES
NTC
