jeroenweij/kat/(commit log)

2026-11-06 Bouwplan kattenchalet, Rev I
    Tekeningen, zaag- en inkooplijsten, berekeningen en de bronscripts,
    plus de oorspronkelijke projectoverdracht en het inspiratiebeeld.
    [Kattenchalet_zaag_en_inkooplijst.xlsx]
2026-11-06 Bouwplan kattenchalet, Rev K
    Compacter chalet met het bovenraam precies tussen de wanden en 600 mm
    binnendiepte. Wanden in 44x69 met PIR 70, nu buitenmaat 1236 x 789.
    Plaatsing op het terras in Rijswijk: poeren onder de tegels met
    U-paalhouders in vers beton.
    Materiaalkeuzes: dak OSB-3 11, binnenwanden Elliotis Pine met TENCO
    Bootlak, gevel grenen beits, vloer beneden met PIR en OSB-onderplaat,
    ventilatie Ø100. Lekdorpel tegen de band en raambevestiging volgens de
    ARON-aanbeveling, aangepast aan de houten wand.
    Inkooplijst bijgewerkt, met de eigen betonplex-zaagpuzzel erbij.
    [Betonplex_zaagplan_trap.dxf, Kattenchalet_zaag_en_inkooplijst.xlsx]
2026-11-06 Trap 45 graden met zaagtandbomen, versterkingsstrook
    Trap volgens de eigen tekening: looplengte gelijk aan de stijging, 6
    optreden van 99, treden 110 x 247 op de tanden. De vrije rechterboom krijgt
    een gelijmde strook van 580 x 30 langs de onderkant.
    Betonplex-zaagplan aangepast aan de maten van Rev K.
    [Betonplex_zaagplan_trap.dxf, Kattenchalet_zaag_en_inkooplijst.xlsx]
2026-11-06 Betonplex-zaagplan: treden op 24,7 cm
    [Betonplex_zaagplan_trap.dxf]
2026-11-06 Regenluifel antraciet tussen de hoeklatten, beits 750 ml
    Luifel 1120 x 91 x 18, 12 mm aflopend naar voren, op 5 RVS consoles met
    EPDM-rest en druiprand. Antraciet beits naar 750 ml: 375 ml is te weinig
    voor 3 lagen rondom.
    [Kattenchalet_zaag_en_inkooplijst.xlsx]
2026-11-06 Achterplaat over de volle breedte, 10 spouwlatten
    De binnenplaat van de achterwand loopt op beide verdiepingen uit een stuk
    door en de zijwanden en scheidingswand stoppen ertegen, zodat de plaat in
    de hoeken houvast heeft. De doorgang schuift daardoor 9 mm naar voren.
    Spouwlatten mogen uit meerdere stukken bestaan: 10 latten in plaats van 13,
    met regels voor de naden. De lattenindeling kiest bij bijna gelijke prijs
    nu de oplossing met minder stukken.
    [Kattenchalet_zaag_en_inkooplijst.xlsx]
2026-11-06 Lattenindeling 44x69 volgens de Inkoop-tab
    Zet de mix vast op 5 x 3600 en 9 x 2400 en haalt de toeslag per stuk uit
    e85ac01 weg, die de lijst naar 11 x 3600 stuurde.
    [Kattenchalet_zaag_en_inkooplijst.xlsx]
2026-11-08 ESP home config, Matverwarmer design
    [Ontwerp.dxf, heater_segment_vorm.dxf]
2026-11-09 Stappenplan herschreven en modelcorrecties (Rev K)
    - Stappenplan doorgelopen als leek en herschreven: bouwvolgorde, verbindingen,
    maten van sparingen, kabels, folie rond de ventilatiebuis, watertest na de ramen.
    - Achterbalken 44 x 69, balken 621; sporen en dakplaat binnen de boeiboorden,
    zijsporen met rijklossen.
    - Verandaplaten tot achter de kaderstijl (653).
    - Chalet 1220 breed: stijlen strak tegen de kozijnen, 1 mm speling per kant,
    geen compriband en zijwiggen meer.
    - Scheidingswand 44 x 69 met PIR.
    - Verticale maten op plattegronden, vloerframe, dak en wandframes.
    - Inkoop bijgewerkt, inclusief de bestelling bij Dakvoordeelshop.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
    [Kattenchalet_zaag_en_inkooplijst.xlsx]
2026-11-09 Voeding vanuit de schuur: 24 V, Orion naar 12,2 V, zachte start verwarmer
    - controller/VOEDING.md: energiebehoefte bovenkamer bij 8 °C, fase 1
    (24 V-voeding 250 W in de schuur, H07RN-F 3G2,5, Orion-Tr 24/12-20 in de
    chalet), fase 2 (24 V-accu, zon en noodstroom in de schuur), afgevallen
    opties en open punten.
    - ESPHome: afschakelgrenzen 11,5/11,3 V als vangnet onder de 12,2 V van de
    Orion; zachte start van de verwarmer via LEDC-PWM op GPIO 23.
    - CLAUDE.md, LEESMIJ en nalevering-plan bijgewerkt.
2026-11-10 Kattenluik in de scheidingswand, dakmaterialen besteld
    - Kattenluik PetSafe 700 S in de verandaplaat van wand E met versterking
    (18 mm), onderkant 120 boven de vloer; doorgang trapzijde 200 x 310.
    - Luchtinlaat 140 x 70 laag onder het luik, PIR boven de latei;
    trekhoogte in de berekening vanaf deze inlaat.
    - Nieuw blad T14 met aanzichten, doorsneden en plaatsingsnotities.
    - Wand E: stijl achter de doorgang tot op de vloer. Wand F: geen dubbele
    voorste stijl, middenstijl in het midden.
    - Inkoop: EPDM, lijm, kit en daktrim van Dakvoordeelshop; stappenplan
    stap 10 daarop aangepast.
    [Kattenchalet_zaag_en_inkooplijst.xlsx]
2026-11-10 Matverwarming: JLCPCB ontwerpt het spoor, heater.py verwijderd
    JLCPCB tekent het heaterspoor zelf en stuurde een productietekening ter
    controle (12 V, 36 Ω, 4 W per segment). Opmerkingen voor JLCPCB (haakse
    hoek links, grotere pads) staan in tmp/, dat nu git-ignored is.
    Mat nu ca. 20 W, nominaal 0,33 A per segment.
2026-11-10 Trap naar eigen ontwerp, vaste zaagplannen en zaagopdrachten bouwmarkt, Lightply
    - Trap: treden 150, 3 x 100 en 145 diep, sluitend op elkaar; zaagtandboom
    uit 770 x 130, versterkingsstrook 630 x 30 (detail 6).
    - Betonplex volgens de indeling uit Betonplex_zaagplan_trap.dxf, met de
    maten uit het model: 9 sneden bij de bouwmarkt, restplaat 854 x 537
    rechtsboven (nieuw blad T15).
    - Vaste guillotineplannen voor betonplex, wandplaat en OSB in plate_plans,
    met controles op passen, nazagen en gestapelde stroken.
    - Nieuw: Kattenchalet_zaagplannen_bouwmarkt.pdf, één A4 per plaat met alleen
    de genummerde sneden voor de bouwmarkt.
    - Wandbekleding LIGHTPLY multiplex 9 mm (art. 12575686) in p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
    [Betonplex_zaagplan_trap.dxf, Kattenchalet_zaag_en_inkooplijst.xlsx]
2026-11-10 Trap omgekeerd: voet tegen de achterwand, trapgat linksvoor, lip aan de vrije boom
    - De trap stijgt van achter naar voor; de bovenkant blijft 5 mm achter het
    lage kozijn. Onder de bovenste treden ontstaat een ligplek bij het raam.
    - Trapgat 247 x 343 linksvoor, achter de rand voor en een dagkant; raveelbalk
    erachter, de PIR-strook achter het trapgat vervalt.
    - De vrije rechterboom krijgt bovenaan een lip van 40 breed die in de balk
    rechts van het trapgat wordt geschroefd; inkeping in de bovenste trede.
    Plaatstuk trapbomen 815 x 130.
    - Nieuwe controle stringer_clashes() op de werkelijke vorm van de bomen.
    - Teksten (stappenplan, ventilatie, kattenveiligheid, plattegronden) en
    detail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
    [Kattenchalet_zaag_en_inkooplijst.xlsx]
2026-11-11 boodschappenlijstje toevoegen"
    [Kattenchalet_bestellijst.xlsx, Kattenchalet_zaag_en_inkooplijst.xlsx, Ontwerp.dxf, Plaat.dxf]
2026-11-11 Ruime balkvakken, bouwplan volledig op A4 en ingekort
    - Balken en stijlen alleen waar ze vastliggen: vloer en achterwanden 3,
    tussenvloer 4, zijwanden 2 stijlen; plafond en sporen 4 (ca. 365 h.o.h.)
    vanwege de 11 mm OSB. Wand E houdt zijn stijlen voor het kattenluik.
    Inkoop: vuren 44x69 3 + 11, spouwlatten 9.
    - Tekenbladen als losse A4-tekeningen (T2a, T2b, ...), elk gecentreerd;
    T15 alleen nog thuis zagen (trapbomen en stroken).
    - Uitgangspunten, berekeningen en inkooplijst vervangen door een
    titelpagina; verwarming en stroom uit het bouwplan.
    [Kattenchalet_zaag_en_inkooplijst.xlsx]
2026-11-12 Stappenplan bijgewerkt voor de ruime balkvakken; trapboom verlijmd
    - Trapboom aan wand D: schroeven alleen in de voorste en achterste stijl
    en de regels, want D heeft geen middenstijl meer.
    - Linkertrapboom over het hele vlak met PU-lijm tegen de wandplaat, lak en
    filmlaag eerst opgeschuurd, van buitenaf aangedrukt met RVS 3,5 x 16.
    - Afdekzeil tot het dak in stap 9 dicht is (stond stap 10).
2026-11-12 Fundering op stelvoeten los op de tegels, chalet 5 cm lager
    - Betonpoeren en U-paalhouders vervallen: 6 poten van 95 op Hettich
    stelvoeten M10 met inslagmoer, los op de tegels. Later vast aan de
    schutting (nieuwe stap 15); tot dan letten op windwaarschuwingen.
    - Vloerframe op 130 i.p.v. 180: instap veranda 211 i.p.v. 261. Gevel
    loopt 15 mm onder het frame door; onderste plank vervangbaar.
    - Detail 4, stappenplan, onderhoud, berekening, Inkoop, bestellijst
    en boodschappenlijst bijgewerkt.
    [Kattenchalet_bestellijst.xlsx, Kattenchalet_zaag_en_inkooplijst.xlsx]
2026-11-12 Stappenplan: schutting in de achterrand van het plafond, zijlat zonder rand
    - Stap 15: op plafondhoogte zit geen stijl; de afstandhouders gaan door
    gevelplank en spouwlat in de achterrand van het plafond.
    - Stap 11: de middelste zijlat kruist alleen regels en zijbalken.
